Sembazuru/USB-breakout/ClubJameco/Pictures/Image15 - Receptacle-side Test Points placed top.JPG

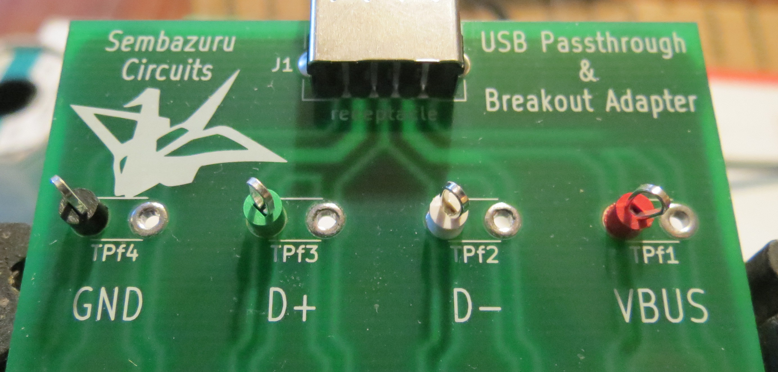
ClubJameco/Pictures/Image15 - Receptacle-side Test Points placed top.JPG
