Sembazuru/USB-breakout/ClubJameco/Pictures/Step8 Collage.jpg

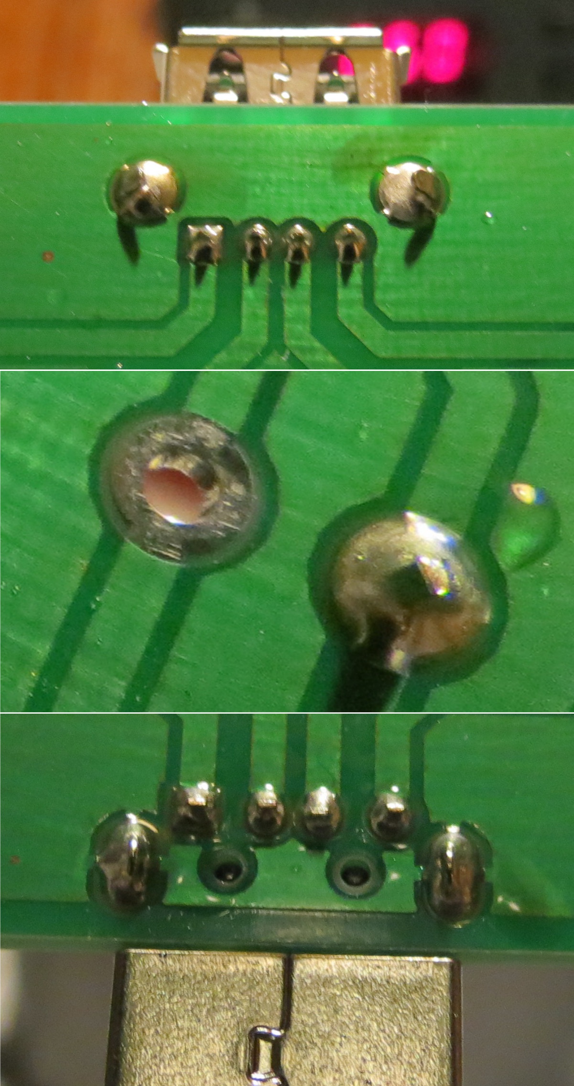
ClubJameco/Pictures/Step8 Collage.jpg
