Sembazuru/USB-breakout/ClubJameco/Pictures/Image02 - Ready to work.JPG

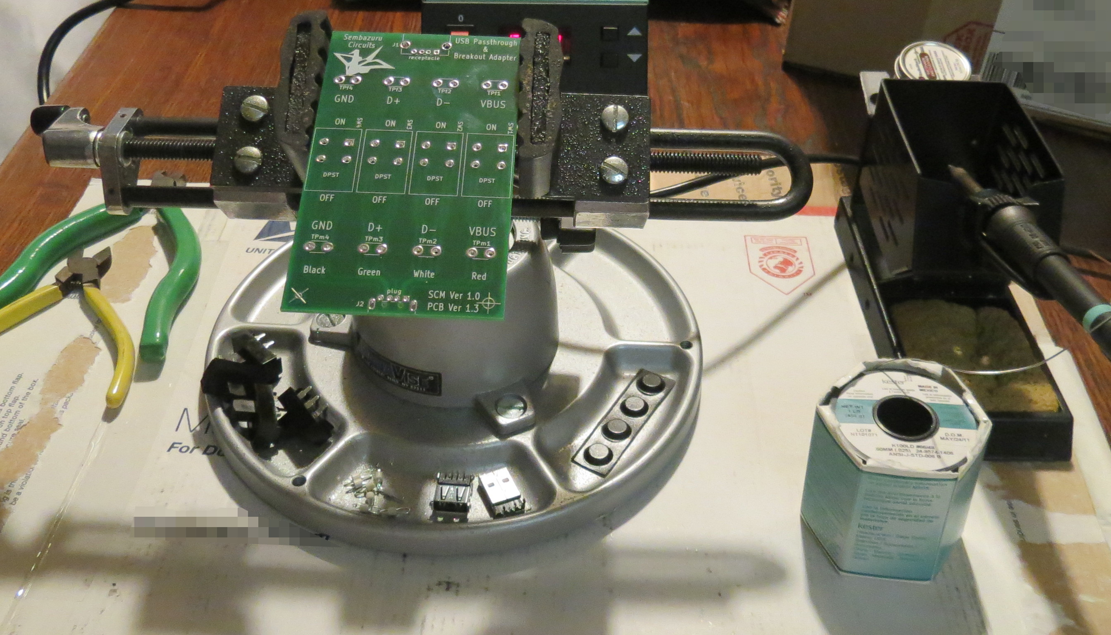
ClubJameco/Pictures/Image02 - Ready to work.JPG
