Sembazuru/USB-breakout/ClubJameco/Pictures/Image03 - Place first switch.JPG

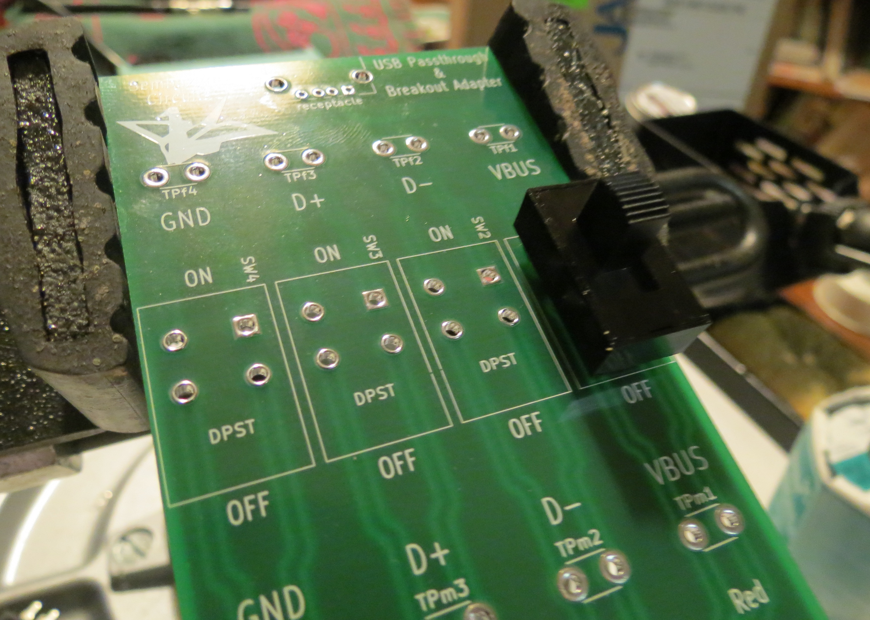
ClubJameco/Pictures/Image03 - Place first switch.JPG
