Sembazuru/USB-breakout/ClubJameco/Pictures/Image04 - Tape first switch.JPG

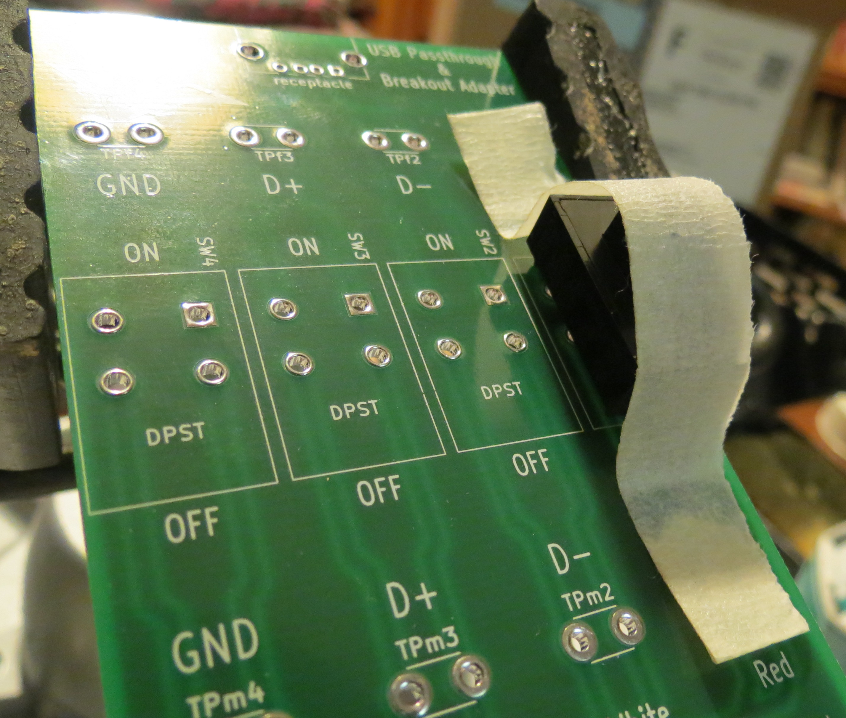
ClubJameco/Pictures/Image04 - Tape first switch.JPG
