Sembazuru/USB-breakout/ClubJameco/Pictures/Image05 - Tape all switches.JPG

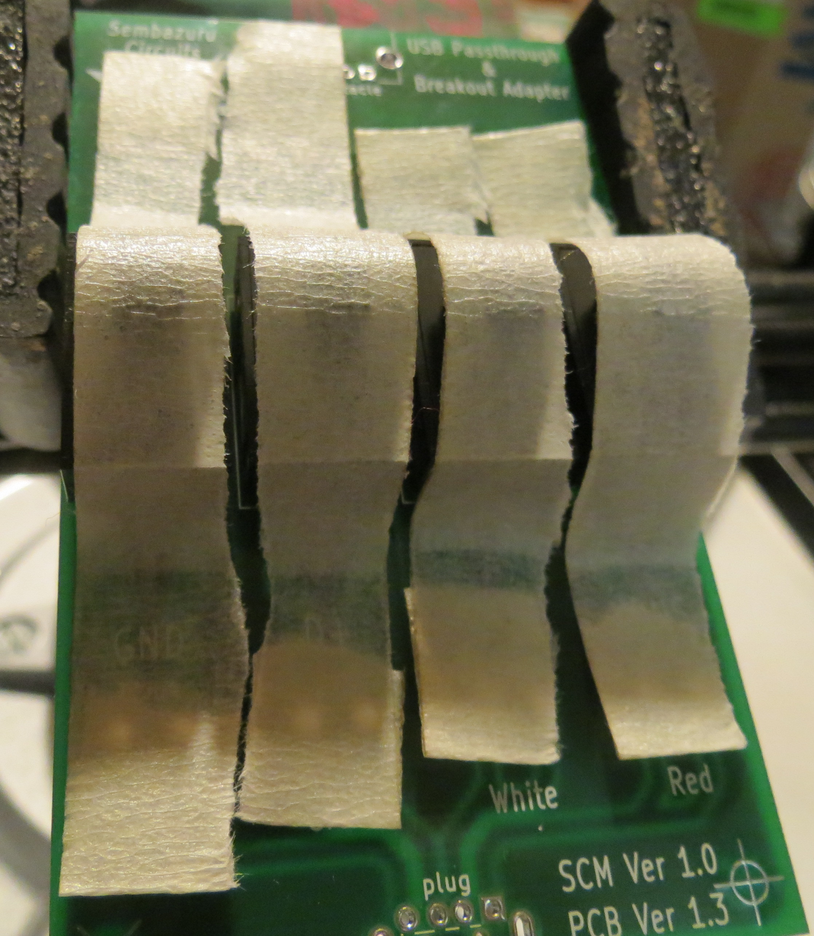
ClubJameco/Pictures/Image05 - Tape all switches.JPG
