Sembazuru/USB-breakout/ClubJameco/Pictures/Image08 - Check switch alignment.JPG

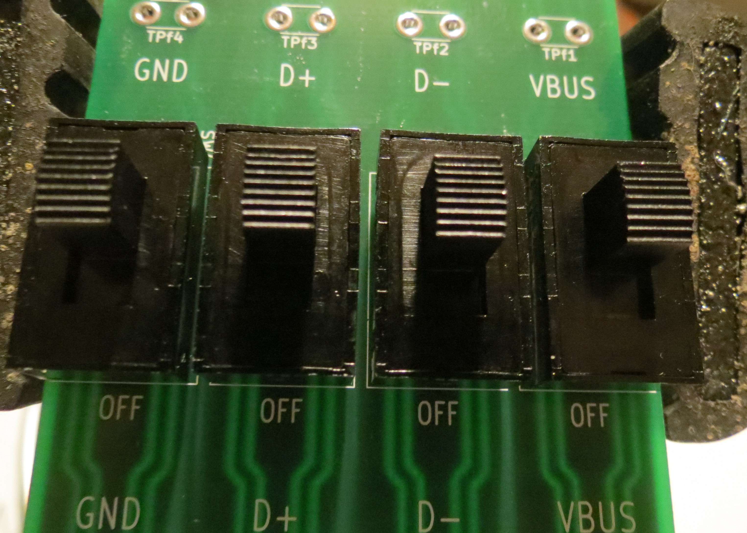
ClubJameco/Pictures/Image08 - Check switch alignment.JPG
