Sembazuru/USB-breakout/ClubJameco/Pictures/Image11 - Receptacle placed top.JPG

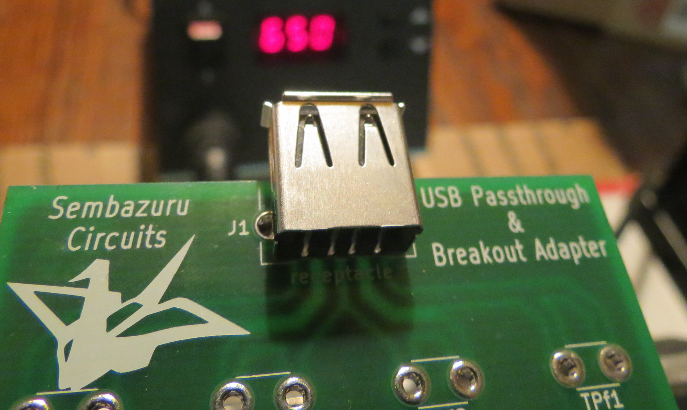
ClubJameco/Pictures/Image11 - Receptacle placed top.JPG
