Sembazuru/USB-breakout/ClubJameco/Pictures/Image12 - Receptacle placed bottom.JPG

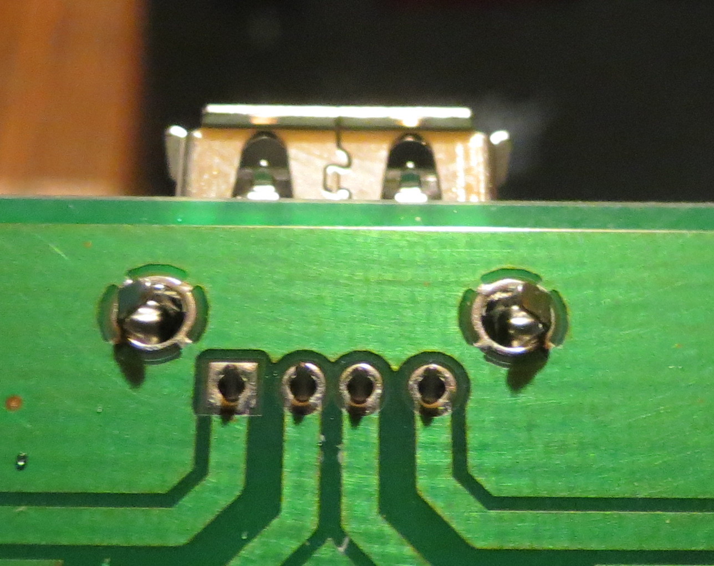
ClubJameco/Pictures/Image12 - Receptacle placed bottom.JPG
