Sembazuru/USB-breakout/ClubJameco/Pictures/Image13 - Plug placed top.JPG

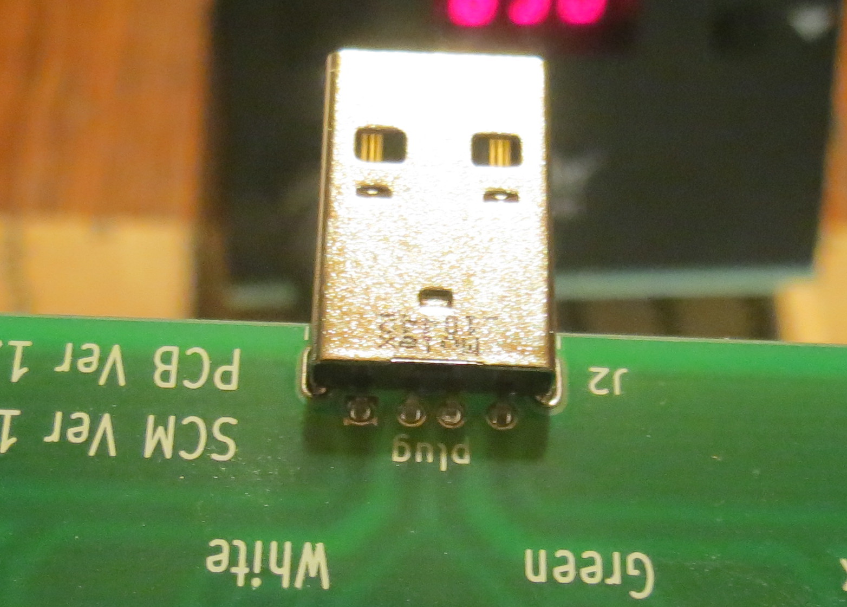
ClubJameco/Pictures/Image13 - Plug placed top.JPG
