Sembazuru/USB-breakout/ClubJameco/Pictures/Image14 - Plug placed bottom.JPG

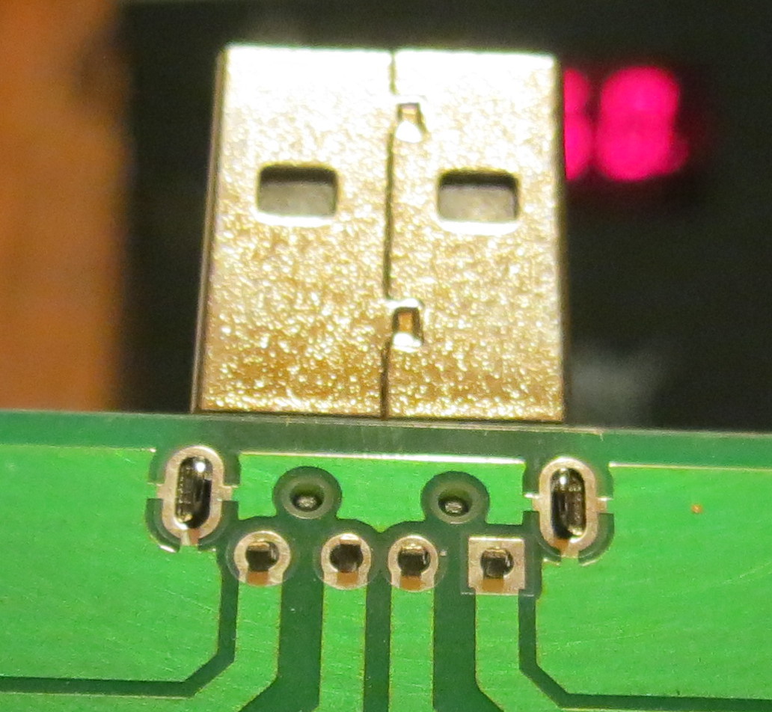
ClubJameco/Pictures/Image14 - Plug placed bottom.JPG
