Sembazuru/USB-breakout/ClubJameco/Pictures/Image24 - Feet added.JPG

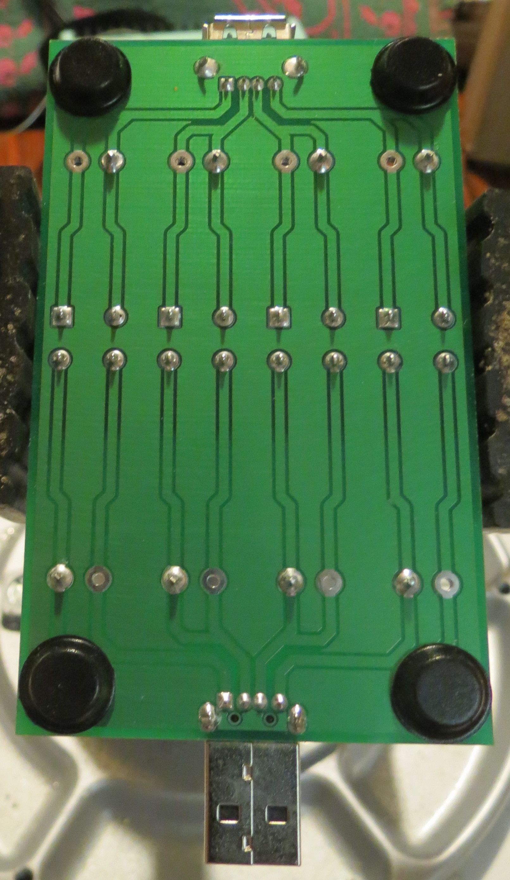
ClubJameco/Pictures/Image24 - Feet added.JPG
