Sembazuru/USB-breakout/ClubJameco/Pictures/IMG_1003.JPG

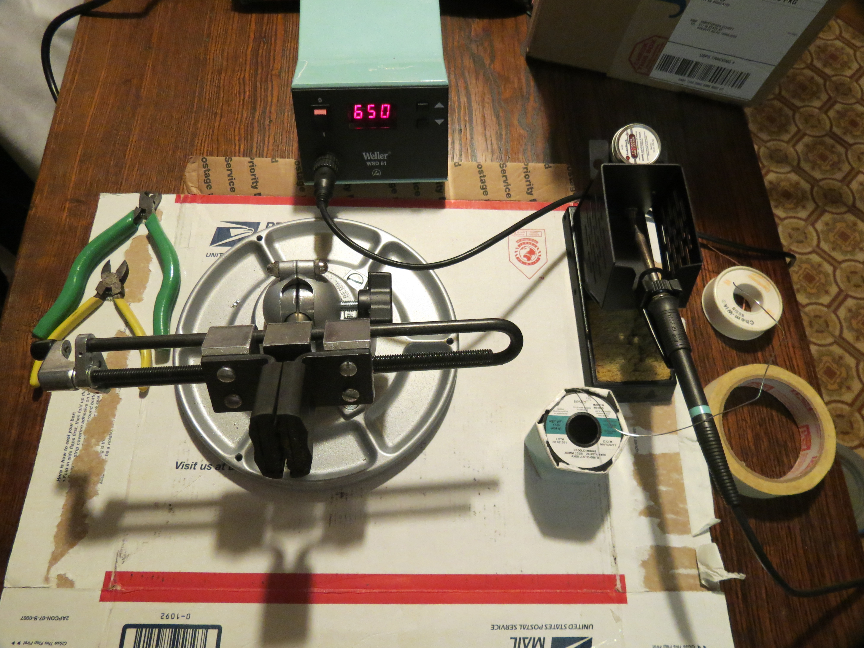
ClubJameco/Pictures/IMG_1003.JPG
