Sembazuru/USB-breakout/ClubJameco/Pictures/IMG_1005.JPG

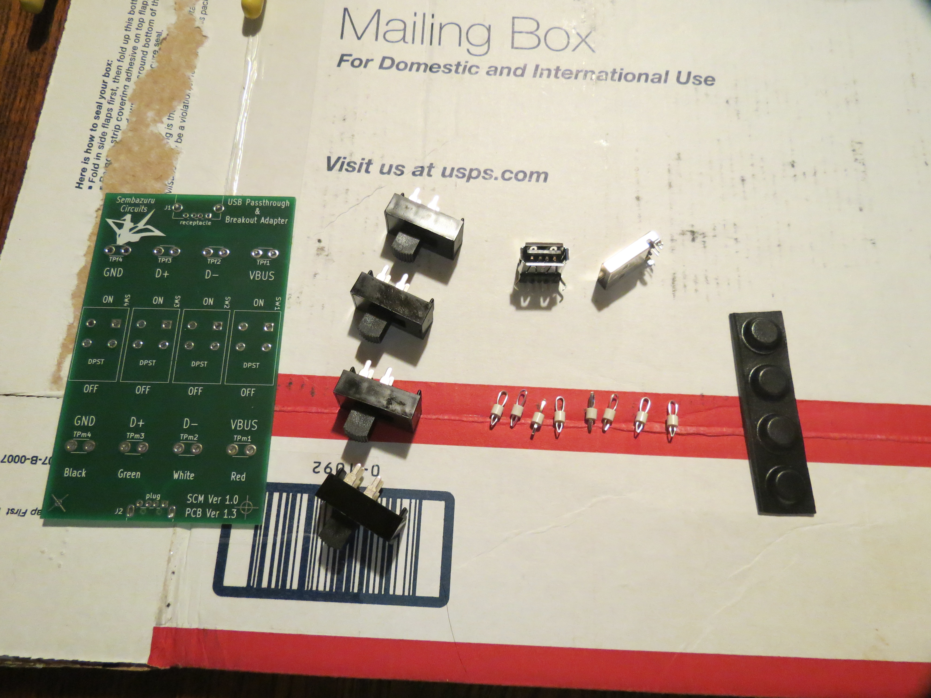
ClubJameco/Pictures/IMG_1005.JPG
