Sembazuru/USB-breakout/ClubJameco/Pictures/IMG_1007.JPG

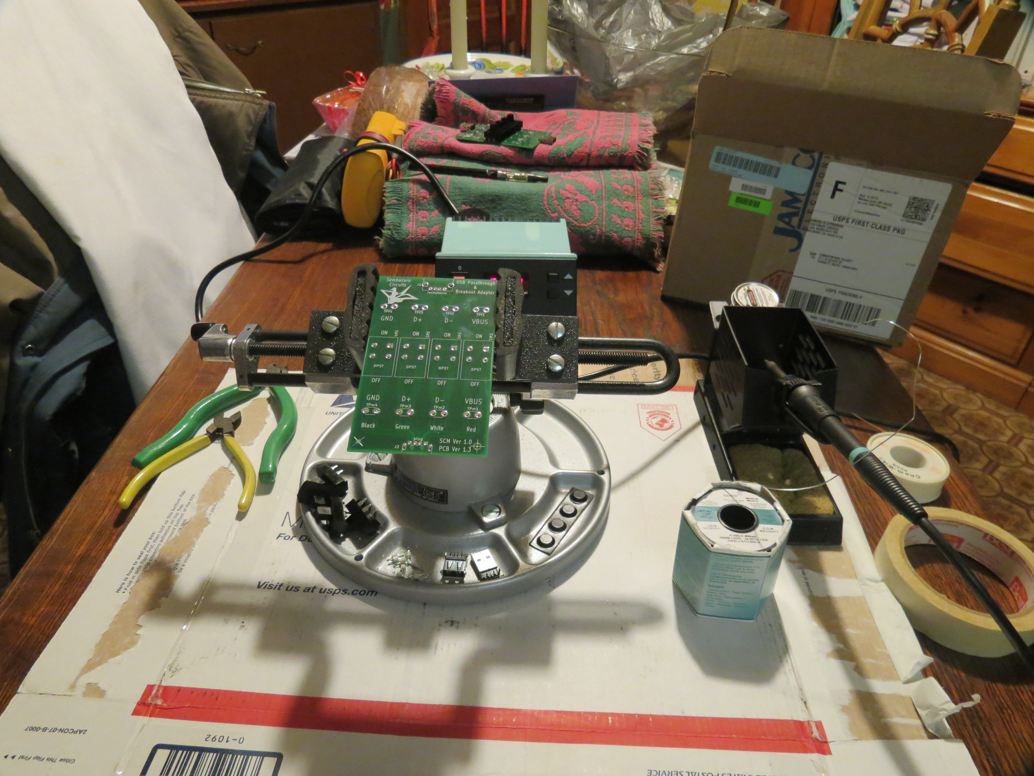
ClubJameco/Pictures/IMG_1007.JPG
