Sembazuru/USB-breakout/ClubJameco/Pictures/IMG_1008.JPG

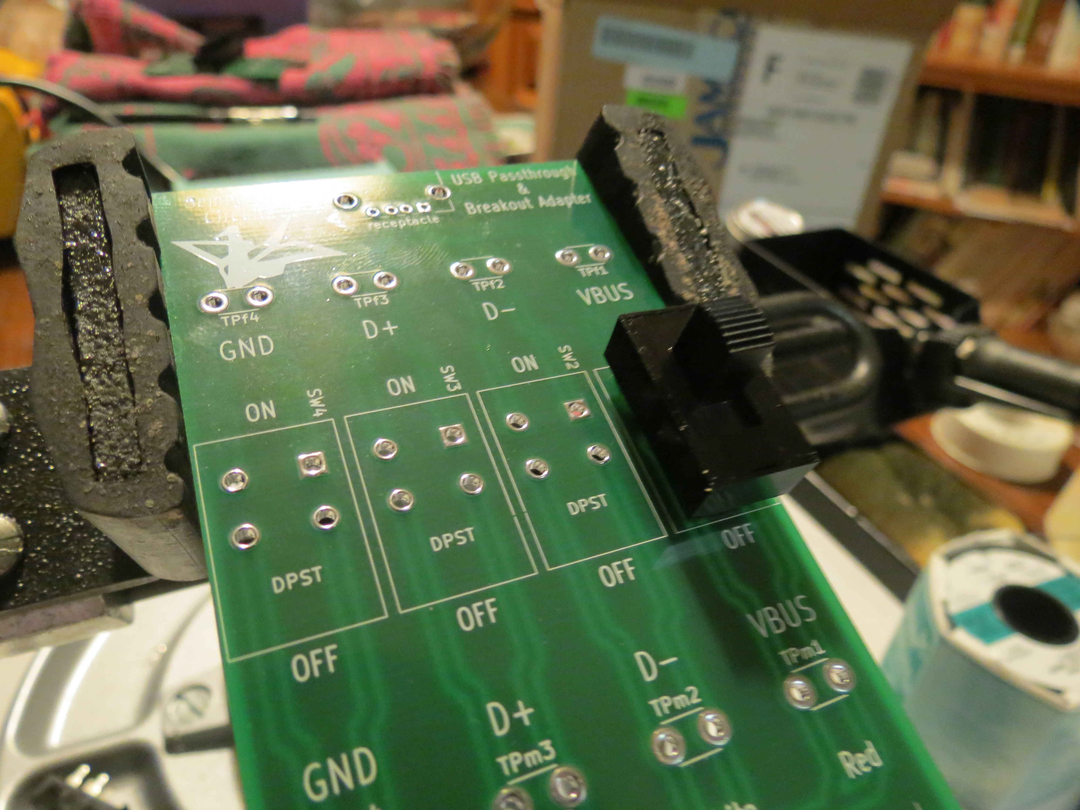
ClubJameco/Pictures/IMG_1008.JPG
