Sembazuru/USB-breakout/ClubJameco/Pictures/IMG_1009.JPG

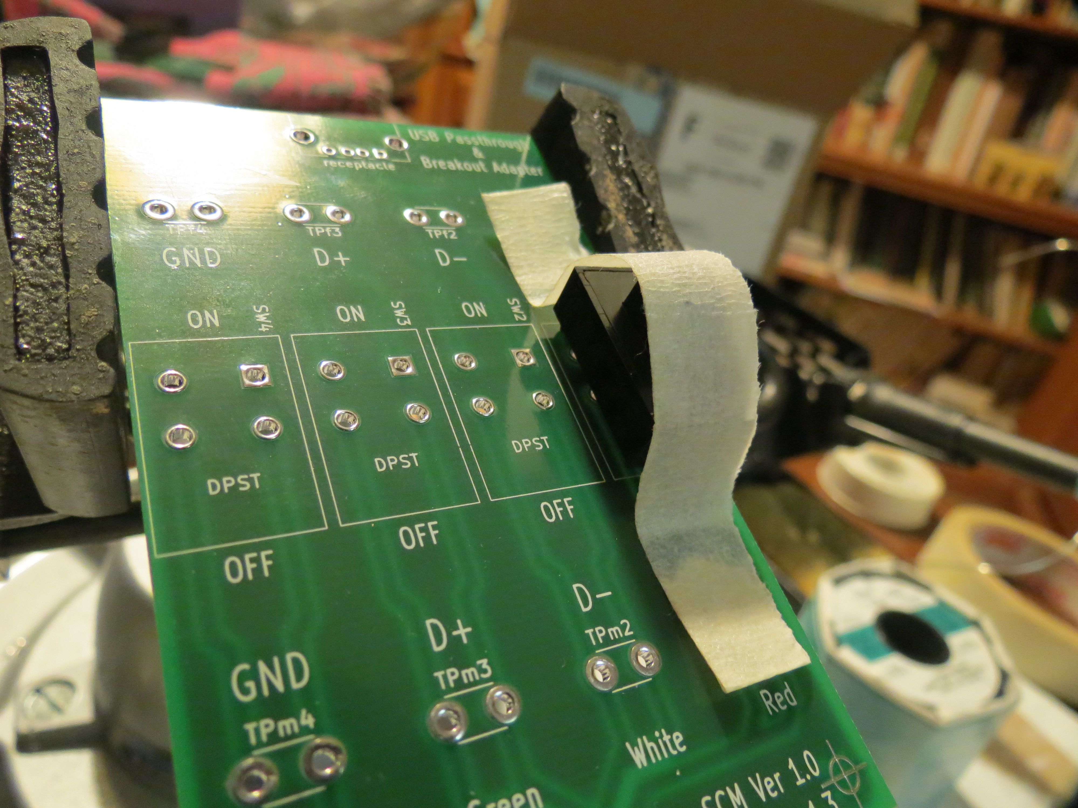
ClubJameco/Pictures/IMG_1009.JPG
