Sembazuru/USB-breakout/ClubJameco/Pictures/IMG_1010.JPG

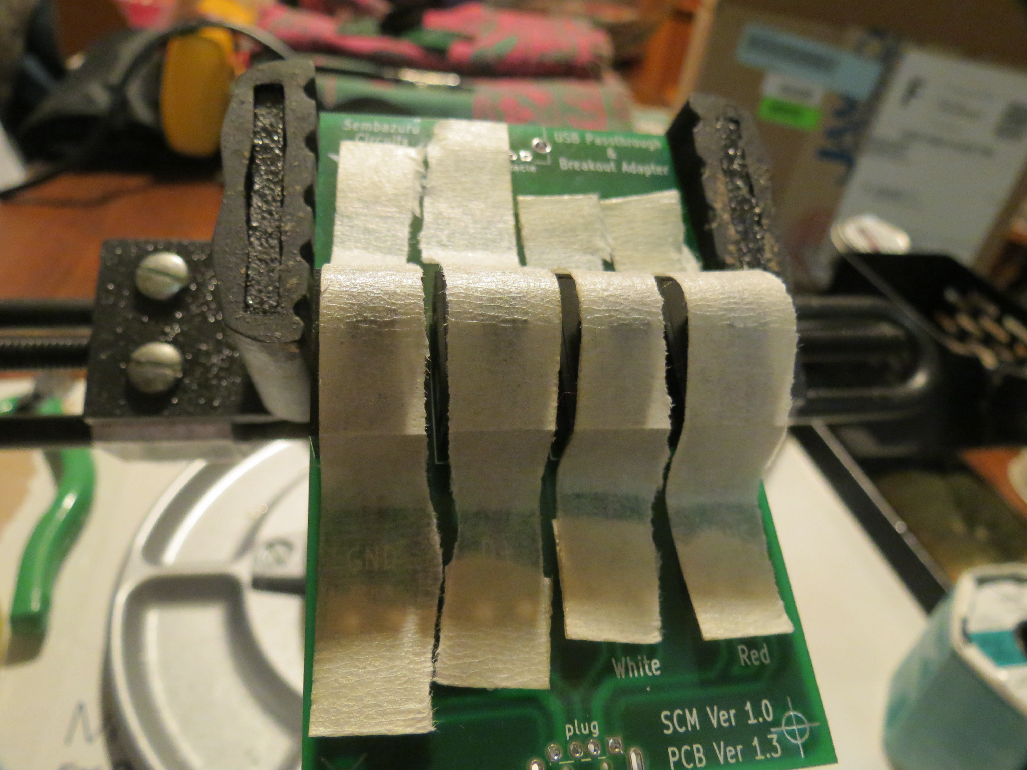
ClubJameco/Pictures/IMG_1010.JPG
