Sembazuru/USB-breakout/ClubJameco/Pictures/IMG_1011.JPG

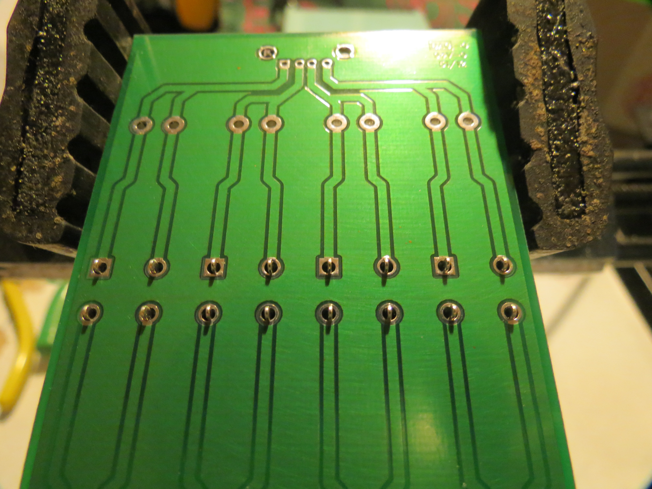
ClubJameco/Pictures/IMG_1011.JPG
