Sembazuru/USB-breakout/ClubJameco/Pictures/IMG_1012.JPG

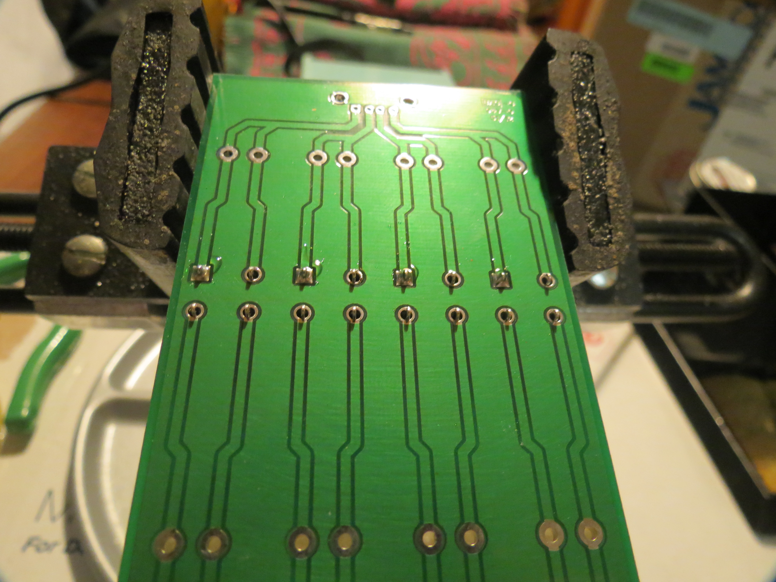
ClubJameco/Pictures/IMG_1012.JPG
