Sembazuru/USB-breakout/ClubJameco/Pictures/IMG_1013.JPG

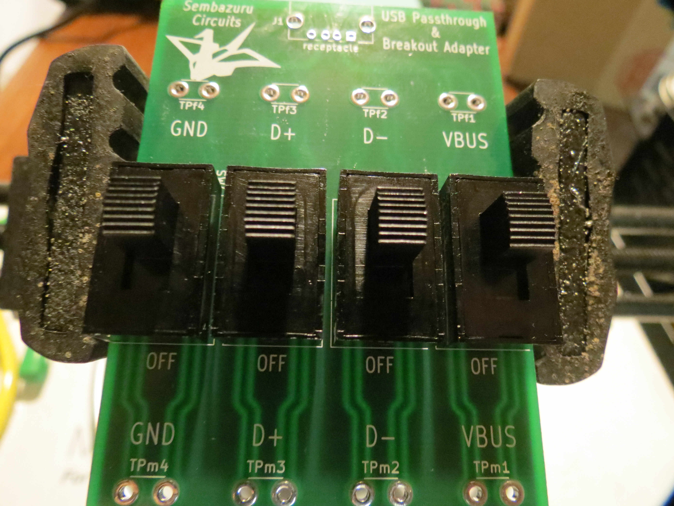
ClubJameco/Pictures/IMG_1013.JPG
