Sembazuru/USB-breakout/ClubJameco/Pictures/IMG_1014.JPG

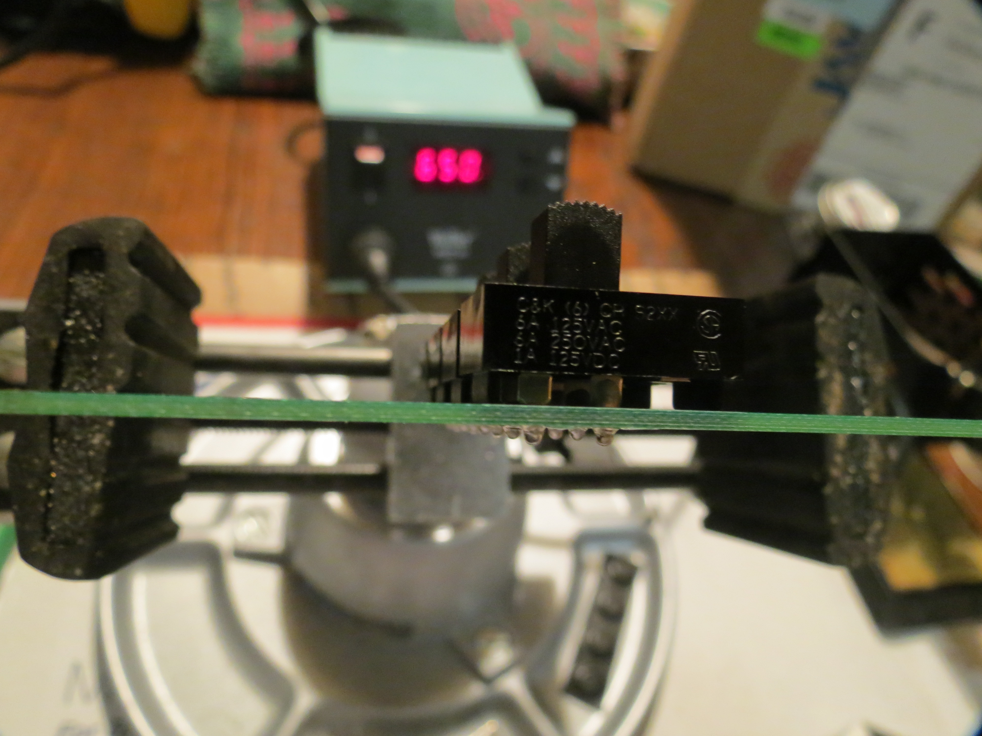
ClubJameco/Pictures/IMG_1014.JPG
