Sembazuru/USB-breakout/ClubJameco/Pictures/IMG_1015.JPG

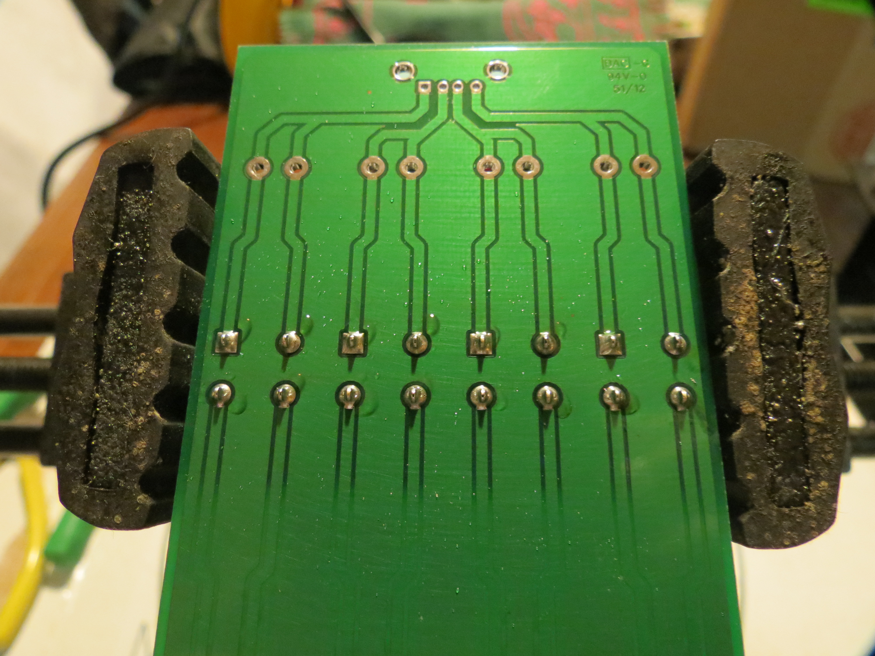
ClubJameco/Pictures/IMG_1015.JPG
