Sembazuru/USB-breakout/ClubJameco/Pictures/IMG_1016.JPG

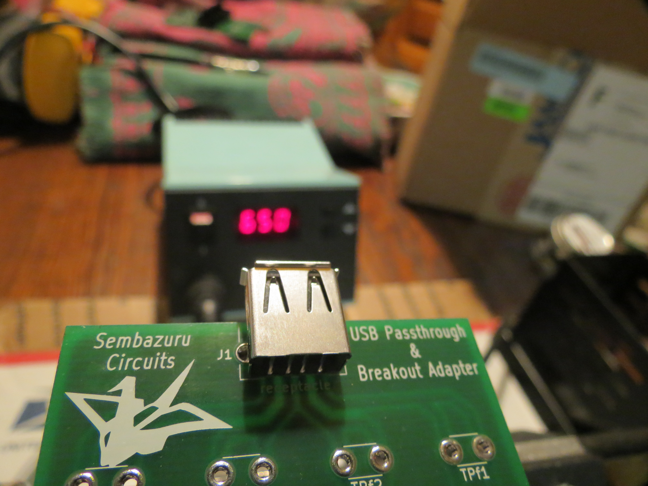
ClubJameco/Pictures/IMG_1016.JPG
