Sembazuru/USB-breakout/ClubJameco/Pictures/IMG_1017.JPG

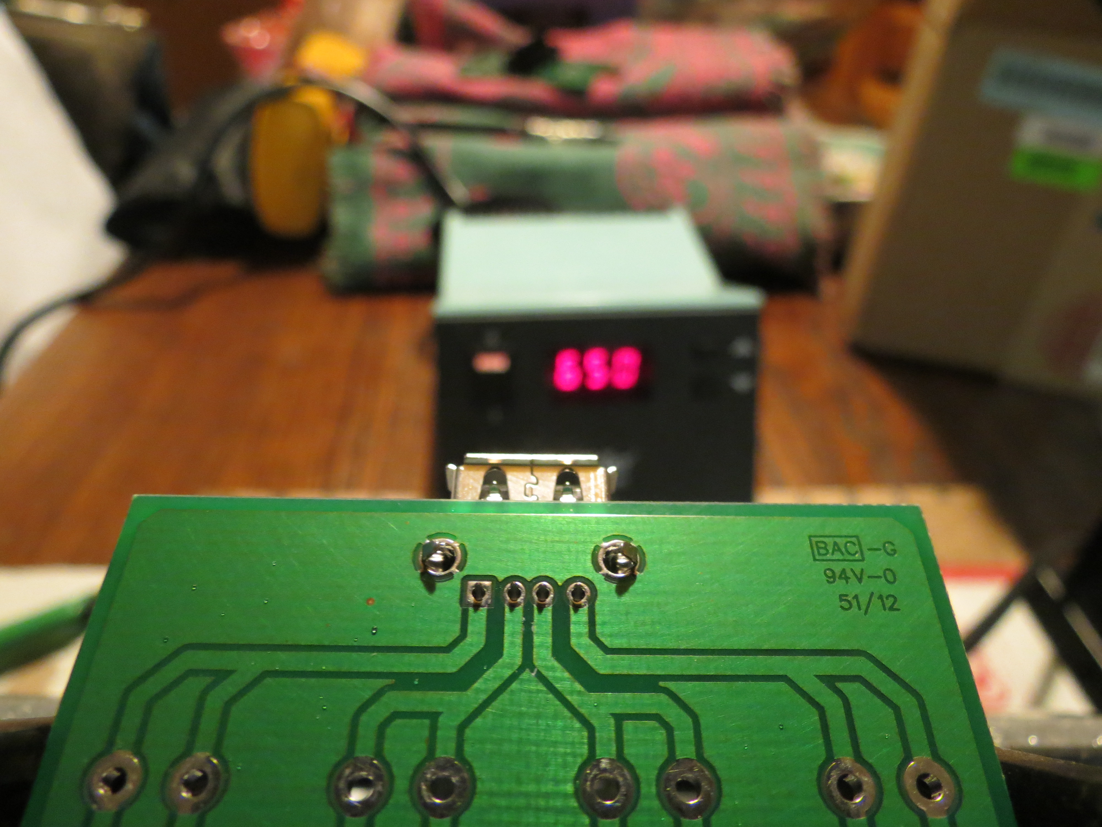
ClubJameco/Pictures/IMG_1017.JPG
