Sembazuru/USB-breakout/ClubJameco/Pictures/IMG_1018.JPG

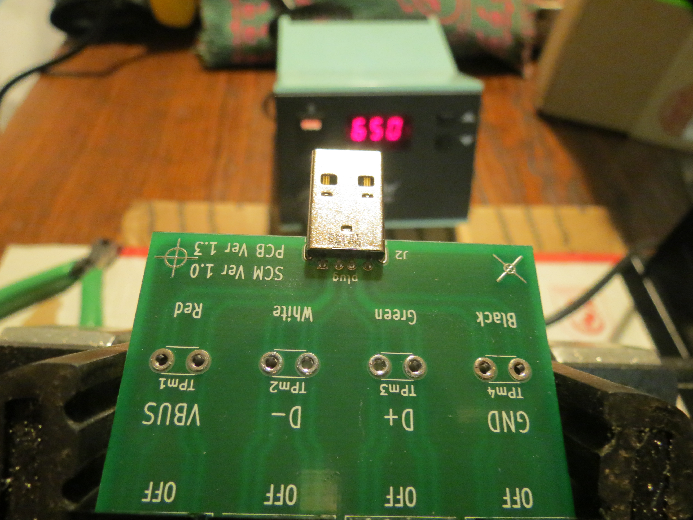
ClubJameco/Pictures/IMG_1018.JPG
