Sembazuru/USB-breakout/ClubJameco/Pictures/IMG_1019.JPG

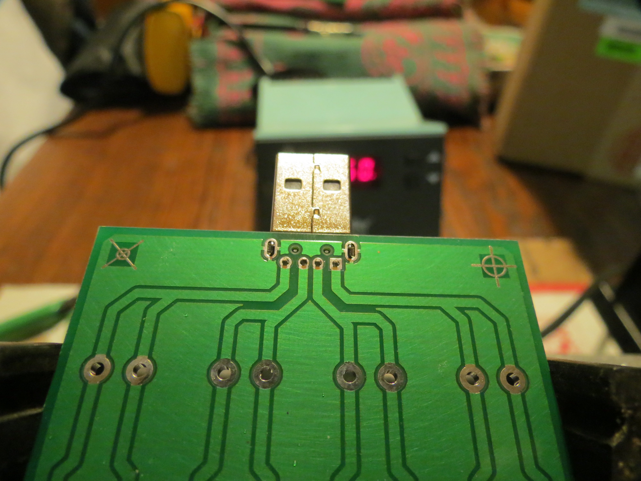
ClubJameco/Pictures/IMG_1019.JPG
