Sembazuru/USB-breakout/ClubJameco/Pictures/IMG_1022.JPG

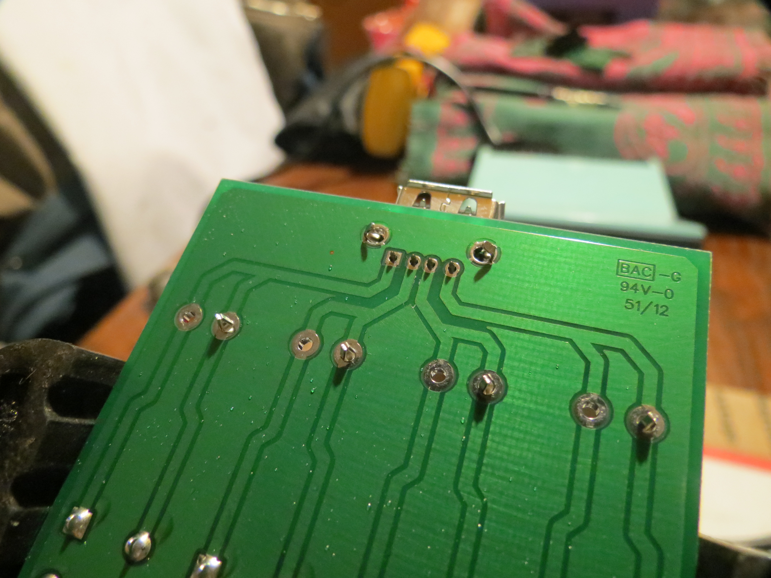
ClubJameco/Pictures/IMG_1022.JPG
