Sembazuru/USB-breakout/ClubJameco/Pictures/IMG_1024.JPG

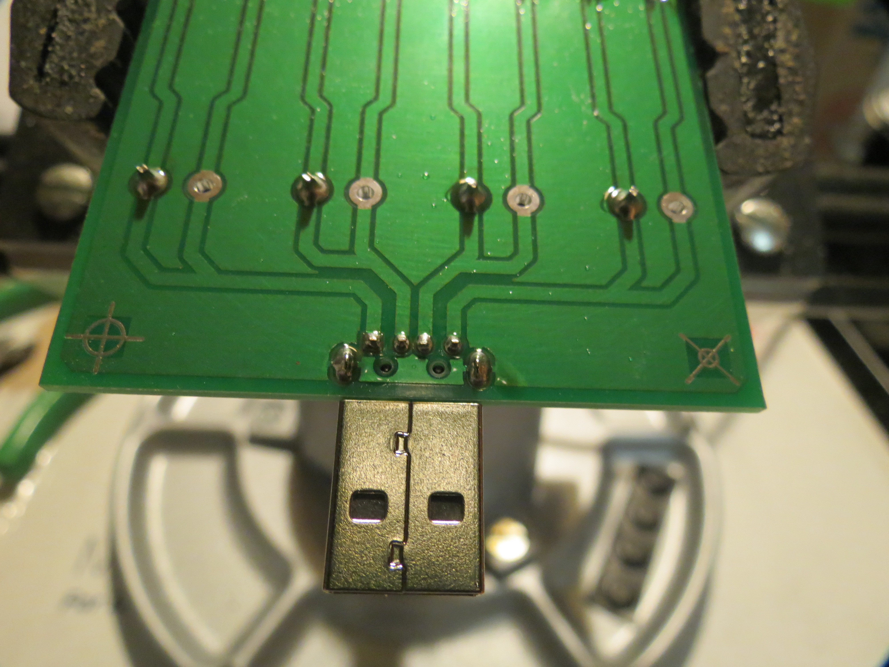
ClubJameco/Pictures/IMG_1024.JPG
