Sembazuru/USB-breakout/ClubJameco/Pictures/IMG_1025.JPG

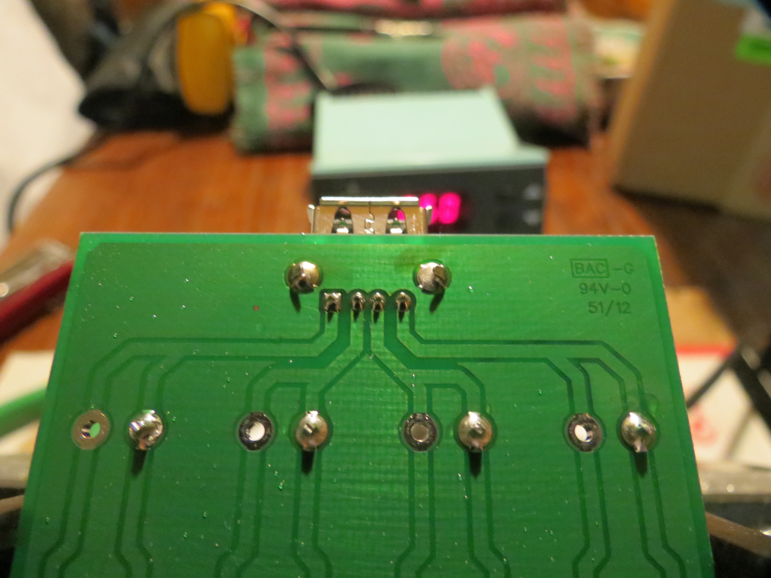
ClubJameco/Pictures/IMG_1025.JPG
