Sembazuru/USB-breakout/ClubJameco/Pictures/IMG_1026.JPG

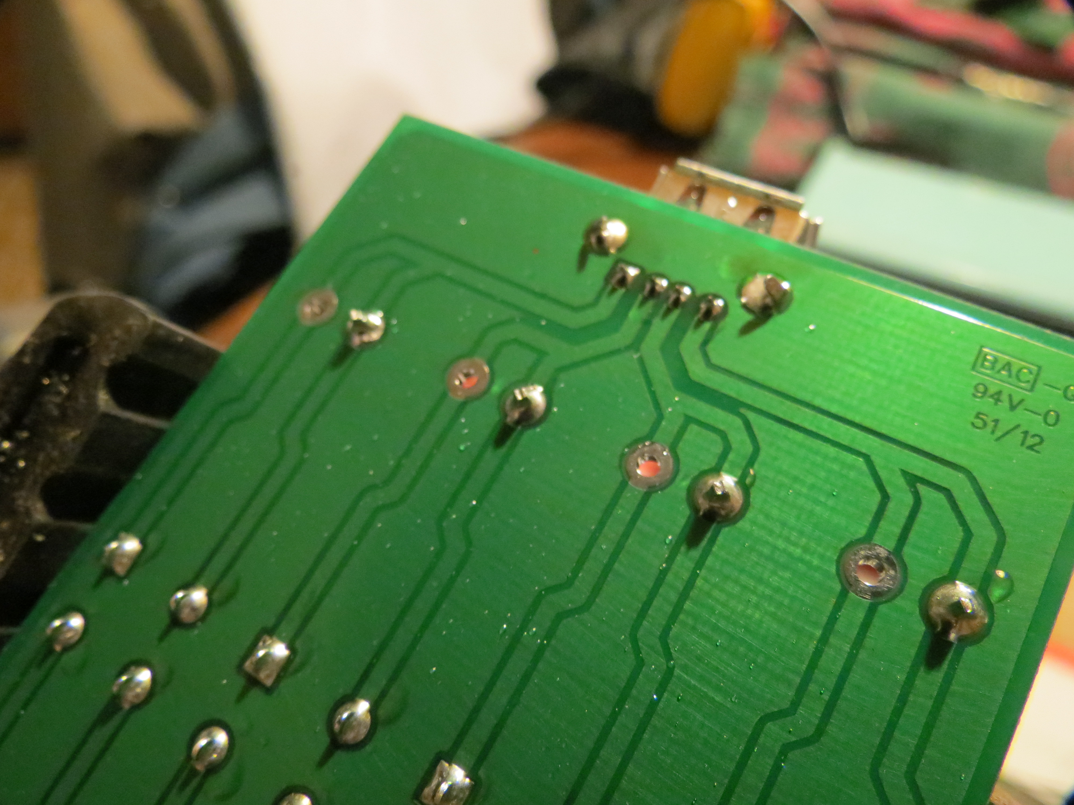
ClubJameco/Pictures/IMG_1026.JPG
