Sembazuru/USB-breakout/ClubJameco/Pictures/IMG_1028.JPG

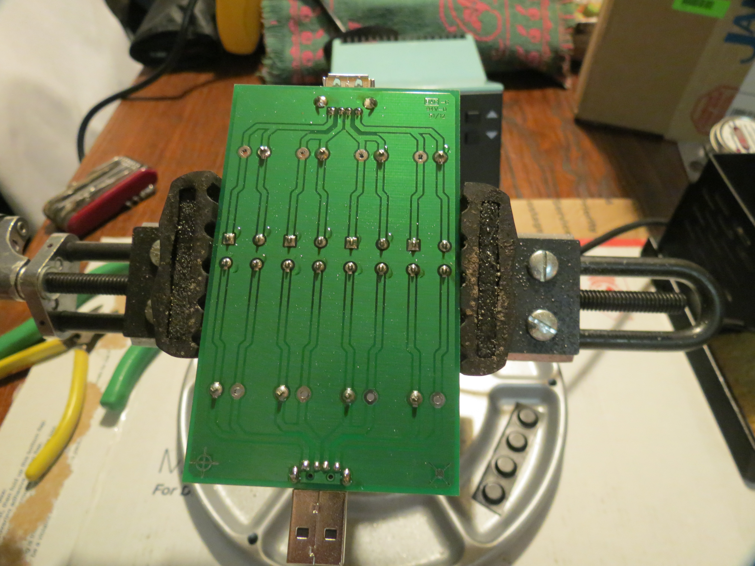
ClubJameco/Pictures/IMG_1028.JPG
