Sembazuru/USB-breakout/ClubJameco/Pictures/IMG_1029.JPG

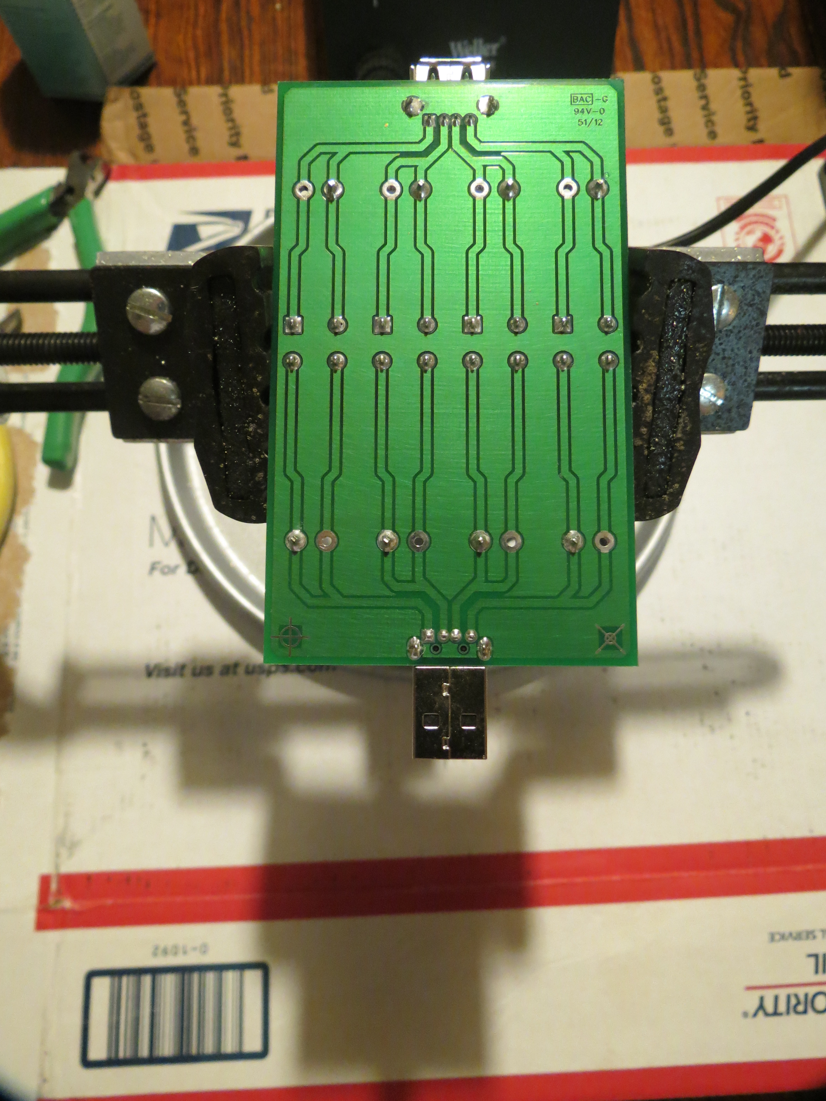
ClubJameco/Pictures/IMG_1029.JPG
