Sembazuru/USB-breakout/ClubJameco/Pictures/IMG_1030.JPG

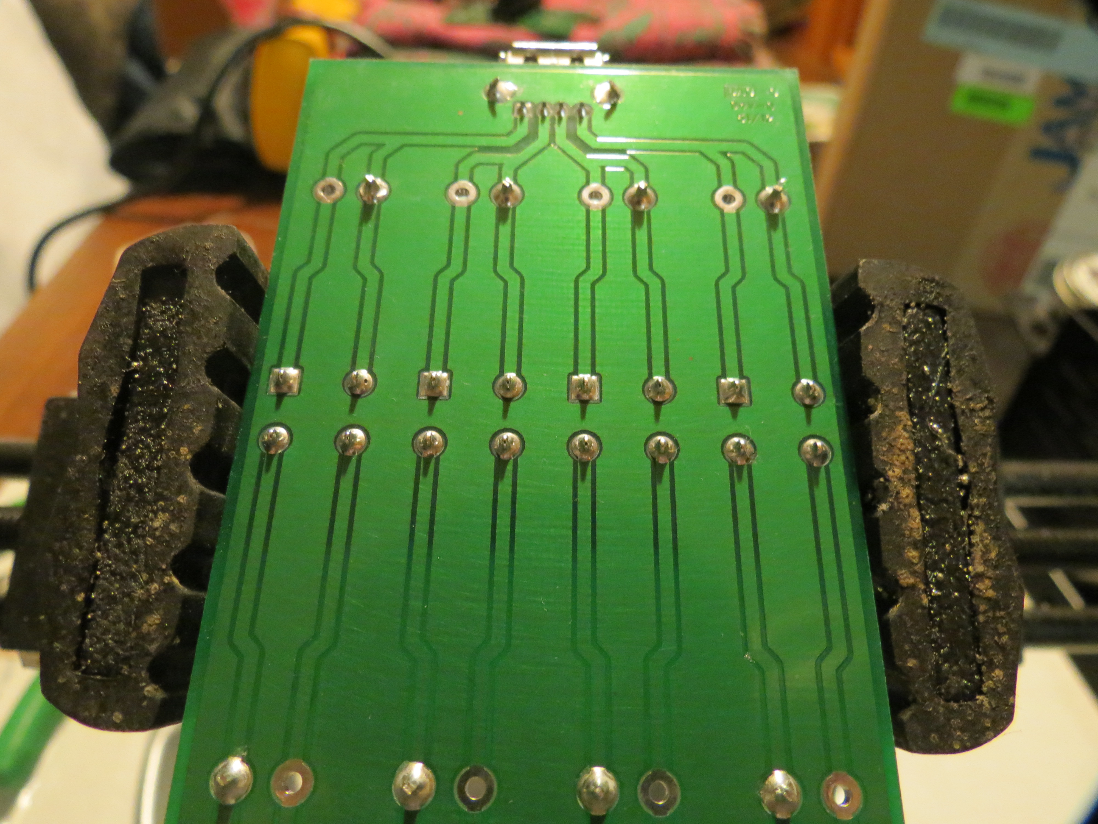
ClubJameco/Pictures/IMG_1030.JPG
