Sembazuru/USB-breakout/ClubJameco/Pictures/IMG_1031.JPG

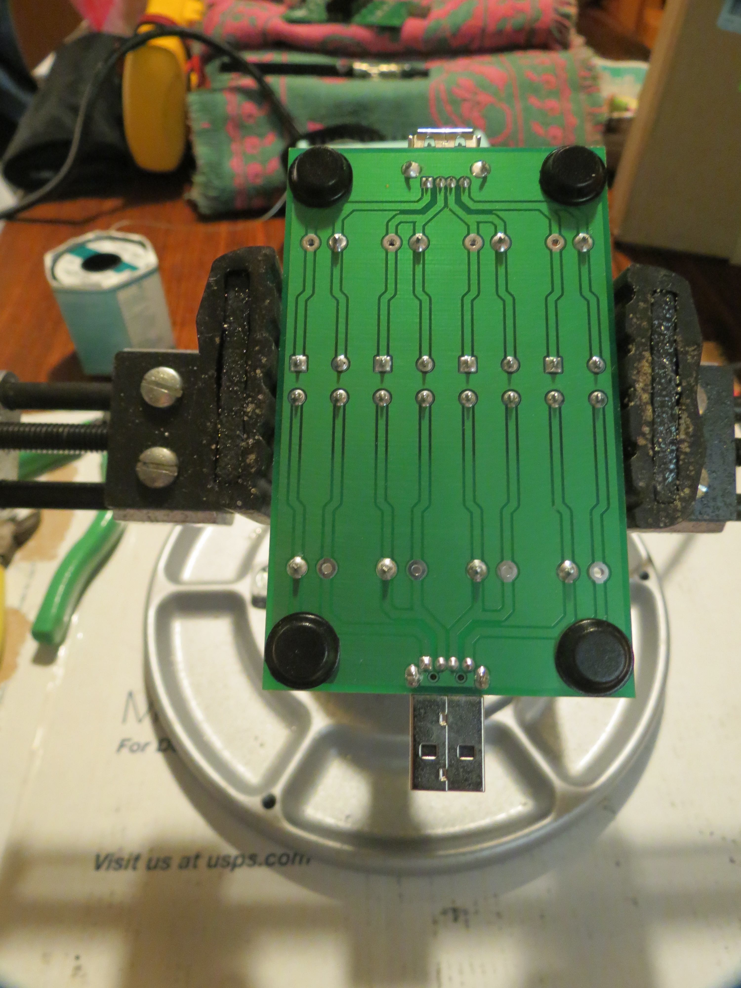
ClubJameco/Pictures/IMG_1031.JPG
