Sembazuru/USB-breakout/ClubJameco/Pictures/IMG_1037.JPG

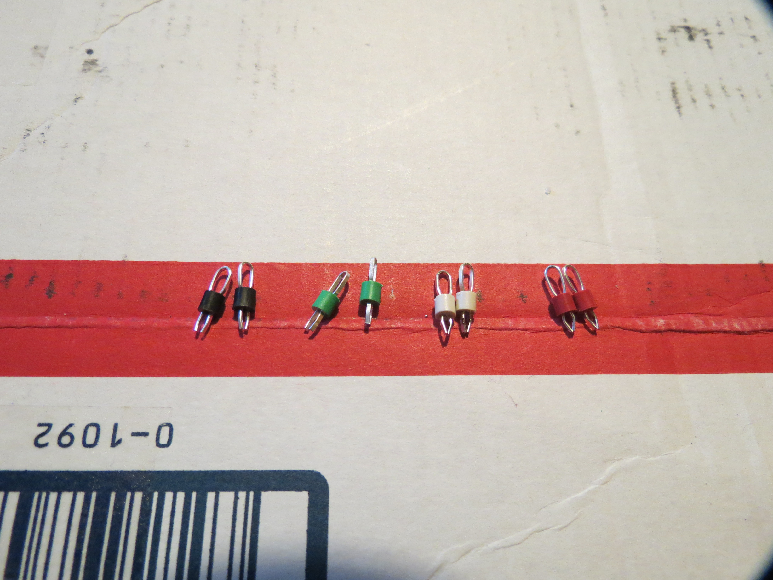
ClubJameco/Pictures/IMG_1037.JPG
