Sembazuru/USB-breakout/ClubJameco/Pictures/IMG_1039.JPG

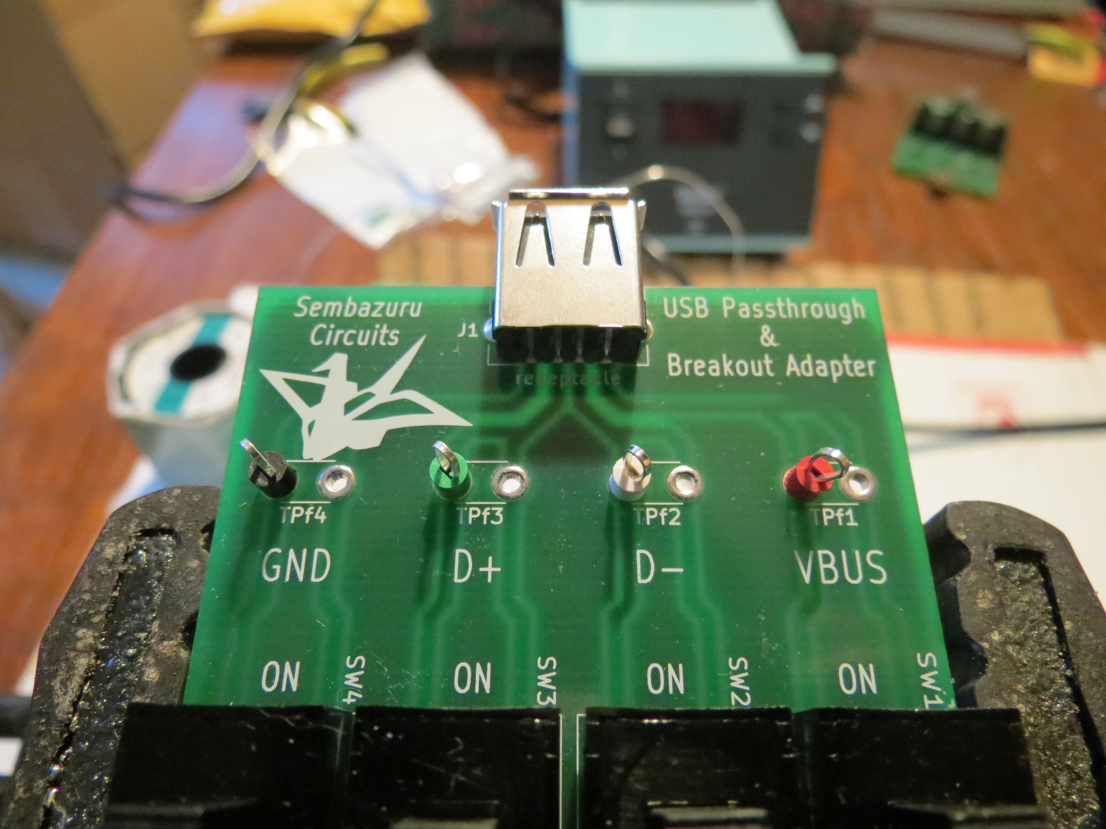
ClubJameco/Pictures/IMG_1039.JPG
