Sembazuru/USB-breakout/ClubJameco/Pictures/IMG_1042.JPG

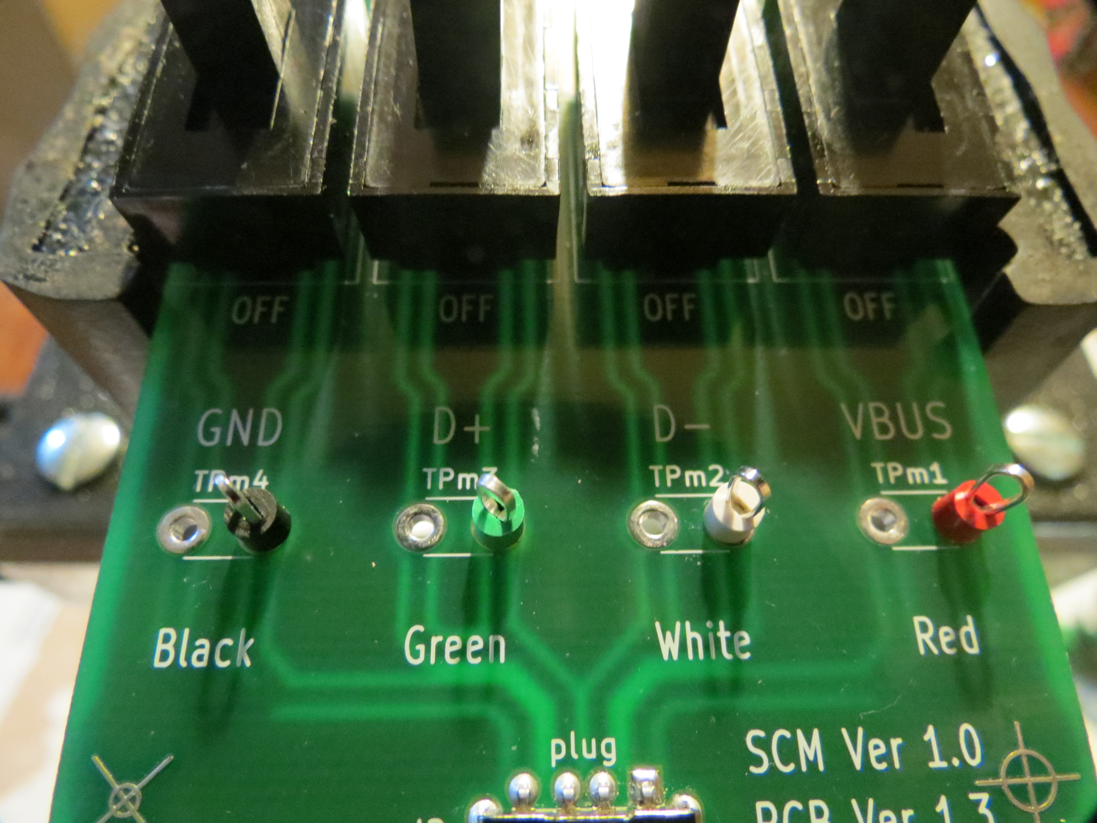
ClubJameco/Pictures/IMG_1042.JPG
