Sembazuru/USB-breakout/ClubJameco/Pictures/IMG_1046.JPG

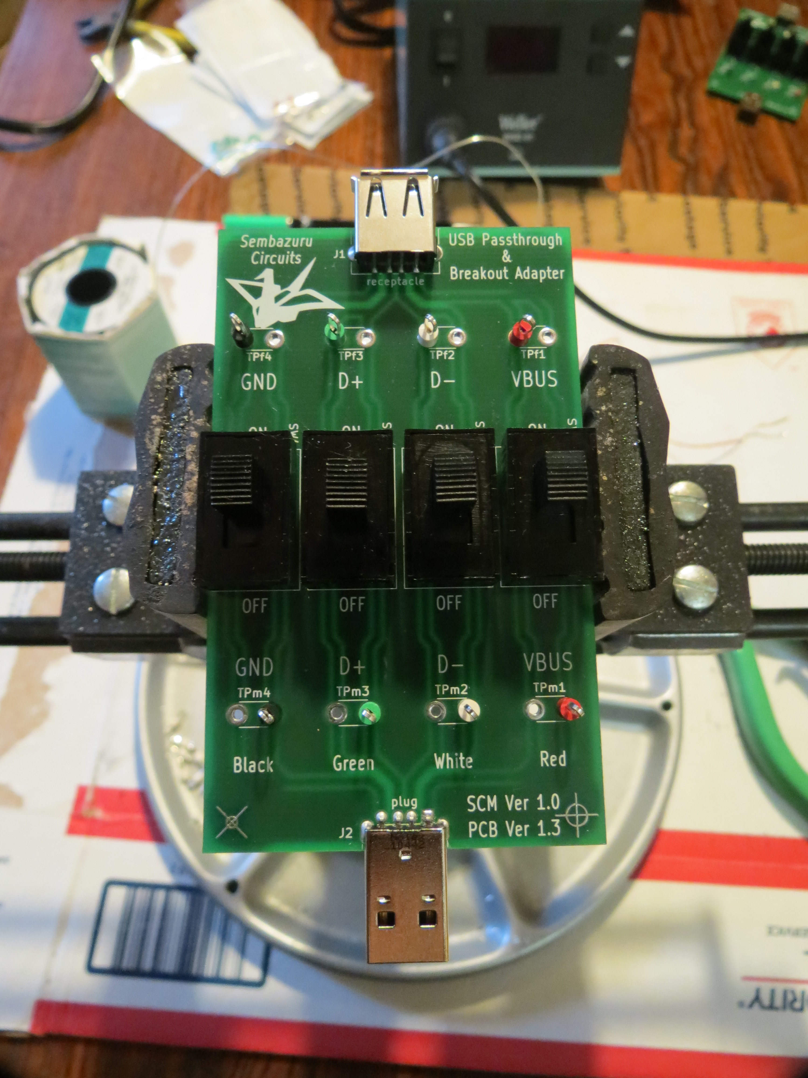
ClubJameco/Pictures/IMG_1046.JPG
