Sembazuru/USB-breakout/ClubJameco/Pictures/IMG_1053.JPG

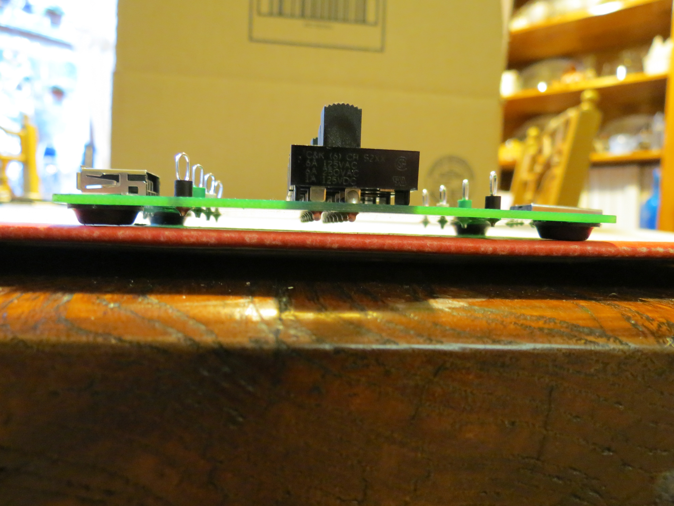
ClubJameco/Pictures/IMG_1053.JPG
