Sembazuru/USB-breakout/ClubJameco/Pictures/IMG_1055.JPG

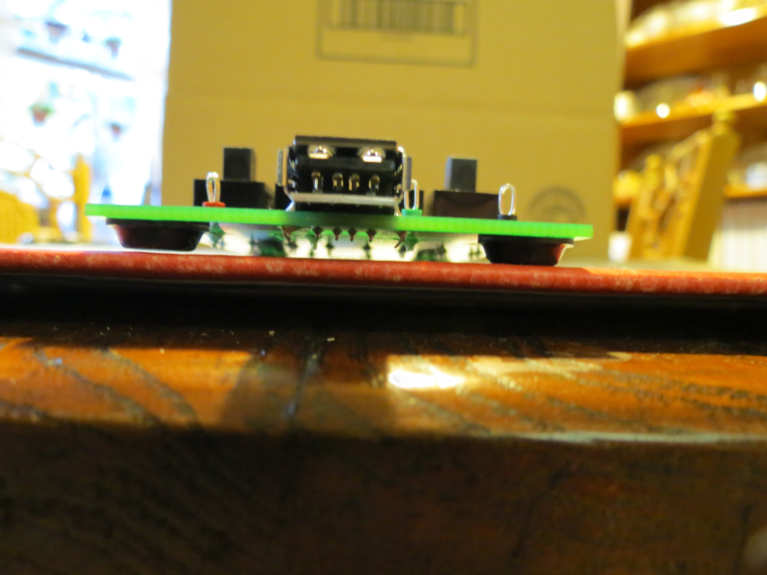
ClubJameco/Pictures/IMG_1055.JPG
