Sembazuru/USB-breakout/ClubJameco/Pictures/IMG_1057.JPG

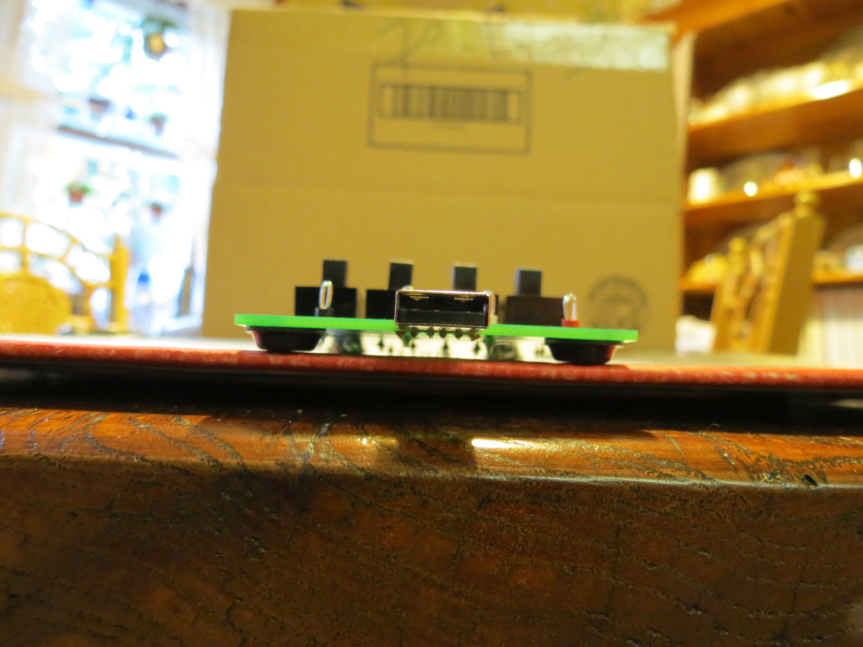
ClubJameco/Pictures/IMG_1057.JPG
