Sembazuru/USB-breakout/ClubJameco/Pictures/IMG_1058.JPG

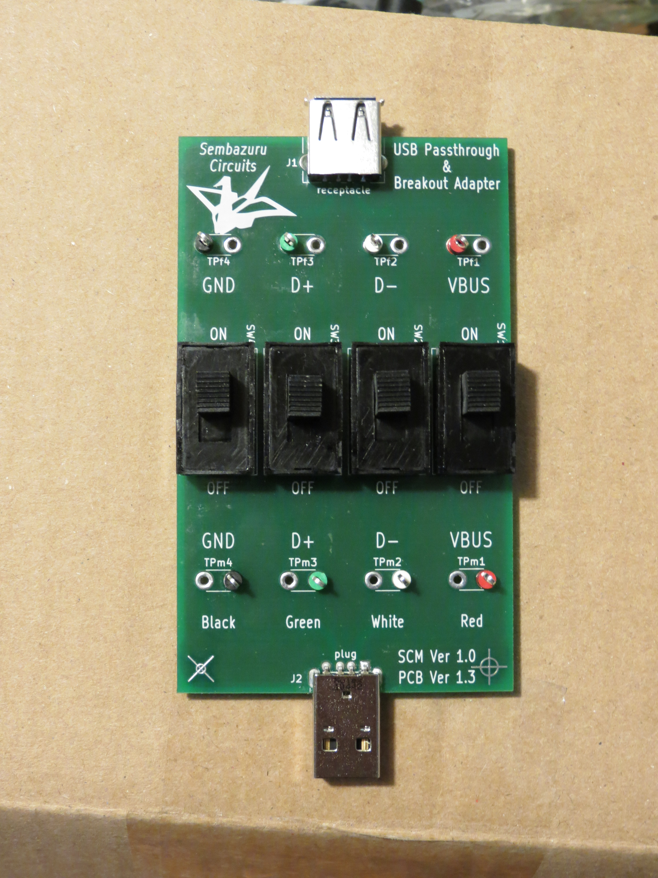
ClubJameco/Pictures/IMG_1058.JPG
