Sembazuru/USB-breakout/ClubJameco/Pictures/IMG_1059.JPG

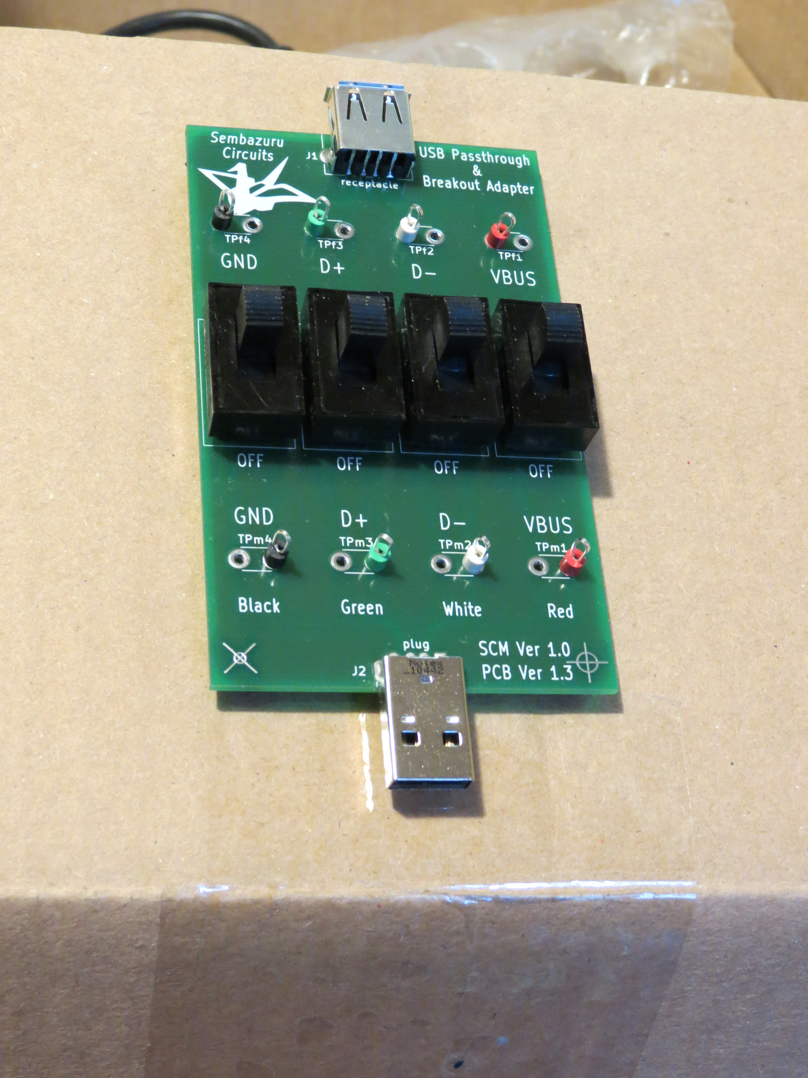
ClubJameco/Pictures/IMG_1059.JPG
