Sembazuru/USB-breakout/ClubJameco/Pictures/Overview1.JPG

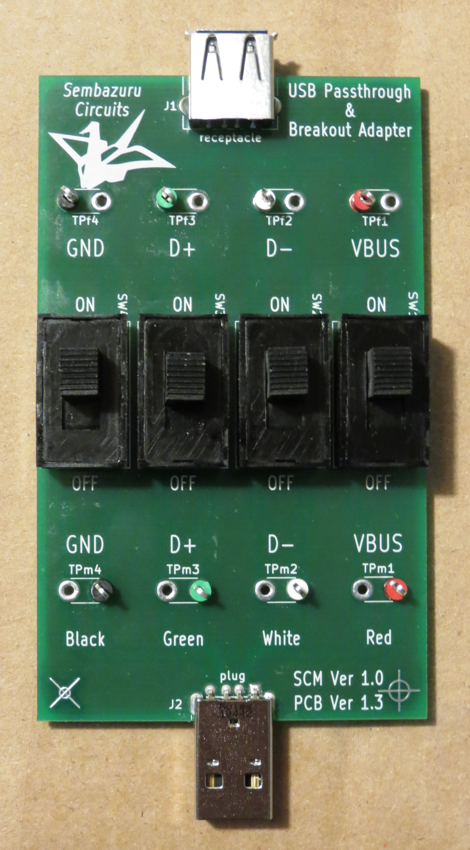
ClubJameco/Pictures/Overview1.JPG
