Sembazuru/USB-breakout/ClubJameco/Pictures/Overview2.JPG

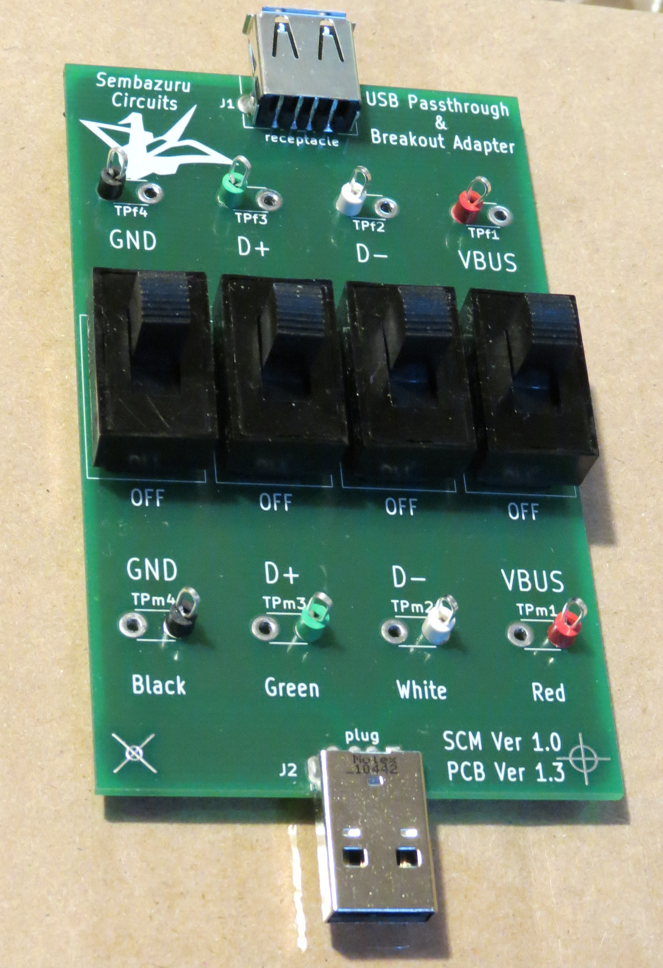
ClubJameco/Pictures/Overview2.JPG
