Sembazuru/USB-breakout/ClubJameco/Pictures/PCBv1.3bottom.JPG

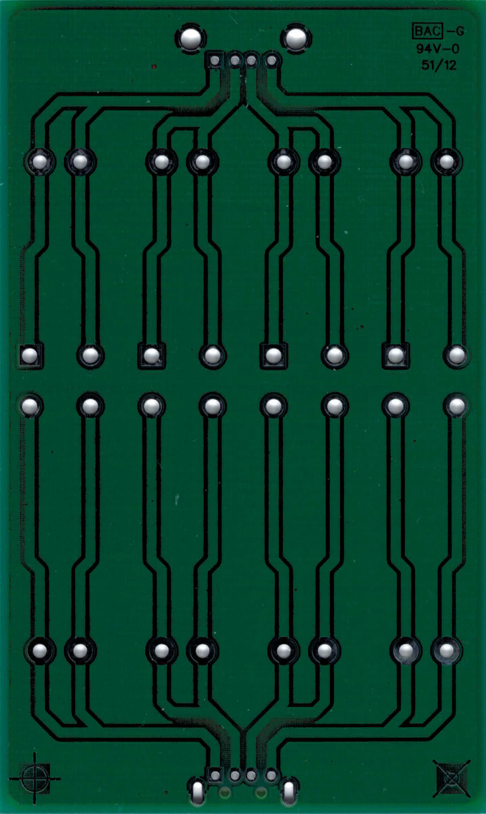
ClubJameco/Pictures/PCBv1.3bottom.JPG
