Sembazuru/USB-breakout/ClubJameco/Pictures/PCBv1.3top.JPG

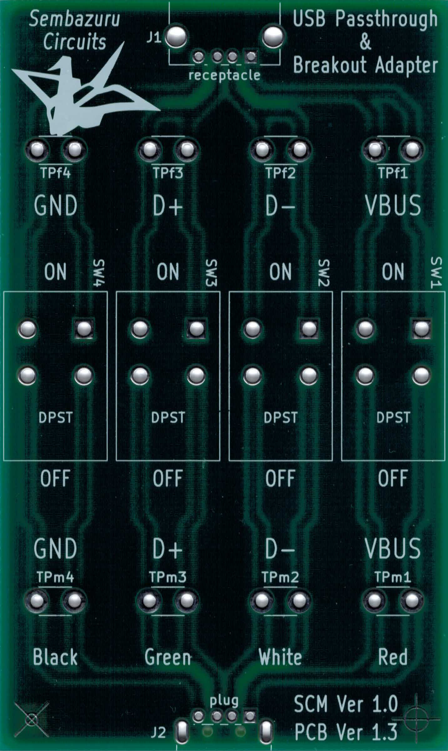
ClubJameco/Pictures/PCBv1.3top.JPG
