Sembazuru/USB-breakout/USB Breakout v1.1 500dpi indexed.png

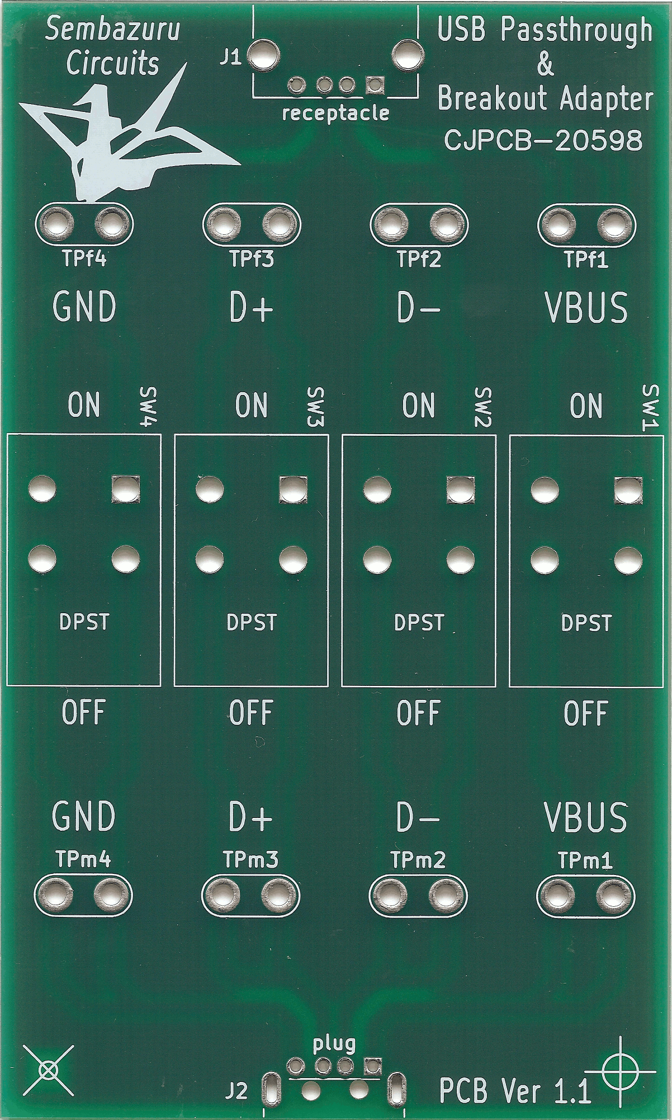
USB Breakout v1.1 500dpi indexed.png
