Sembazuru/USB-breakout/USB Breakout v2.0.png

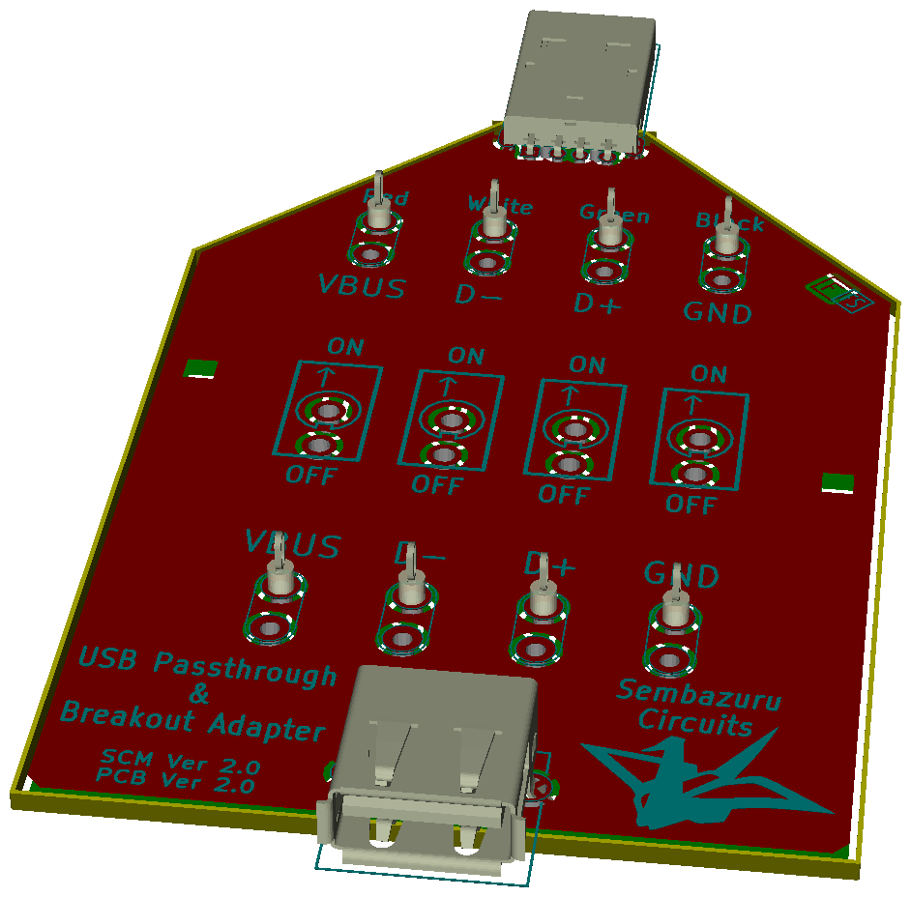
USB Breakout v2.0.png
