Sembazuru/USB-breakout/USB Breakout v3.0.png

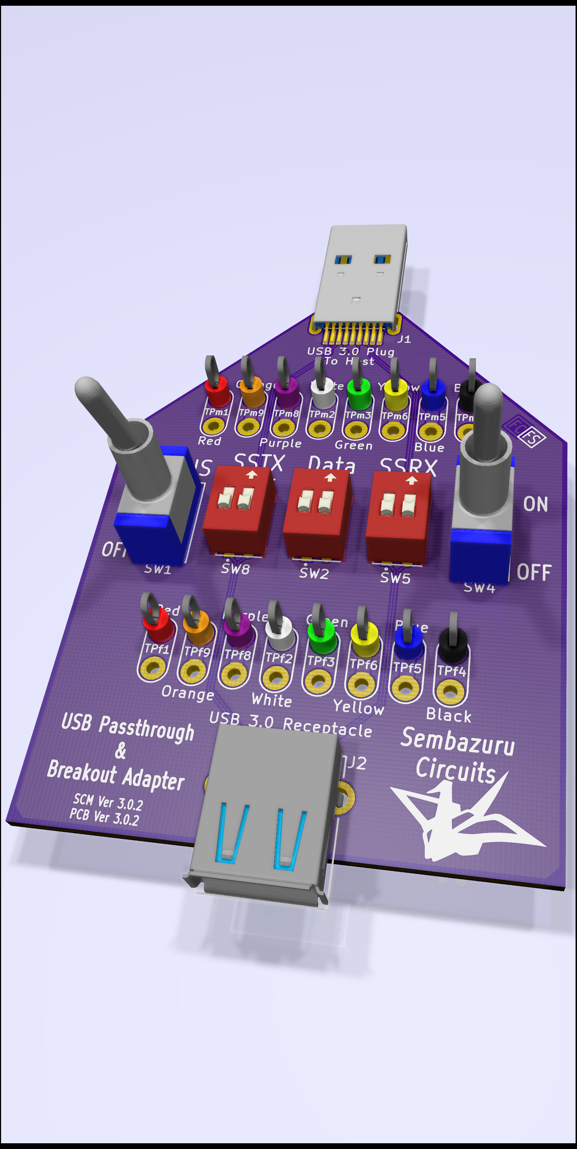
USB Breakout v3.0.png
