Sembazuru/USB-breakout/USB Breakout.png

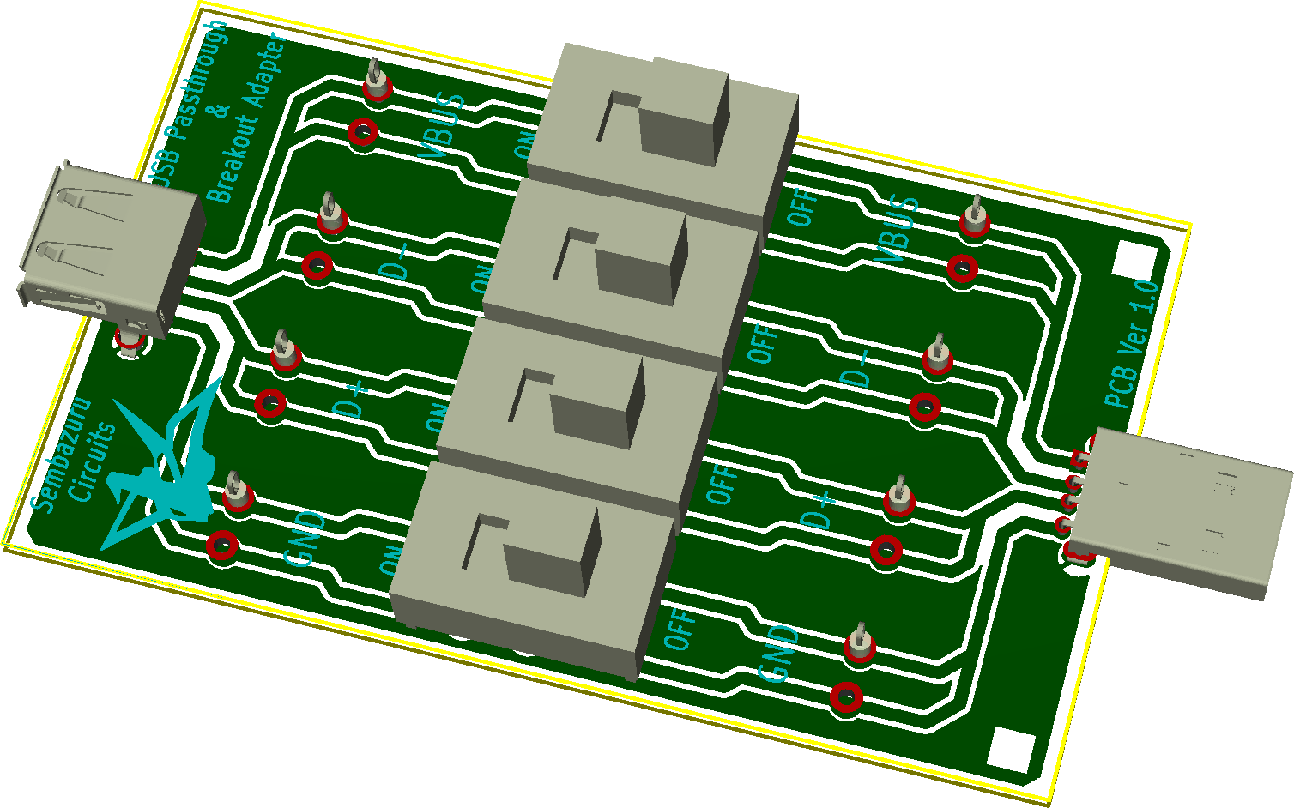
USB Breakout.png
