Sembazuru/USB-breakout/USB Breakout v3.xlsx

Prj: | USB 3.0 Cable Breakout Tester |  |  |  |  |  | Board Qty: | 100
Co.: | Sembazuru Circuits |  |  |  |  |  | Unit Cost: | $0.00
Prj date: | 18/03/2018 01:43:44 |  |  |  |  |  | Total Cost: | $0.00 |  |  |  | $0.00 | 0 |  |  |  | $0.00 | 0 |  |  |  | $0.00 | 0 |  |  |  | $0.00 | 0 |  |  |  | $0.00 | 0 |  |  |  | $0.00 | 0
$ date: | 2018-03-18 22:50:40
Global Part Info |  |  |  |  |  |  |  |  | Digi-Key |  |  |  |  | Farnell |  |  |  |  | Mouser |  |  |  |  | Newark |  |  |  |  | Rs Components |  |  |  |  | Tme
Refs | Value | Desc | Footprint | Manf | Manf# | Qty | Unit$ | Ext$ | Avail | Purch | Unit$ | Ext$ | Cat# | Avail | Purch | Unit$ | Ext$ | Cat# | Avail | Purch | Unit$ | Ext$ | Cat# | Avail | Purch | Unit$ | Ext$ | Cat# | Avail | Purch | Unit$ | Ext$ | Cat# | Avail | Purch | Unit$ | Ext$ | Cat#
J1 | USB 3.0 Plug | Analogous to programming comments. | ipc-7251TH-connectors:Amphenol_GSB316441CEU | Amphenol | GSB316441CEU | 0 | $0.00 | $0.00 | 52373 |  | $0.00 | $0.00 | GSB316441CEUCT-ND (http://www.digikey.com/product-detail/en/amphenol-commercial-products/GSB316441CEU/GSB316441CEUCT-ND/2330643) | NonStk |  | $0.00 | $0.00 | 2708969 (http://it.farnell.com/webapp/wcs/stores/servlet/Search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) | 9274 |  | $0.00 | $0.00 | 523-GSB316441CEU (https://www.mouser.com/Search/Refine.aspx?Keyword=GSB316441CEU+) | 5139 |  | $0.00 | $0.00 | 11AC4533 (http://www.newark.com/webapp/wcs/stores/servlet/Search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) |  |  |  |  |  | 410 |  | $0.00 | $0.00 | GSB316441CEU (https://www.tme.eu/en/details/gsb316441ceu/usb-ieee1394-connectors/amphenol/)
J2 | USB 3.0 Receptacle | Analogous to programming comments. | ipc-7251TH-connectors:Amphenol_GSB311131HR | Amphenol | GSB311131HR | 0 | $0.00 | $0.00 | NonStk |  | $0.00 | $0.00 | GSB311131HR-ND (http://www.digikey.com/scripts/DkSearch/dksus.dll?WT.z_header=search_go&lang=en) | NonStk |  | $0.00 | $0.00 | 2708962 (http://it.farnell.com/amphenol-commercial-products/gsb311131hr/conn-usb-3-0-tipo-a-presa-tht/dp/2708962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) | 6107 |  | $0.00 | $0.00 | 523-GSB311131HR (https://www.mouser.com/Search/Refine.aspx?Keyword=GSB311131HR+) | 1820 |  | $0.00 | $0.00 | 11AC4532 (http://www.newark.com/webapp/wcs/stores/servlet/Search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) |  |  |  |  |  | 73 |  | $0.00 | $0.00 | GSB311131HR (https://www.tme.eu/en/details/gsb311131hr/usb-ieee1394-connectors/amphenol/)
SW1,SW4 | SPST |  | ipc-7251TH-non-standard:SW_Jameco2135478U | GOLDSUN ELECTRONICS | T100T1B4A2 | 0 | $0.00 | $0.00
SW2,SW5,SW8 | 2xSPST |  | ipc-7251TH-standard:DIPSW762W57P254L608H570Q4U | GOLDSUN ELECTRONICS | 206-2-VP-R | 0 | $0.00 | $0.00
TPm1,TPf1 | Red | VBus Test Point | CDE_misc:TESTPOINT | Keystone Electronics | 5010 | 0 | $0.00 | $0.00 | 281000 |  | $0.00 | $0.00 | 36-5010-ND (http://www.digikey.com/scripts/DkSearch/dksus.dll?WT.z_header=search_go&lang=en) |  |  |  |  |  | 43520 |  | $0.00 | $0.00 | 534-5010 (https://www.mouser.com/ProductDetail/Keystone-Electronics/5010?qs=sGAEpiMZZMsQtlBhqKq43axmqSC6FyKq) |  |  |  |  |  | 500 |  | $0.00 | $0.00 | 204-2646 (http://it.rs-online.com/web/c/?searchTerm=5010+Keystone+Electronics)
TPm2,TPf2 | White | D- Test Point | CDE_misc:TESTPOINT | Keystone Electronics | 5012 | 0 | $0.00 | $0.00 |  |  |  |  |  | 34562 |  | $0.00 | $0.00 | 2301414 (http://it.farnell.com/keystone/5012/test-point-pcb-through-hole/dp/2301414?st=5012%20) | 36162 |  | $0.00 | $0.00 | 534-5012 (https://www.mouser.com/ProductDetail/Keystone-Electronics/5012?qs=sGAEpiMZZMsQtlBhqKq43dlYSDt3tx6c) | 34562 |  | $0.00 | $0.00 | 67H8654 (http://www.newark.com/keystone/5012/test-point-pcb-through-hole/dp/67H8654?st=5012%20) | 800 |  | $0.00 | $0.00 | 409-1943 (http://it.rs-online.com/web/c/?searchTerm=5012+Keystone+Electronics)
TPm3,TPf3 | Green | D+ Test Point | CDE_misc:TESTPOINT | Keystone Electronics | 5126 | 0 | $0.00 | $0.00 |  |  |  |  |  |  |  |  |  |  | 3763 |  | $0.00 | $0.00 | 534-5126 (https://www.mouser.com/ProductDetail/Keystone-Electronics/5126?qs=sGAEpiMZZMuHIszJOUpTOguPsxZqART8) | 1055 |  | $0.00 | $0.00 | 95M2498 (http://www.newark.com/keystone/5126/test-point-pcb-green-through-hole/dp/95M2498?st=5126%20) |  |  |  |  |  | 3 |  | $0.00 | $0.00 | SC-CU2X1.50-TR010 (https://www.tme.eu/en/details/sc-cu2x1.50-tr010/speaker-cables/goobay/15126/)
TPm4,TPf4 | Black | GND Test Point | CDE_misc:TESTPOINT | Keystone Electronics | 5011 | 0 | $0.00 | $0.00 | 440967 |  | $0.00 | $0.00 | 36-5011-ND (http://www.digikey.com/product-detail/en/keystone-electronics/5011/36-5011-ND/255333) | 107 |  | $0.00 | $0.00 | 1463078 (http://it.farnell.com/keystone/5011/circuito-di-test-connettore-nero/dp/1463078?st=5011%20) | 73784 |  | $0.00 | $0.00 | 534-5011 (https://www.mouser.com/ProductDetail/Keystone-Electronics/5011?qs=sGAEpiMZZMsQtlBhqKq43UFjjVQHwuQ8) | 33739 |  | $0.00 | $0.00 | 88H2535 (http://www.newark.com/keystone/5011/test-point-pcb-through-hole/dp/88H2535?st=5011%20) | NonStk |  |  |  | 204-2652 (http://it.rs-online.com/web/c/?searchTerm=5011+Keystone+Electronics)
TPm5,TPf5 | Blue | SSRX- Test Point | CDE_misc:TESTPOINT | Keystone Electronics | 5127 | 0 | $0.00 | $0.00 |  |  |  |  |  | 93 |  | $0.00 | $0.00 | 2667588 (http://it.farnell.com/keystone/5127/test-point-pcb-blue-through-hole/dp/2667588?st=5127%20) | 3843 |  | $0.00 | $0.00 | 534-5127 (https://www.mouser.com/ProductDetail/Keystone-Electronics/5127?qs=sGAEpiMZZMuHIszJOUpTOqGIJQFBAjt8) | 93 |  | $0.00 | $0.00 | 95M2499 (http://www.newark.com/keystone/5127/test-point-pcb-blue-through-hole/dp/95M2499?st=5127%20)
TPm6,TPf6 | Yellow | SSRX+ Test Point | CDE_misc:TESTPOINT | Keystone Electronics | 5014 | 0 | $0.00 | $0.00 | 160018 |  | $0.00 | $0.00 | 36-5014-ND (http://www.digikey.com/scripts/DkSearch/dksus.dll?WT.z_header=search_go&lang=en) | 64 |  | $0.00 | $0.00 | 1533393 (http://it.farnell.com/keystone/5014/test-point-pcb-through-hole/dp/1533393?st=5014%20) | 13985 |  | $0.00 | $0.00 | 534-5014 (https://www.mouser.com/ProductDetail/Keystone-Electronics/5014?qs=sGAEpiMZZMsQtlBhqKq43X3oNF5t6CNB)
TPm8,TPf8 | Purple | SSTX- Test Point | CDE_misc:TESTPOINT | Keystone Electronics | 5129 | 0 | $0.00 | $0.00 |  |  |  |  |  | 1244 |  | $0.00 | $0.00 | 2667590 (http://it.farnell.com/keystone/5129/test-point-pcb-purple-through/dp/2667590?st=5129%20) | 1647 |  | $0.00 | $0.00 | 534-5129 (https://www.mouser.com/ProductDetail/Keystone-Electronics/5129?qs=sGAEpiMZZMuHIszJOUpTOkLO79y3hO0w) | 1244 |  | $0.00 | $0.00 | 95M2503 (http://www.newark.com/keystone/5129/test-point-pcb-purple-through/dp/95M2503?st=5129%20)
TPm9,TPf9 | Orange | SSTX+ Test Point | CDE_misc:TESTPOINT | Keystone Electronics | 5013 | 0 | $0.00 | $0.00 |  |  |  |  |  | 1846 |  | $0.00 | $0.00 | 2301289 (http://it.farnell.com/keystone/5013/test-point-pcb-through-hole/dp/2301289?st=5013%20) | 37493 |  | $0.00 | $0.00 | 534-5013 (https://www.mouser.com/ProductDetail/Keystone-Electronics/5013?qs=sGAEpiMZZMsQtlBhqKq43c5QvKE3dNqK) | 1846 |  | $0.00 | $0.00 | 62W5145 (http://www.newark.com/keystone/5013/test-point-pcb-through-hole/dp/62W5145?st=5013%20) | NonStk |  | $0.00 | $0.00 | 2508838550 (http://it.rs-online.com/web/c/?searchTerm=5013+Keystone+Electronics)
Distributors scraped by KiCost® v.0.1.43 |  |  |  |  |  |  |  |  |  | 0 |  |  |  |  | 0 |  |  |  |  | 0 |  |  |  |  | 0 |  |  |  |  | 0 |  |  |  |  | 0
 |  |  |  |  |  |  |  |  |  | 0 | 0 | 0 |  |  | 0 | 0 | 0 |  |  | 0 | 0 | 0 |  |  | 0 | 0 | 0 |  |  | 0 | 0 | 0 |  |  | 0 | 0 | 0
 |  |  |  |  |  |  |  |  |  | 0 | 0 | 0 |  |  | 0 | 0 | 0 |  |  | 0 | 0 | 0 |  |  | 0 | 0 | 0 |  |  | 0 | 0 | 0 |  |  | 0 | 0 | 0
 |  |  |  |  |  |  |  |  |  | 0 | 0 | 0 |  |  | 0 | 0 | 0 |  |  | 0 | 0 | 0 |  |  | 0 | 0 | 0 |  |  | 0 | 0 | 0 |  |  | 0 | 0 | 0
 |  |  |  |  |  |  |  |  |  | 0 | 0 | 0 |  |  | 0 | 0 | 0 |  |  | 0 | 0 | 0 |  |  | 0 | 0 | 0 |  |  | 0 | 0 | 0 |  |  | 0 | 0 | 0
 |  |  |  |  |  |  |  |  |  | 0 | 0 | 0 |  |  | 0 | 0 | 0 |  |  | 0 | 0 | 0 |  |  | 0 | 0 | 0 |  |  | 0 | 0 | 0 |  |  | 0 | 0 | 0
 |  |  |  |  |  |  |  |  |  | 0 | 0 | 0 |  |  | 0 | 0 | 0 |  |  | 0 | 0 | 0 |  |  | 0 | 0 | 0 |  |  | 0 | 0 | 0 |  |  | 0 | 0 | 0
 |  |  |  |  |  |  |  |  |  | 0 | 0 | 0 |  |  | 0 | 0 | 0 |  |  | 0 | 0 | 0 |  |  | 0 | 0 | 0 |  |  | 0 | 0 | 0 |  |  | 0 | 0 | 0
 |  |  |  |  |  |  |  |  |  | 0 | 0 | 0 |  |  | 0 | 0 | 0 |  |  | 0 | 0 | 0 |  |  | 0 | 0 | 0 |  |  | 0 | 0 | 0 |  |  | 0 | 0 | 0
 |  |  |  |  |  |  |  |  |  | 0 | 0 | 0 |  |  | 0 | 0 | 0 |  |  | 0 | 0 | 0 |  |  | 0 | 0 | 0 |  |  | 0 | 0 | 0 |  |  | 0 | 0 | 0
 |  |  |  |  |  |  |  |  |  | 0 | 0 | 0 |  |  | 0 | 0 | 0 |  |  | 0 | 0 | 0 |  |  | 0 | 0 | 0 |  |  | 0 | 0 | 0 |  |  | 0 | 0 | 0
 |  |  |  |  |  |  |  |  |  | 0 | 0 | 0 |  |  | 0 | 0 | 0 |  |  | 0 | 0 | 0 |  |  | 0 | 0 | 0 |  |  | 0 | 0 | 0 |  |  | 0 | 0 | 0
 |  |  |  |  |  |  |  |  |  | 0 | 0 | 0 |  |  | 0 | 0 | 0 |  |  | 0 | 0 | 0 |  |  | 0 | 0 | 0 |  |  | 0 | 0 | 0 |  |  | 0 | 0 | 0
