Sembazuru/USB-breakout/ClubJameco/Project.ods

Sheet: BOM
Line# | Component Name | Jameco Part Number | Manufacturer Number | Quantity | Web page | Note
1 | USB Type A Receptacle (female) | 921651 | 292303-1 | 1 | http://www.jameco.com/webapp/wcs/stores/servlet/Product_10001_10001_921651_-1 | J1
2 | USB Type A Plug (male) |  | 48037-0001 | 1 | http://octopart.com/48037-0001-molex-314308 | J2
3 | DPST Slide Switch | 777733 | S201031MS02Q | 4 | http://www.jameco.com/webapp/wcs/stores/servlet/Product_10001_10001_777733_-1 | SW1, SW2, SW3, SW4
4 | Test Point, white | 1582065 | 5012 | 2 | http://www.jameco.com/webapp/wcs/stores/servlet/Product_10001_10001_1582065_-1 | TPf2, TPm2
5 | Test Point, red |  | 5010 | 2 | http://octopart.com/5010-keystone-11743 | TPf1, TPm1
6 | Test Point, black |  | 5011 | 2 | http://octopart.com/5011-keystone-8542 | TPf4, TPm4
7 | Test Point, green |  | 5126 | 2 | http://octopart.com/5126-keystone-10591134 | TPf3, TPm3
8 | Rubber Bumper | 1579288 | SJ-5012-BLACK | 4 | https://www.jameco.com/webapp/wcs/stores/servlet/Product_10001_10001_1579288_-1 | Feet

Sheet: Steps
Step# | Step Name | Image Name | Step Summary | Step Instructions
1 | Work area setup | Step1 | Set up a safe work area. | Clear a heat-resistant work area and get your tools laid out for easy access. If you don't have a dedicated workbench, covering the table with cardboard is sufficient to protect the table top from scorch marks.
2 | Parts organization | Step2 | Take stock of what you have. | Lay out all the parts that came with your kit. Verify that they match the BOM.
3 | Ready to work | Step3 | Bring the parts together with the work area. | Using shallow containers for the parts helps keeps them organized and harder to loose. A rubber-jawed vice (like the PanaVice in the picture) allows holding the board still and at a comfortable height/angle for soldering. If you need a primer on soldering, check out this excellent video that I found on the web recently: http://store.curiousinventor.com/guides/How_to_Solder
4 | Solder the switches. | Step4 Collage | When soldering components to any bare board, it's usually best to start with the shortest components. This way the taller ones don't get in the way. This board is different. The only components that don't clip into the board are the biggest components: the switches. | Solder the switches. If you are really anal like I am, you will want to make sure they are all aligned with the silkscreen outline. The order doesn't really matter. See the image for one suggestion out of many for soldering the switches.
5 | Insert J1 | Step5 Collage | Insert the USB receptacle. | Carefully insert the receptacle to J1. One technique to help avoid bending the pins is to first insert the tips of the thin pins into the four holes while holding the receptacle at a slight angle to the board. Then press it down so the shield pins clip into the board and lock the receptacle down.
6 | Insert J2 | Step6 Collage | Insert the USB plug. | Carefully insert the plug to J2, taking the same care not to bend the thin pins.
7 | (Optional) Insert test points | Step7 Collage | Optionally insert the test points. | Test points make it easy to connect alligator or other test clips. Align the test points with the colors indidcated on the PCB. These colors match the standard wire colors of USB cables. For each test-point location there are two holes. Choose either hole for the test point leaving the other hole for any future use you may have.
8 | Solder everything else | Step8 Collage | All the other parts will clip into the board. The test-points are optional. | Flip the board over and fasten in your vise if you have one. Solder all 6 pins of the connectors and all 8 test-points.
9 | Inspection and clean-up | Step9 | This is a very basic circuit, without much that can go wrong. But mistakes can happen. | Check to make sure all solder points look good and there aren't any solder bridges. Check continuity with switches closed. Clean flux residue.
10 | Finishing touches. | Step10 Collage | To protect your work surface from scratches, and reduce the chance of shorts, we use rubber feet to hold the board up. | Attach feet and enjoy! Note how the feed provide clearance so the solder joints don't touch the table top.
