Sembazuru/USB-breakout/ClubJameco/Pictures/Image01 - Parts.JPG

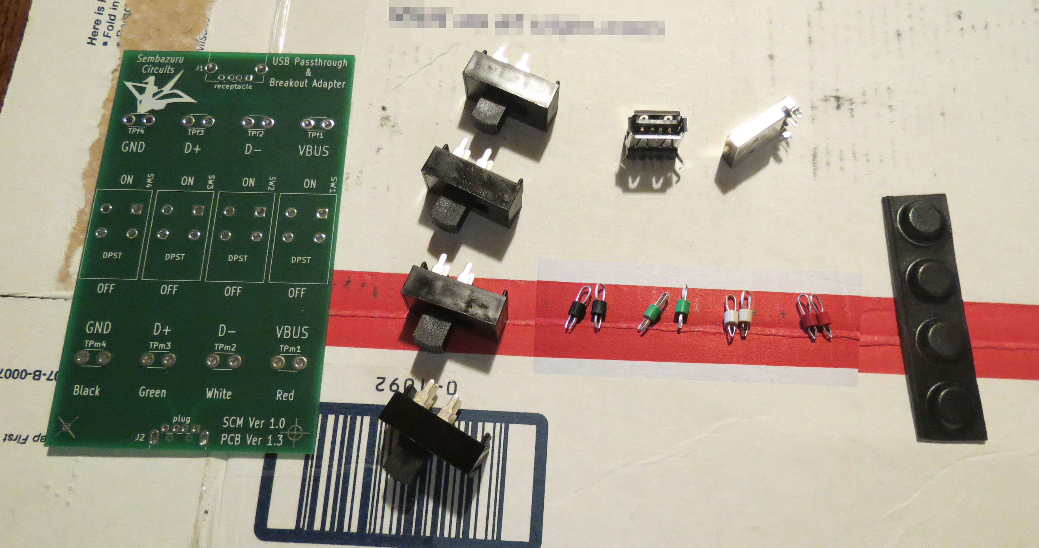
ClubJameco/Pictures/Image01 - Parts.JPG
