Sembazuru/USB-breakout/ClubJameco/Pictures/Image00 - Work Area setup.JPG

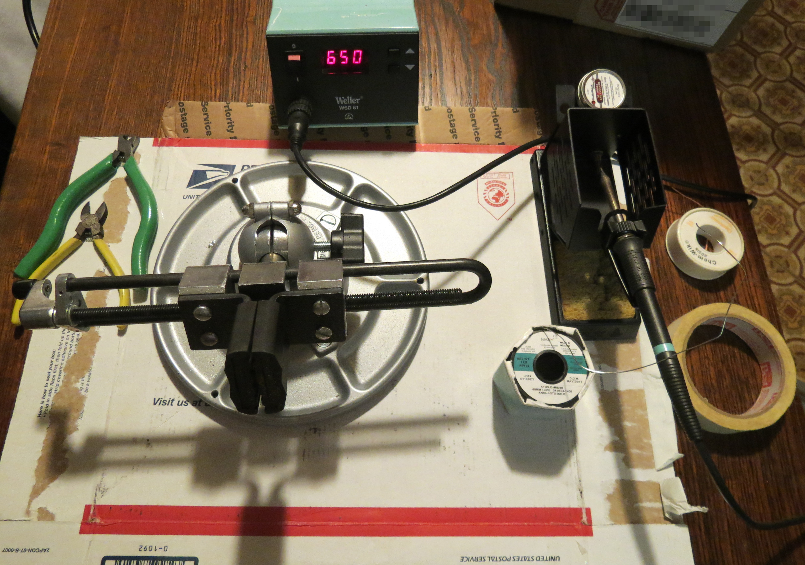
ClubJameco/Pictures/Image00 - Work Area setup.JPG
