Sembazuru/USB-breakout/ClubJameco/Pictures/Image06 - Switches ready for solder.JPG

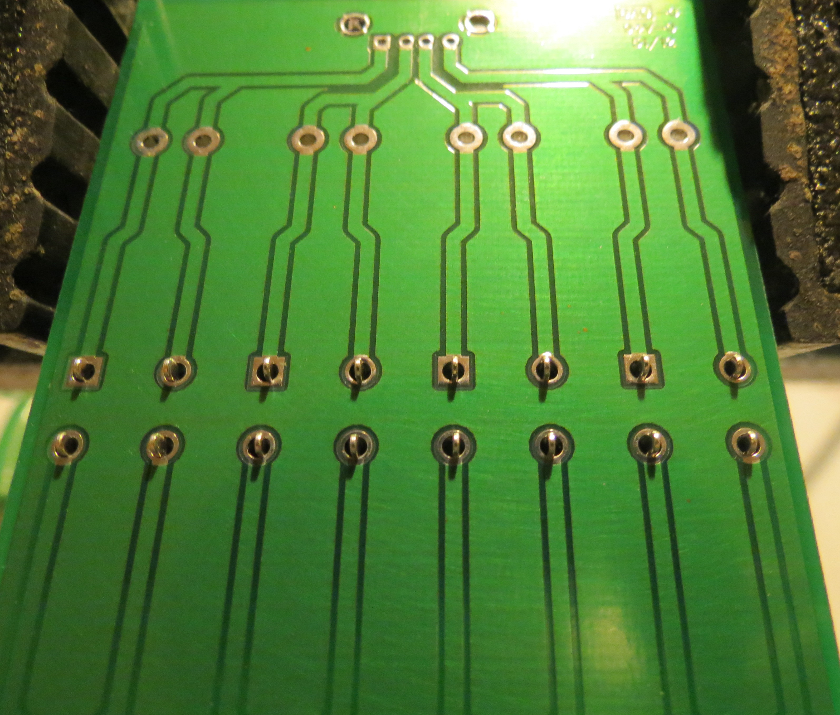
ClubJameco/Pictures/Image06 - Switches ready for solder.JPG
