Sembazuru/USB-breakout/ClubJameco/Pictures/Image07 - Switches first pin soldered.JPG

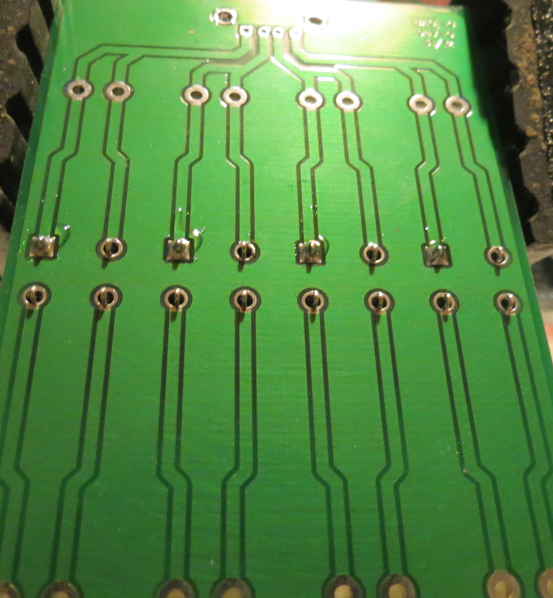
ClubJameco/Pictures/Image07 - Switches first pin soldered.JPG
