Sembazuru/USB-breakout/ClubJameco/Pictures/Image09 - Switches all pins soldered.JPG

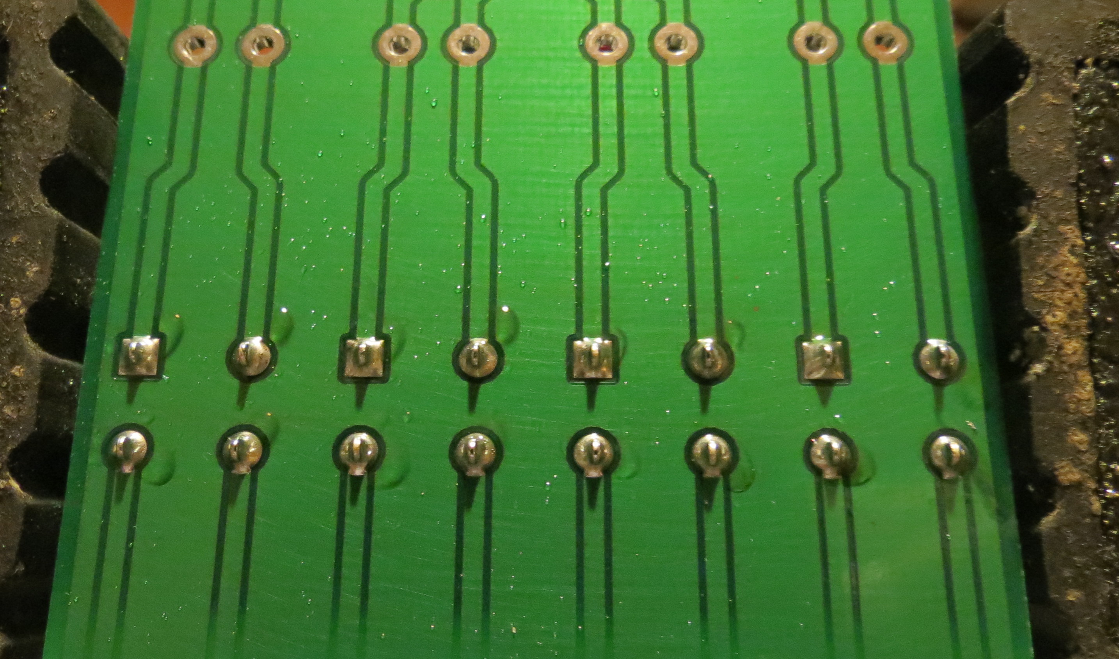
ClubJameco/Pictures/Image09 - Switches all pins soldered.JPG
