Sembazuru/USB-breakout/ClubJameco/Pictures/Image10 - Switches all pins soldered side view.JPG

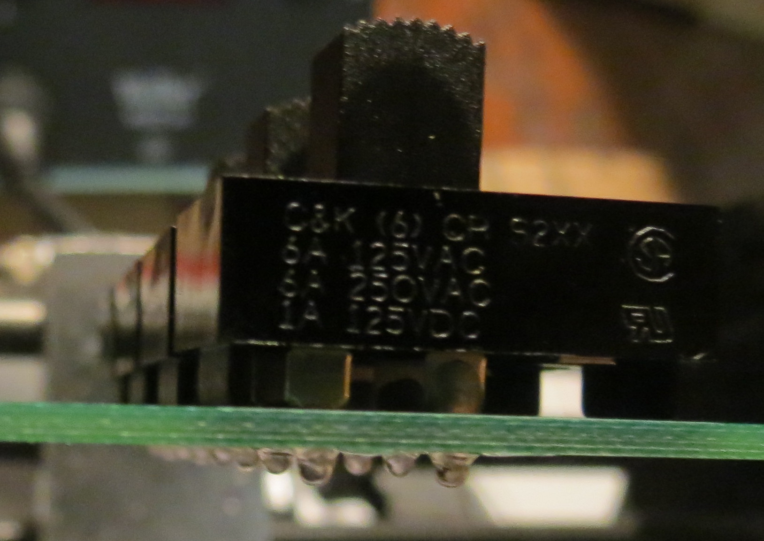
ClubJameco/Pictures/Image10 - Switches all pins soldered side view.JPG
