Sembazuru/USB-breakout/ClubJameco/Pictures/Image18 - Receptacle soldered.JPG

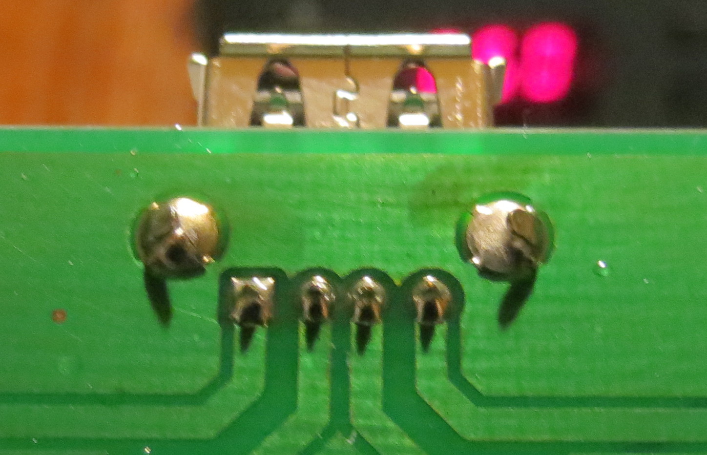
ClubJameco/Pictures/Image18 - Receptacle soldered.JPG
