Sembazuru/USB-breakout/ClubJameco/Pictures/Image19 - Plug soldered.JPG

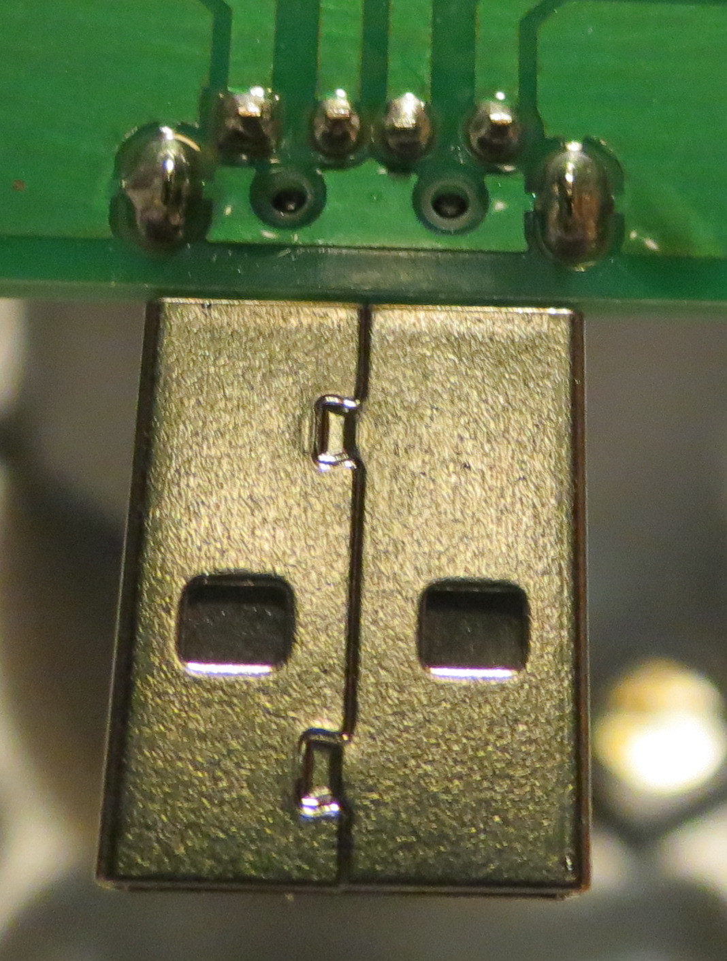
ClubJameco/Pictures/Image19 - Plug soldered.JPG
