Sembazuru/USB-breakout/ClubJameco/Pictures/Image20 - Test Points soldered.JPG

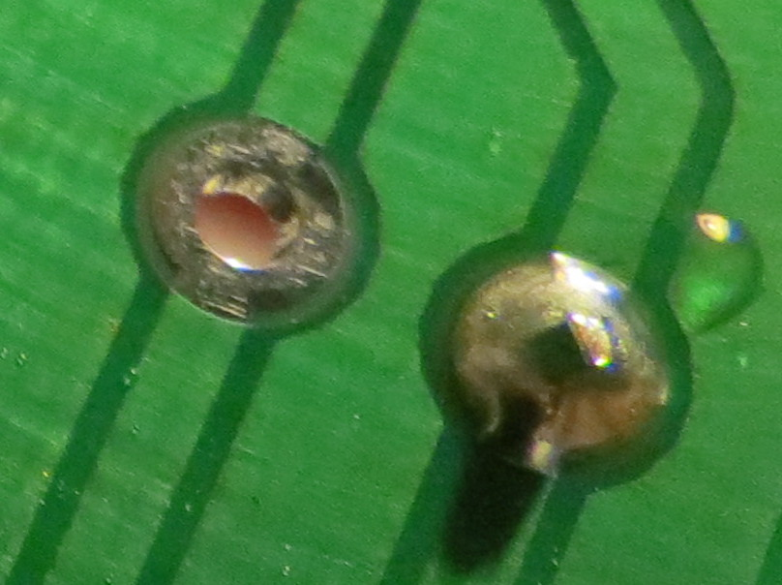
ClubJameco/Pictures/Image20 - Test Points soldered.JPG
