Sembazuru/USB-breakout/ClubJameco/Pictures/Image21 - Assembled pre-clean top.JPG

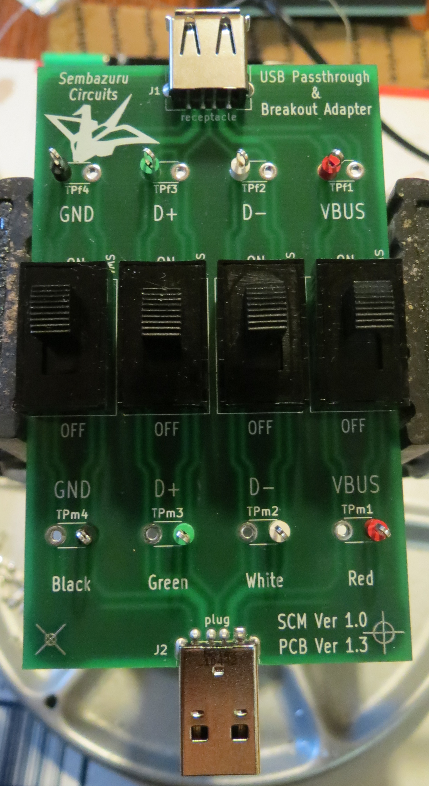
ClubJameco/Pictures/Image21 - Assembled pre-clean top.JPG
