Sembazuru/USB-breakout/ClubJameco/Pictures/Image22 - Assembled pre-clean bottom.JPG

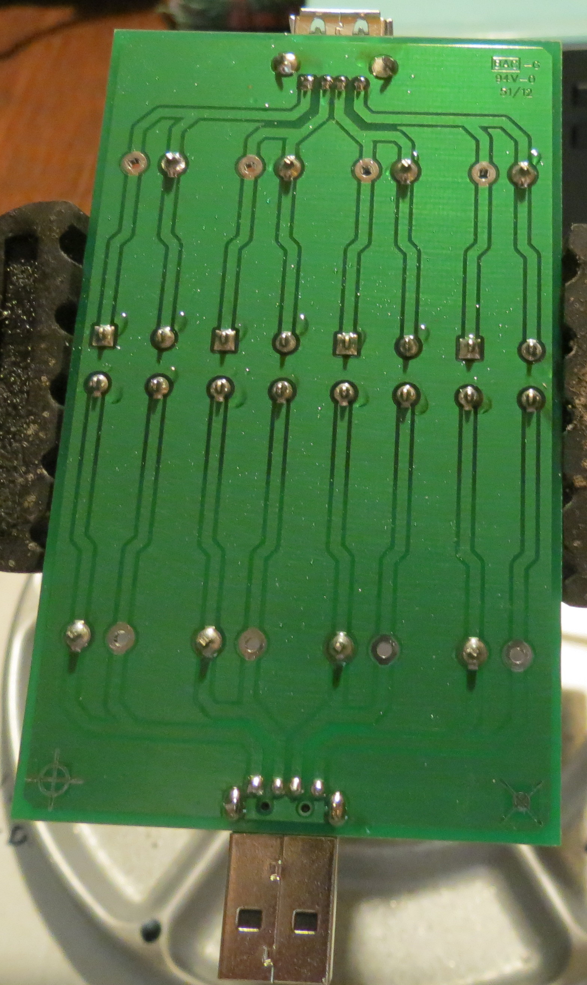
ClubJameco/Pictures/Image22 - Assembled pre-clean bottom.JPG
