Sembazuru/USB-breakout/ClubJameco/Pictures/Image23 - Assembled cleaned bottom.JPG

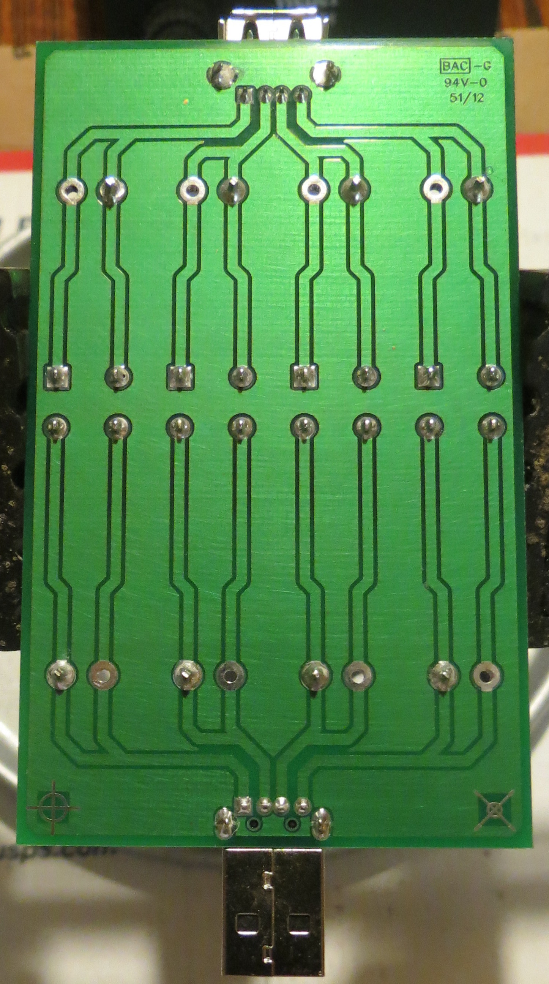
ClubJameco/Pictures/Image23 - Assembled cleaned bottom.JPG
