Sembazuru/USB-breakout/ClubJameco/Pictures/Image25 - Solder joint clearance side.JPG

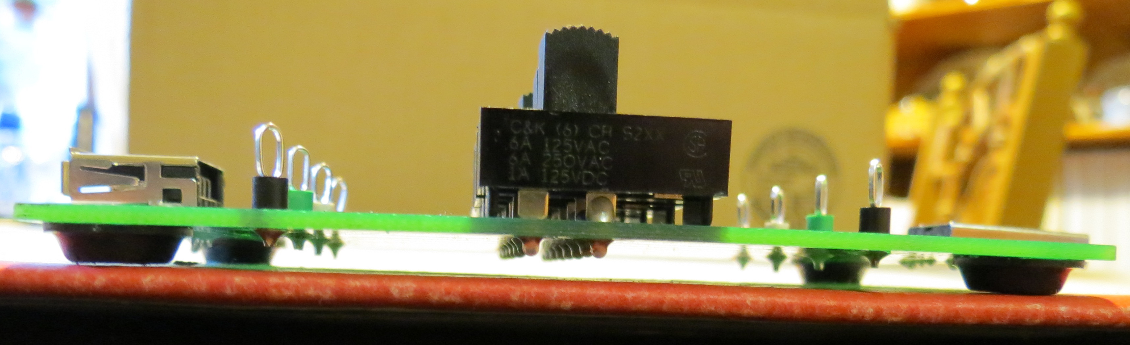
ClubJameco/Pictures/Image25 - Solder joint clearance side.JPG
