Sembazuru/USB-breakout/ClubJameco/Pictures/Image26 - Solder joint clearance receptacle end.JPG

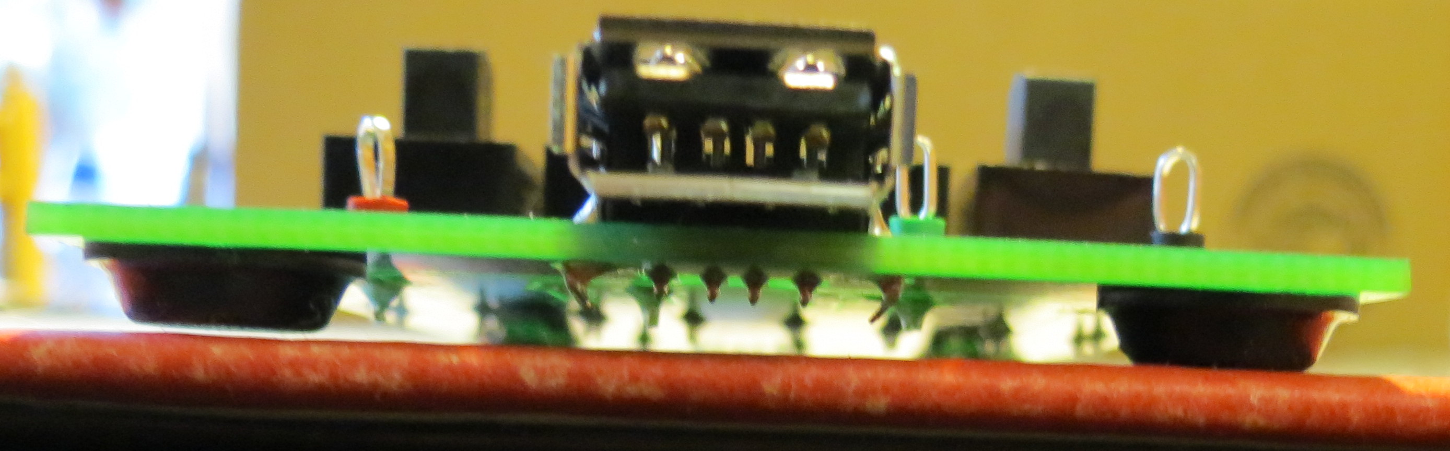
ClubJameco/Pictures/Image26 - Solder joint clearance receptacle end.JPG
