Sembazuru/USB-breakout/ClubJameco/Pictures/Image27 - Solder joint clearance plug end.JPG

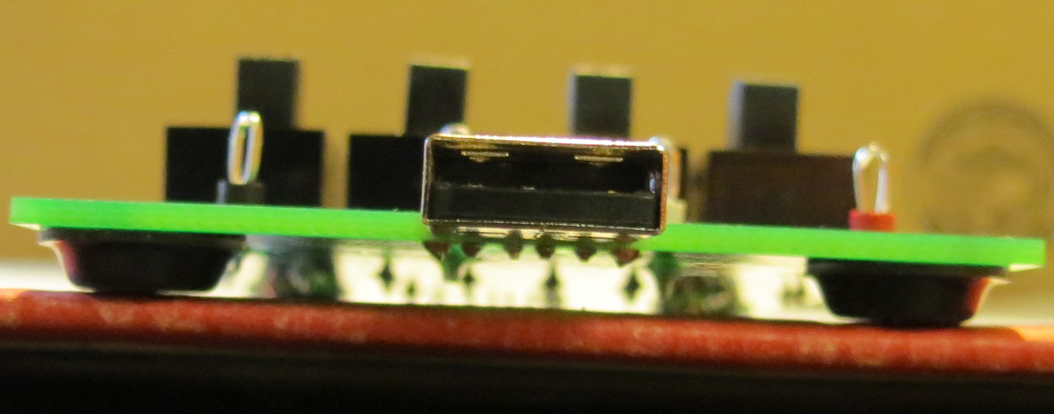
ClubJameco/Pictures/Image27 - Solder joint clearance plug end.JPG
