Sembazuru/USB-breakout/ClubJameco/Pictures/Step3.jpg

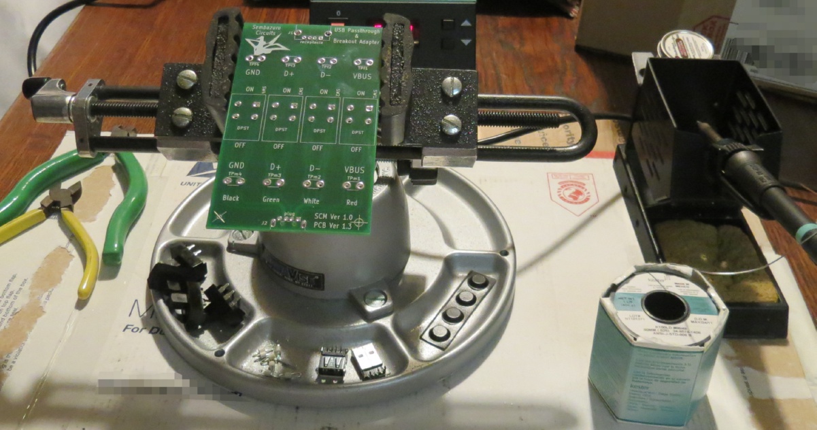
ClubJameco/Pictures/Step3.jpg
