Sembazuru/USB-breakout/ClubJameco/Pictures/Step4 Collage.jpg

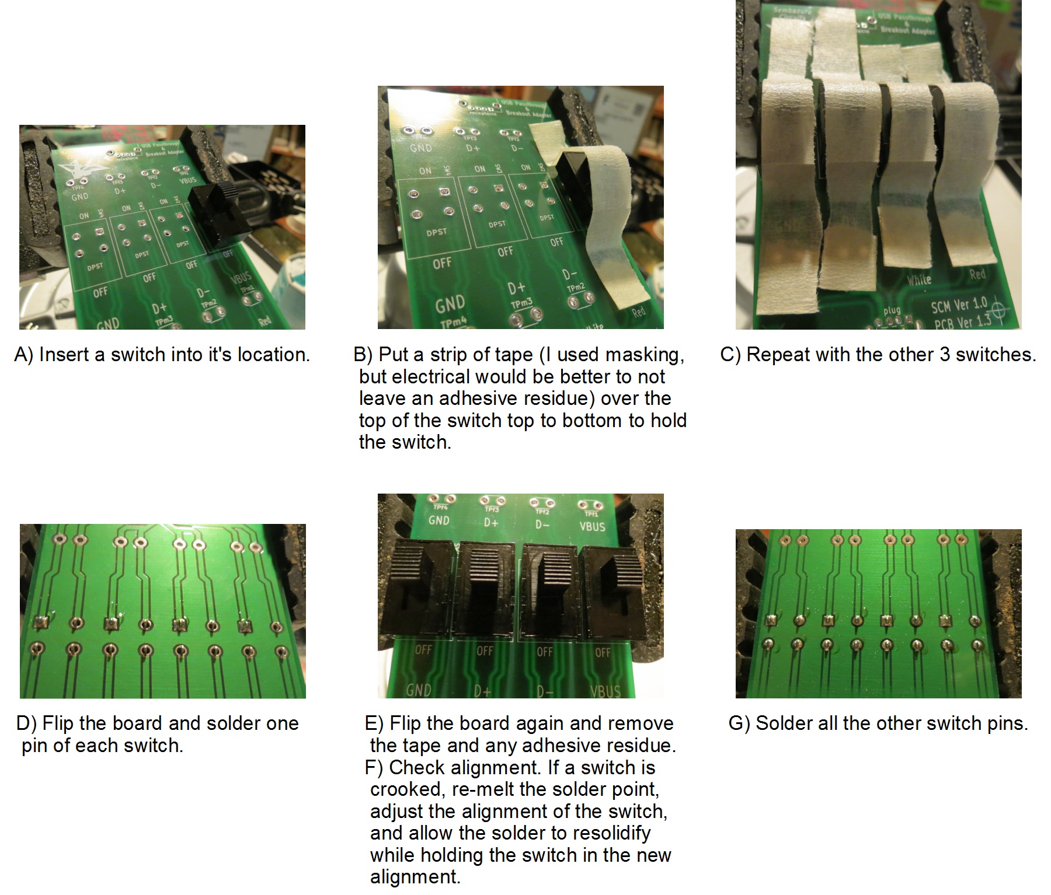
ClubJameco/Pictures/Step4 Collage.jpg
