Sembazuru/USB-breakout/ClubJameco/Pictures/Step5 Collage.jpg

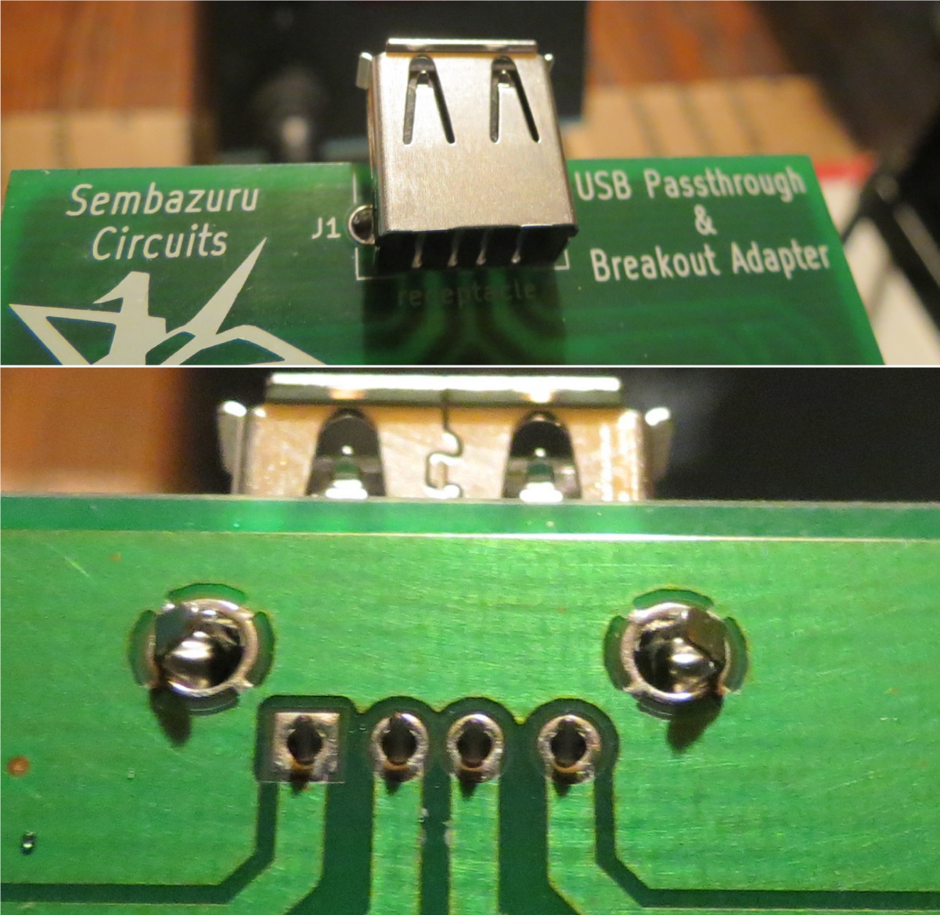
ClubJameco/Pictures/Step5 Collage.jpg
