Sembazuru/USB-breakout/ClubJameco/Pictures/Step6 Collage.jpg

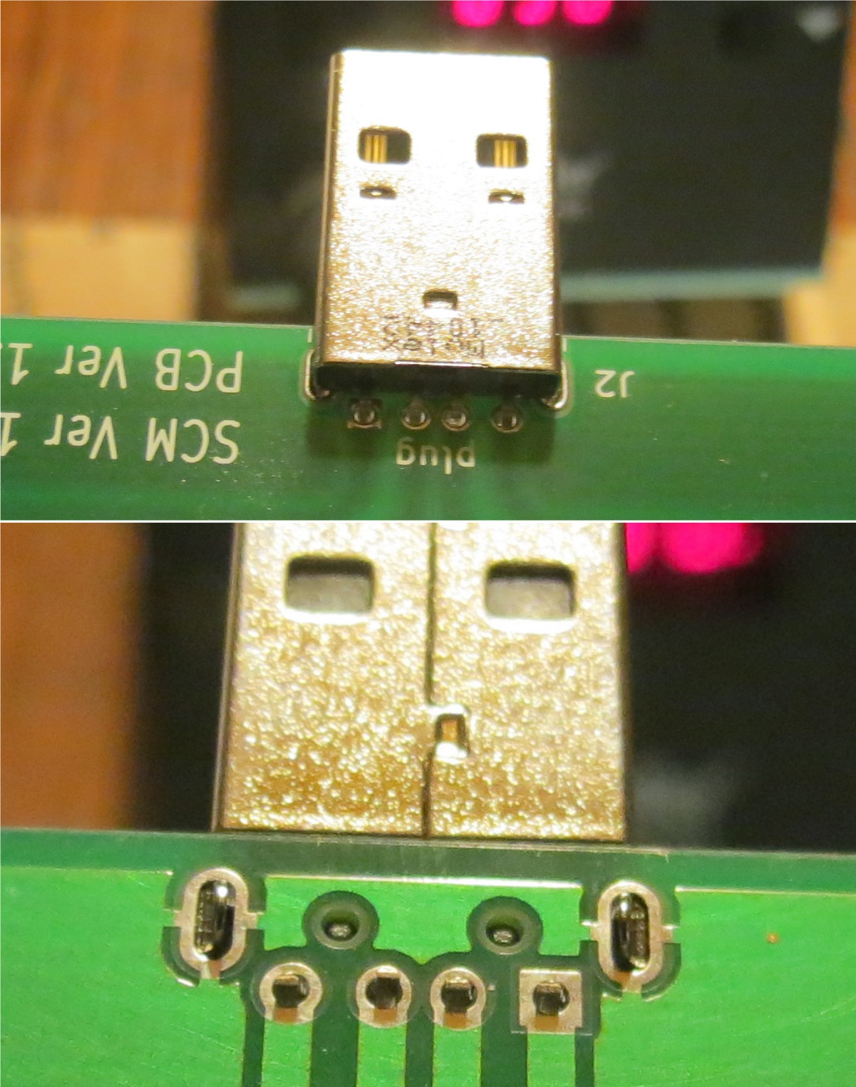
ClubJameco/Pictures/Step6 Collage.jpg
