Sembazuru/USB-breakout/ClubJameco/Pictures/Step7 Collage.jpg

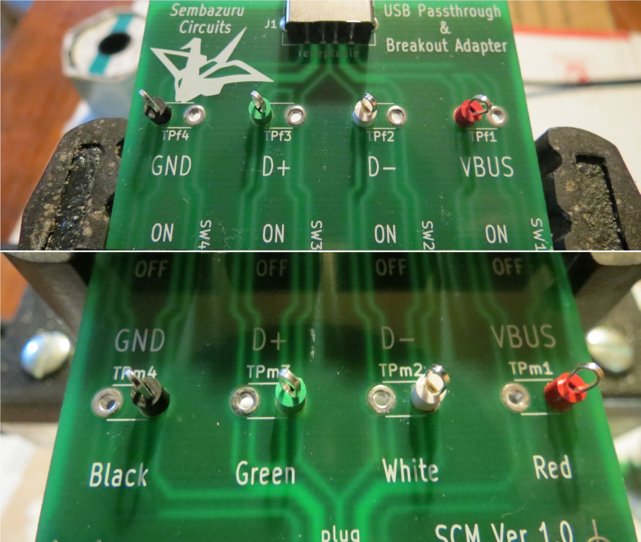
ClubJameco/Pictures/Step7 Collage.jpg
