Sembazuru/USB-breakout/ClubJameco/Pictures/Step10 Collage.jpg

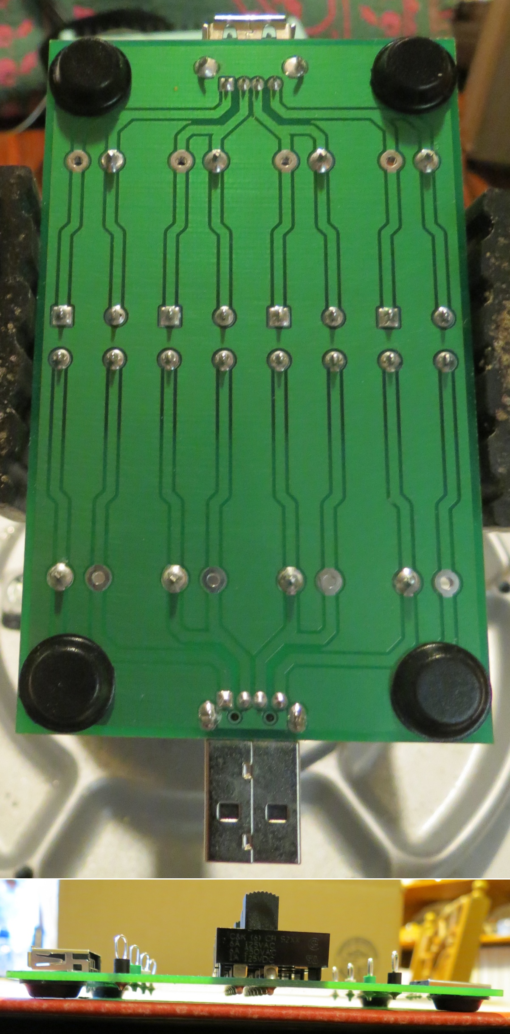
ClubJameco/Pictures/Step10 Collage.jpg
