Sembazuru/USB-breakout/ClubJameco/Pictures/Image16 - Plug-side Test Points placed top.JPG

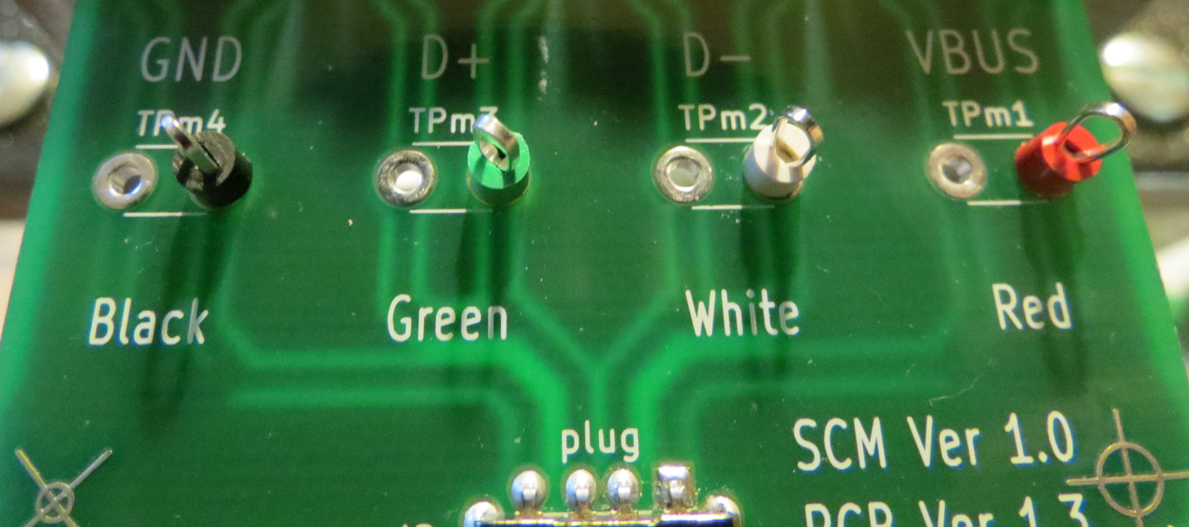
ClubJameco/Pictures/Image16 - Plug-side Test Points placed top.JPG
