Sembazuru/USB-breakout/ClubJameco/Pictures/Image17 - Test Points placed bottom.JPG

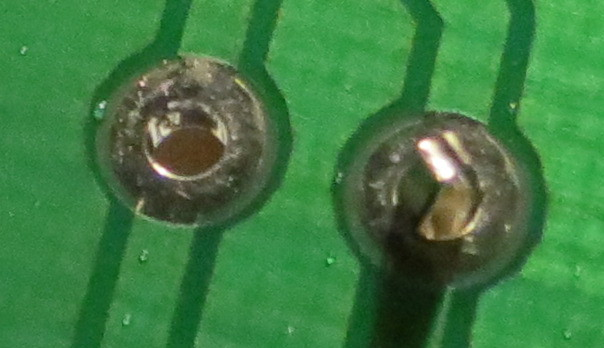
ClubJameco/Pictures/Image17 - Test Points placed bottom.JPG
