Sembazuru/USB-breakout/Printing Print Schematic.pdf

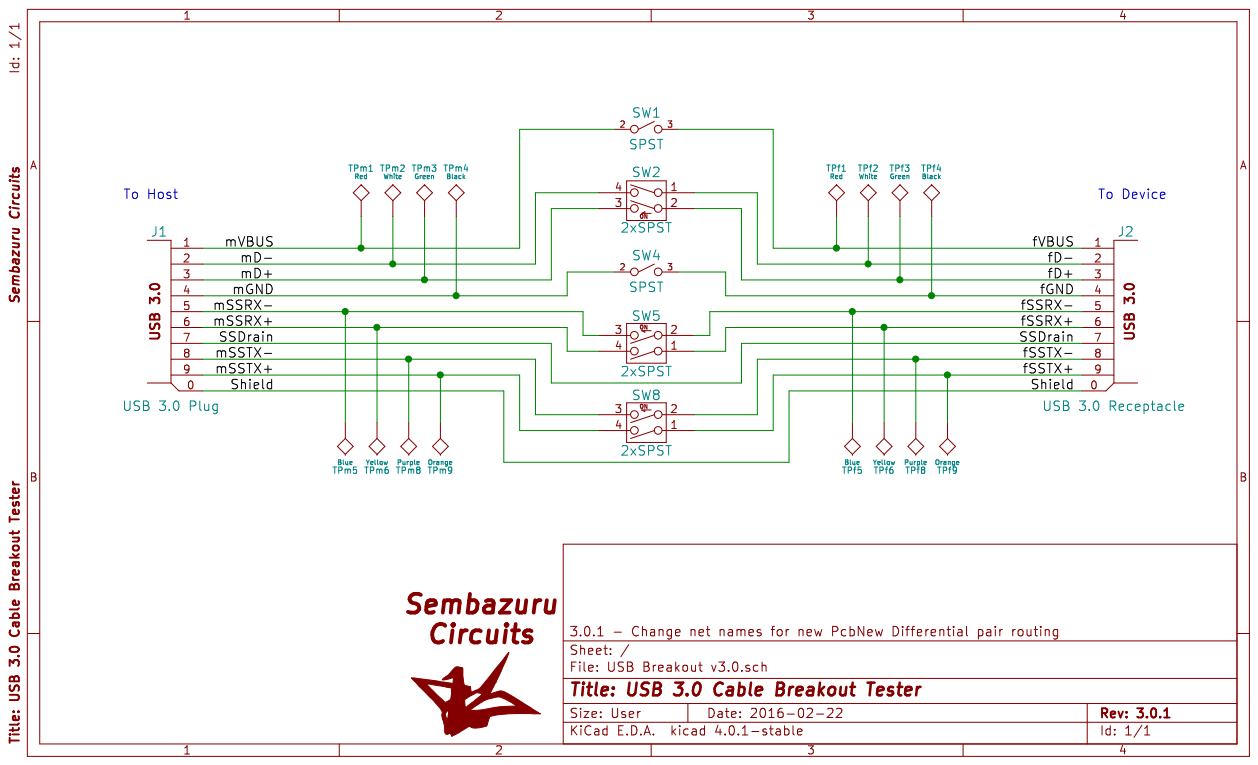
[picture p76: page 1]
