Sembazuru/USB-breakout/Printing Print.pdf

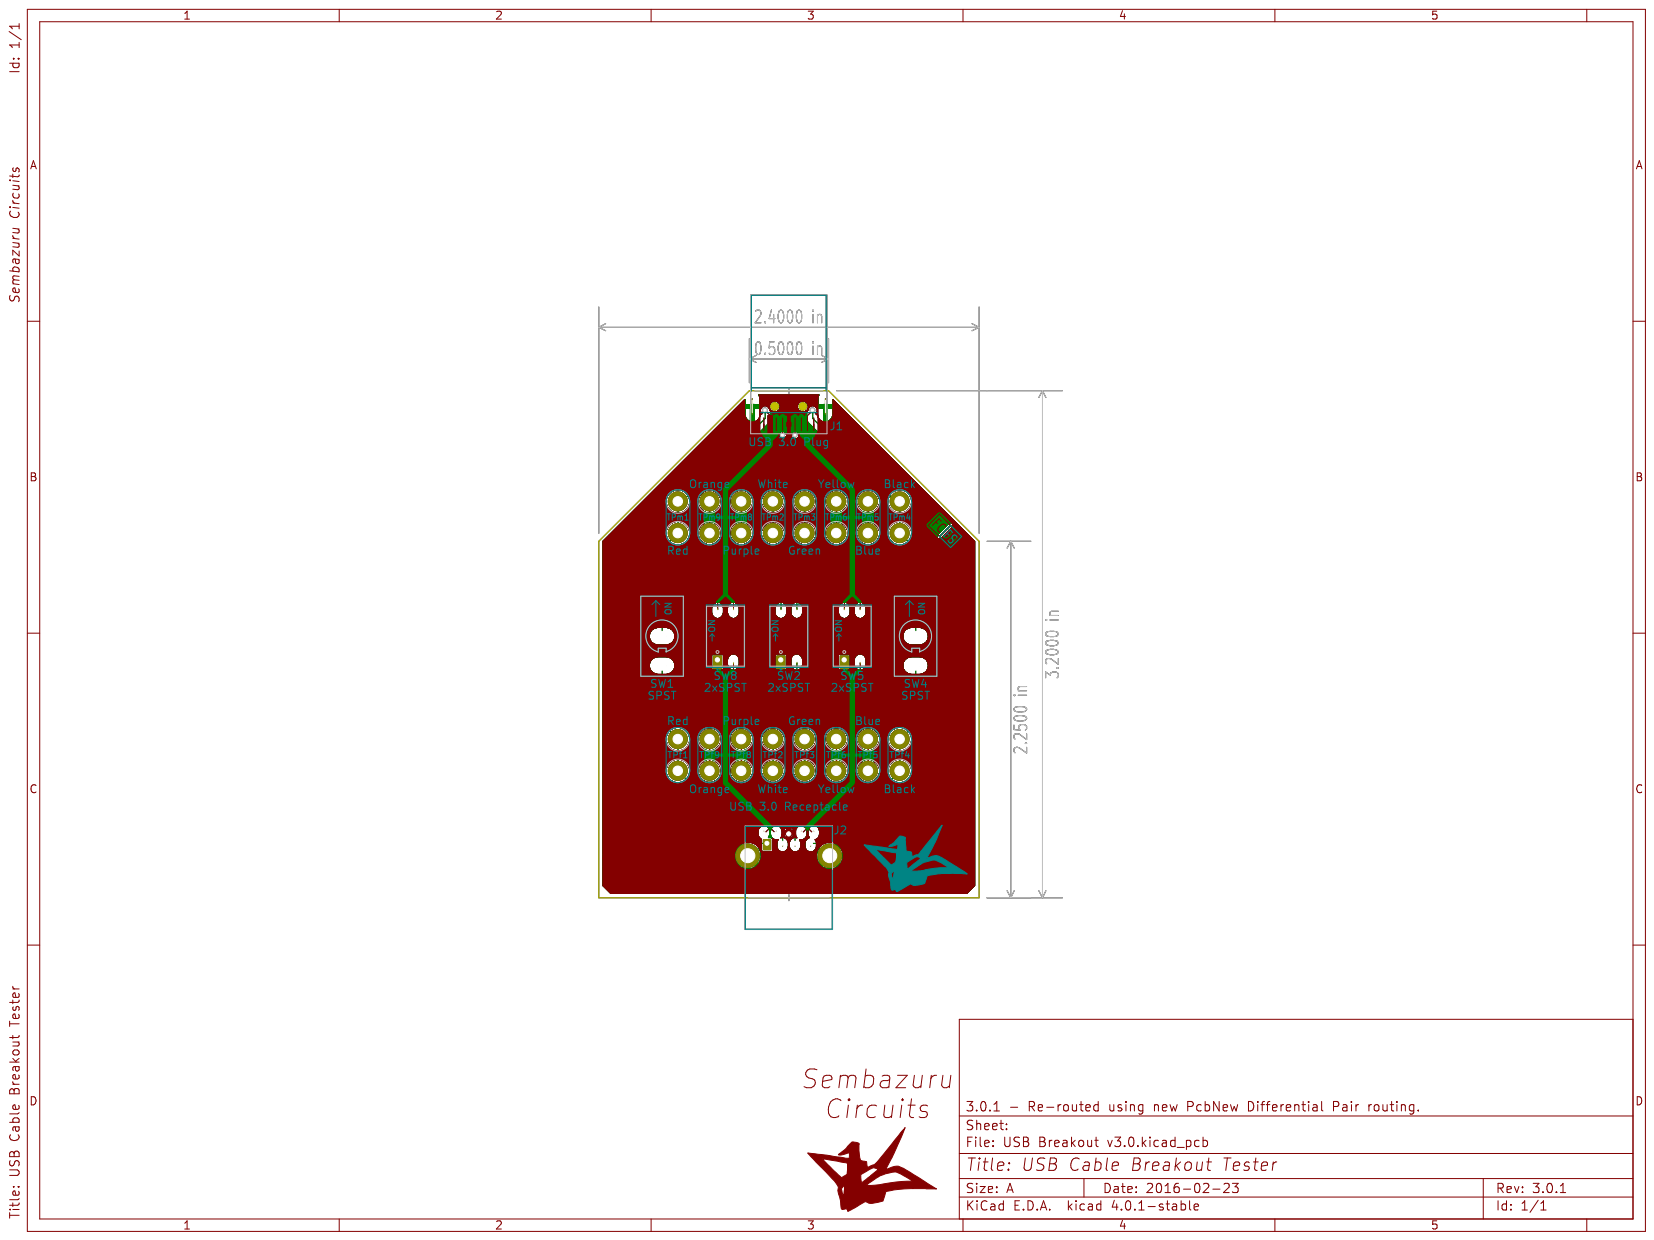
[picture p77: page 1]
