Sembazuru/USB-breakout/USB  breakout schematic v1.0.pdf

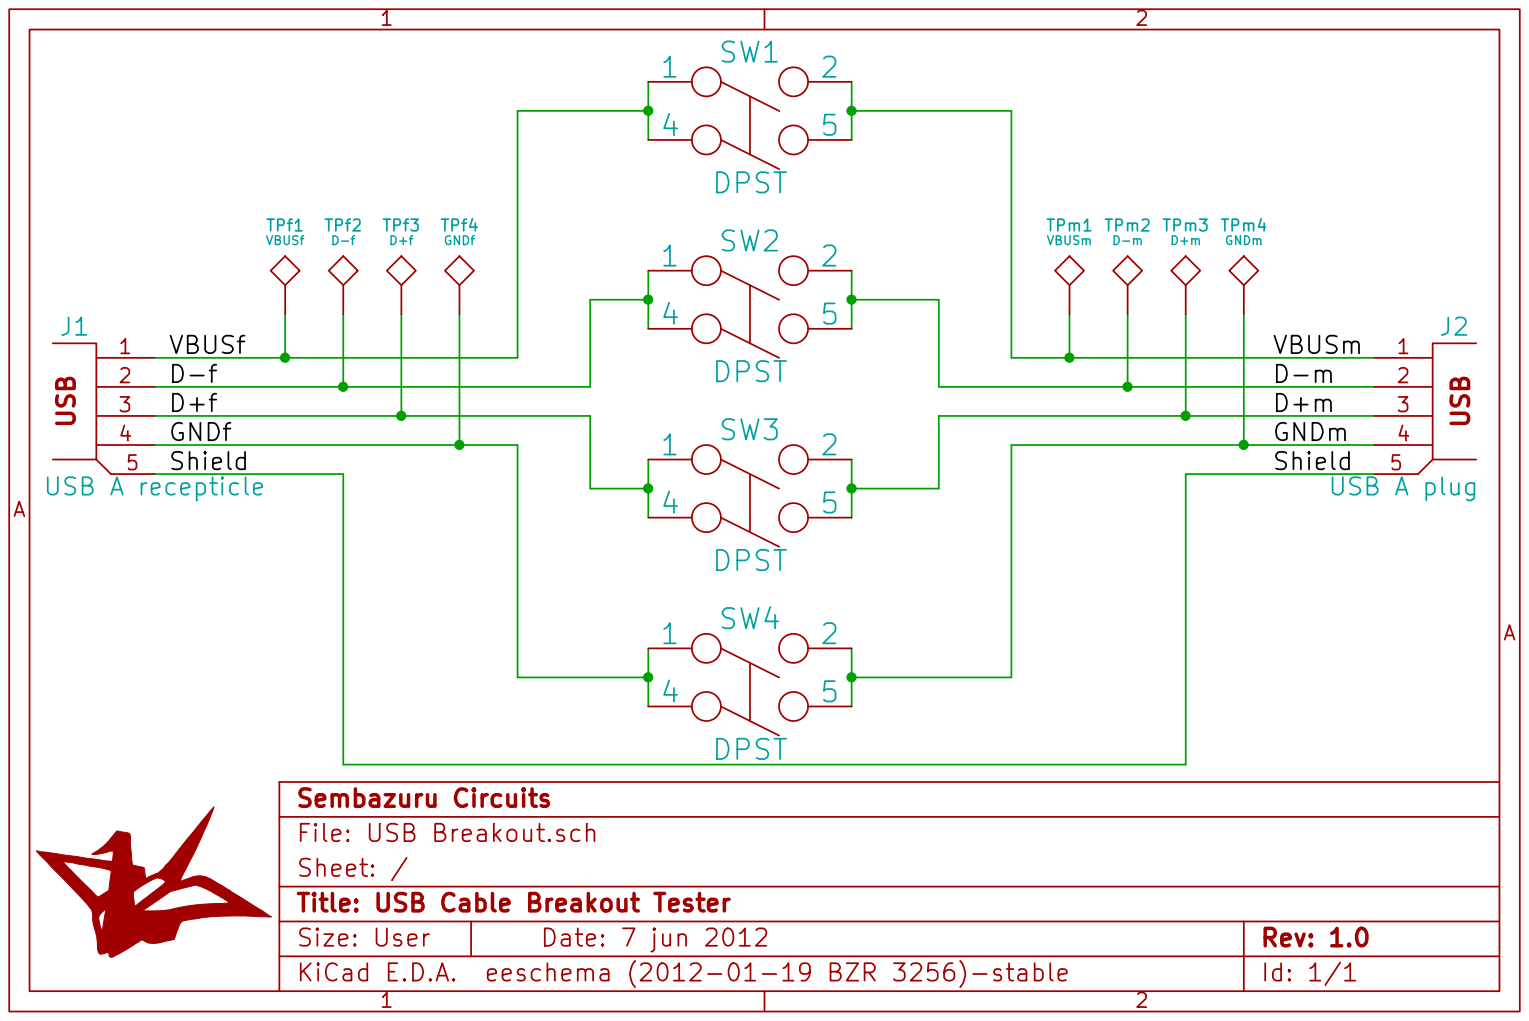
[picture p78: page 1]
