Sembazuru/USB-breakout/USB  breakout board v2.0.pdf

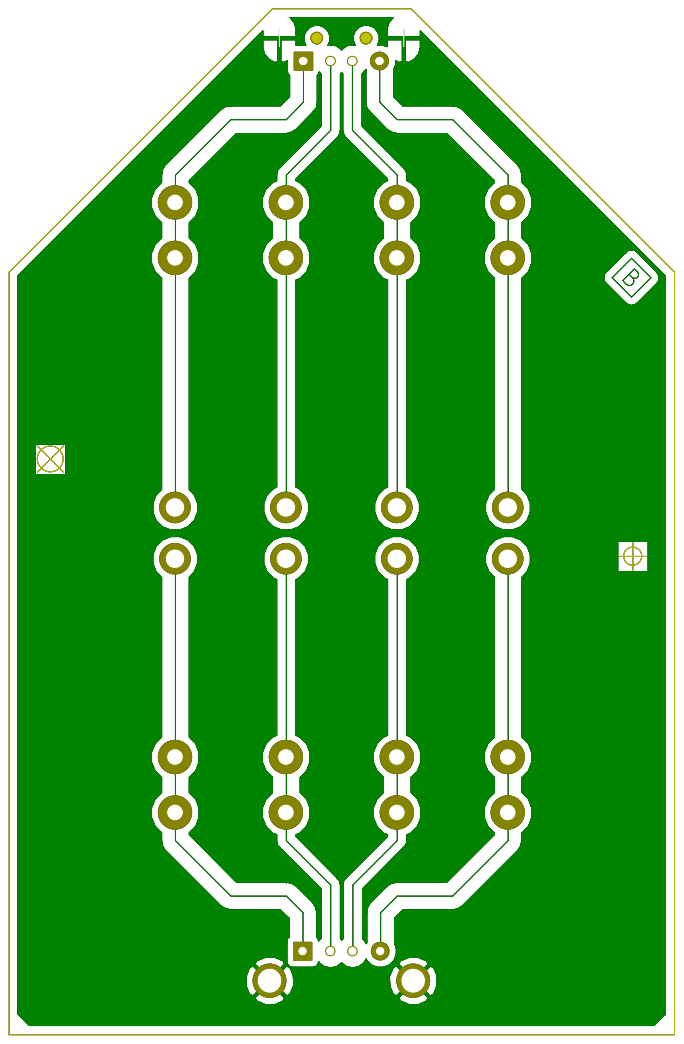
[picture p79: page 1]

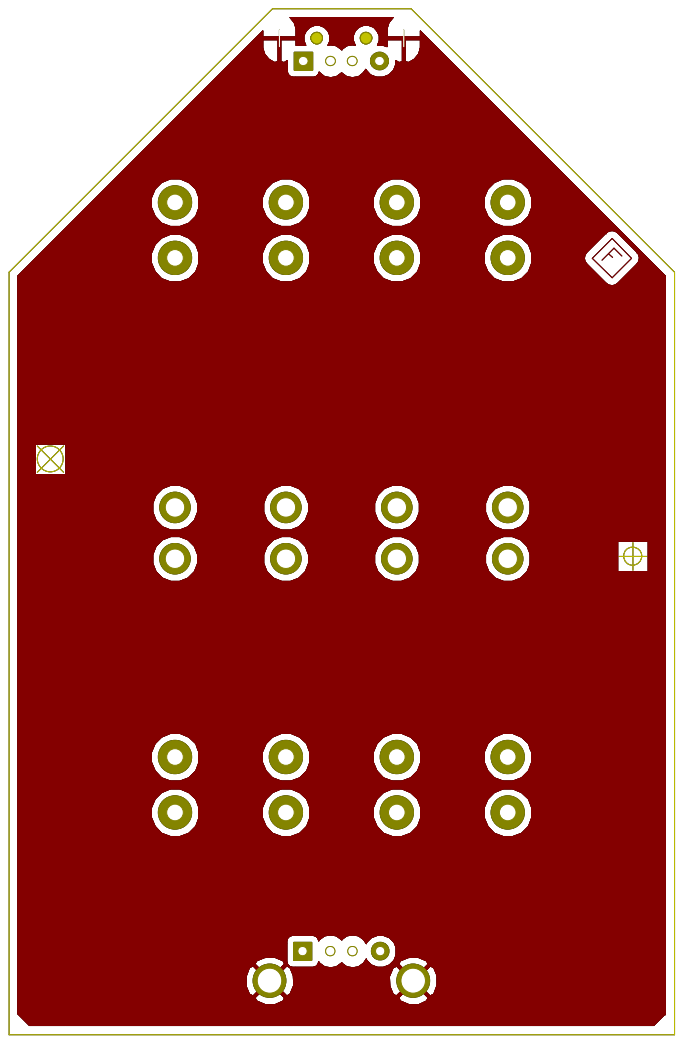
[picture p80: page 2]

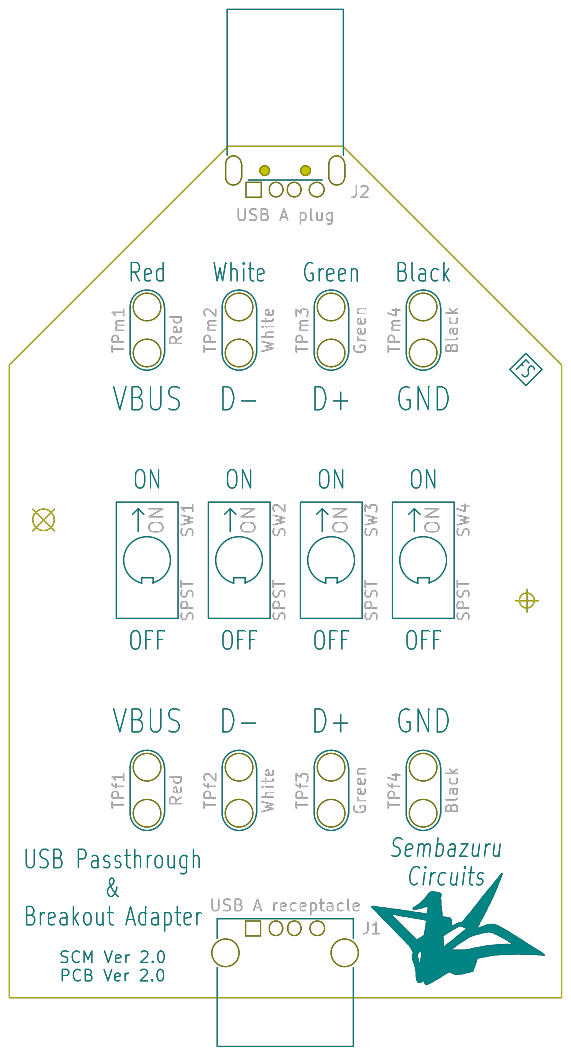
[picture p81: page 3]

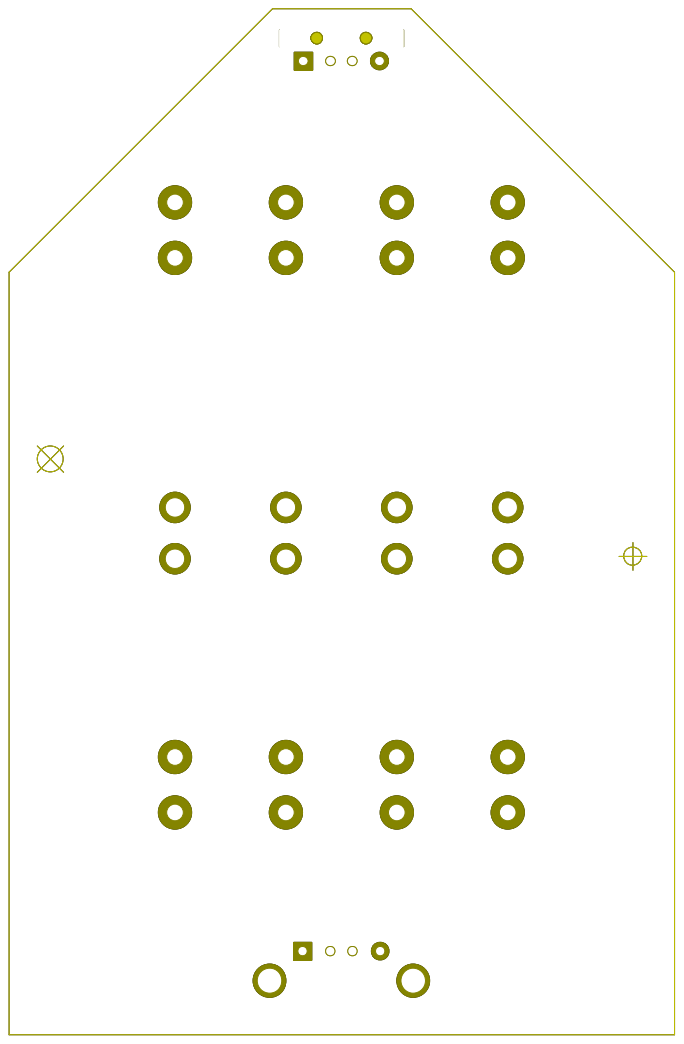
[picture p82: page 4]

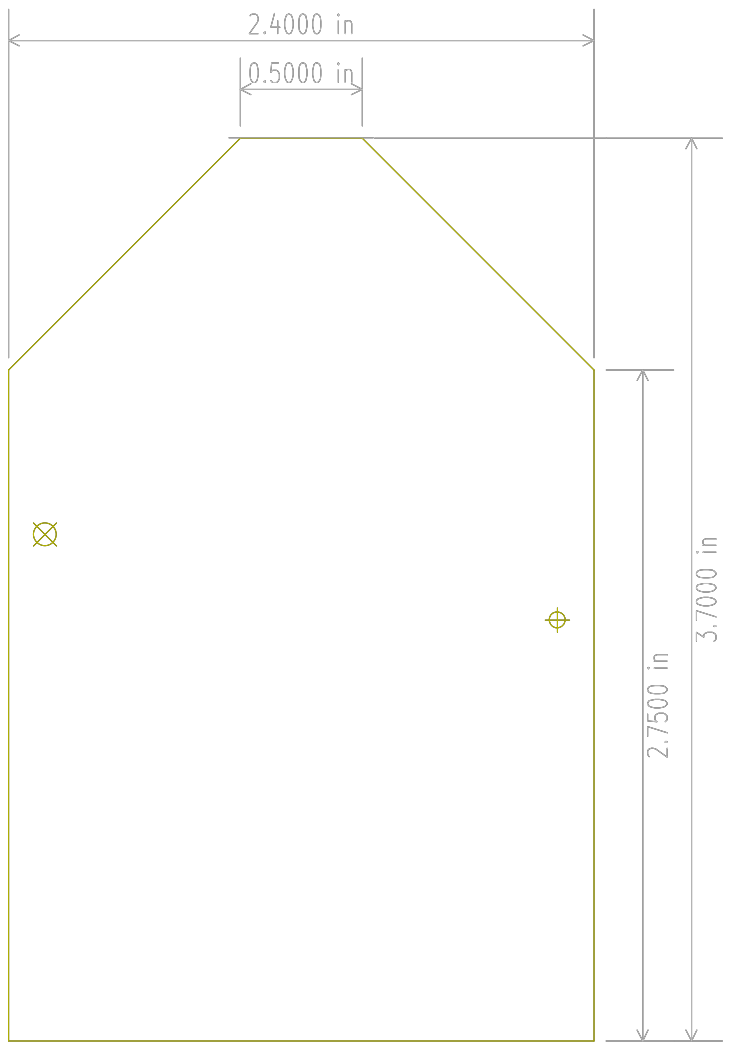
[picture p83: page 6]

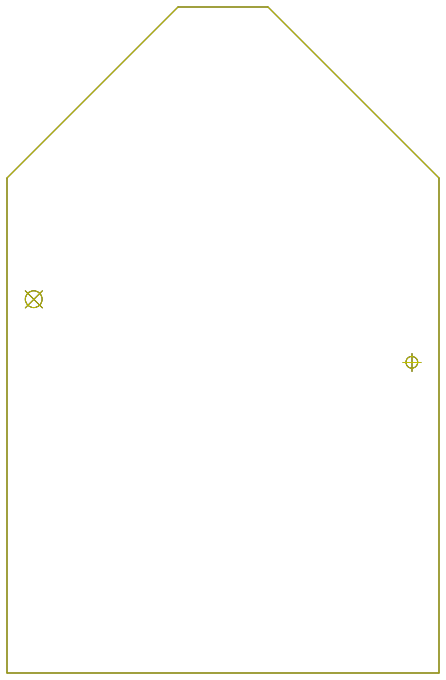
[picture p84: figure]
