Sembazuru/USB-breakout/USB Breakout v3.0.sch.pdf

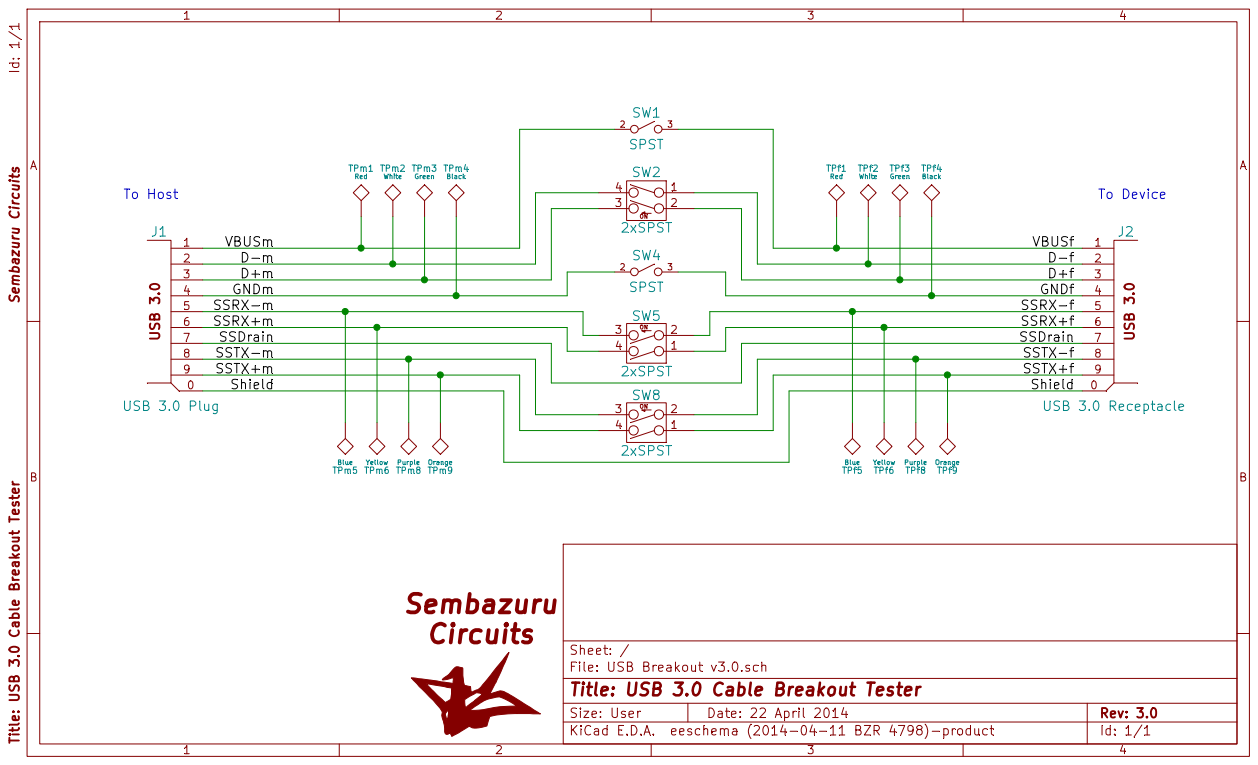
[picture p93: page 1]
