Sembazuru/USB-breakout/USB  breakout board v1.1.pdf

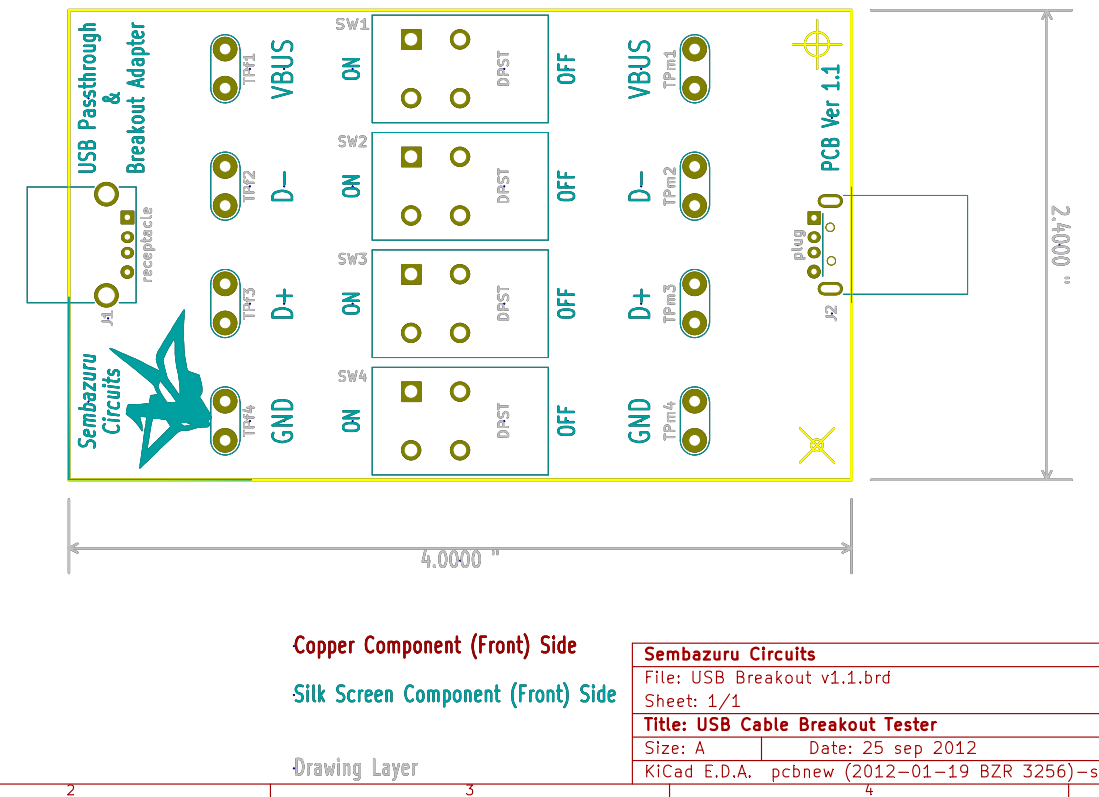
[picture p94: page 1]

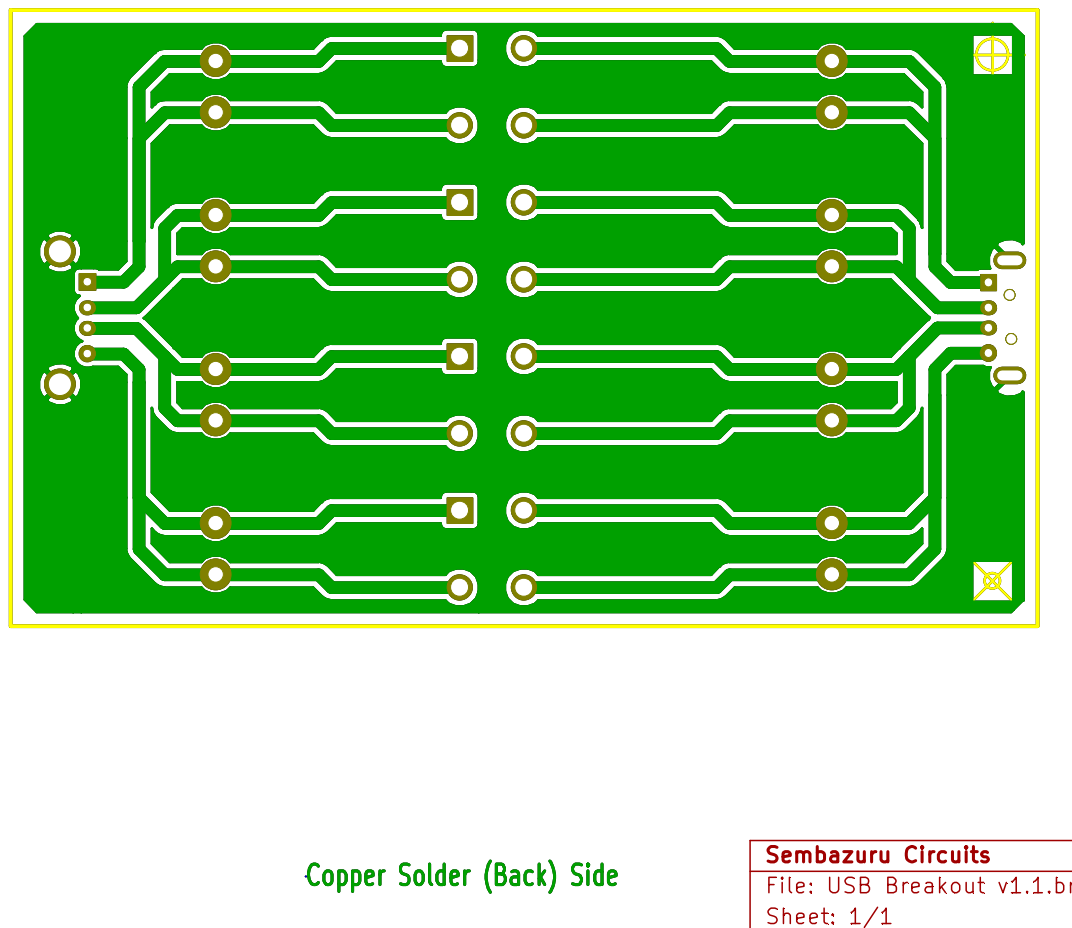
[picture p95: page 2]

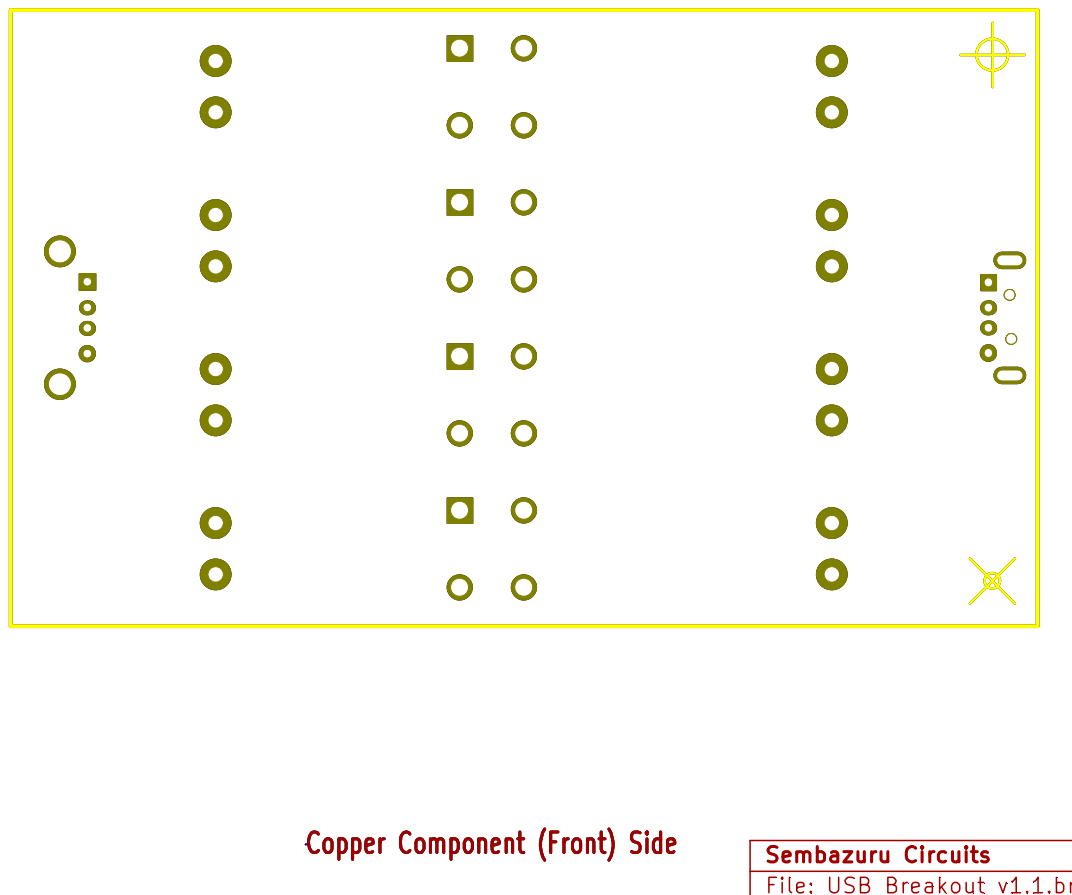
[picture p96: page 3]

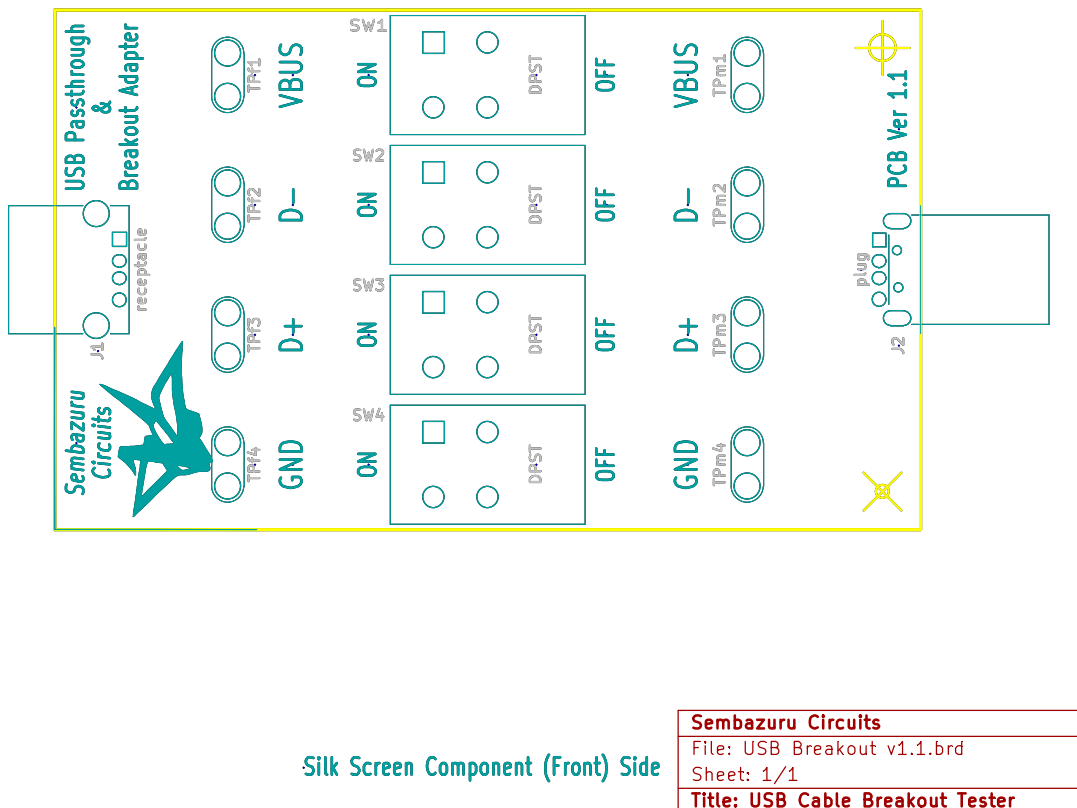
[picture p97: page 4]

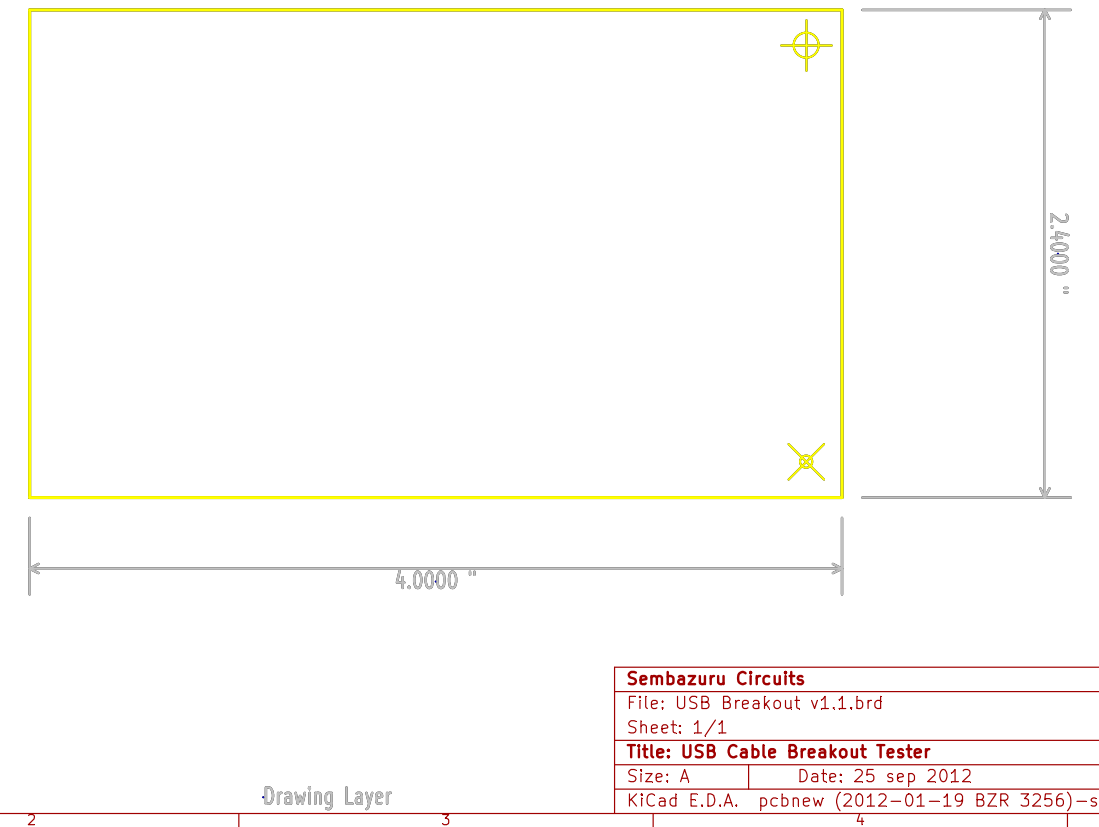
[picture p98: page 5]
