Sembazuru/USB-breakout/USB  breakout board v1.2.pdf

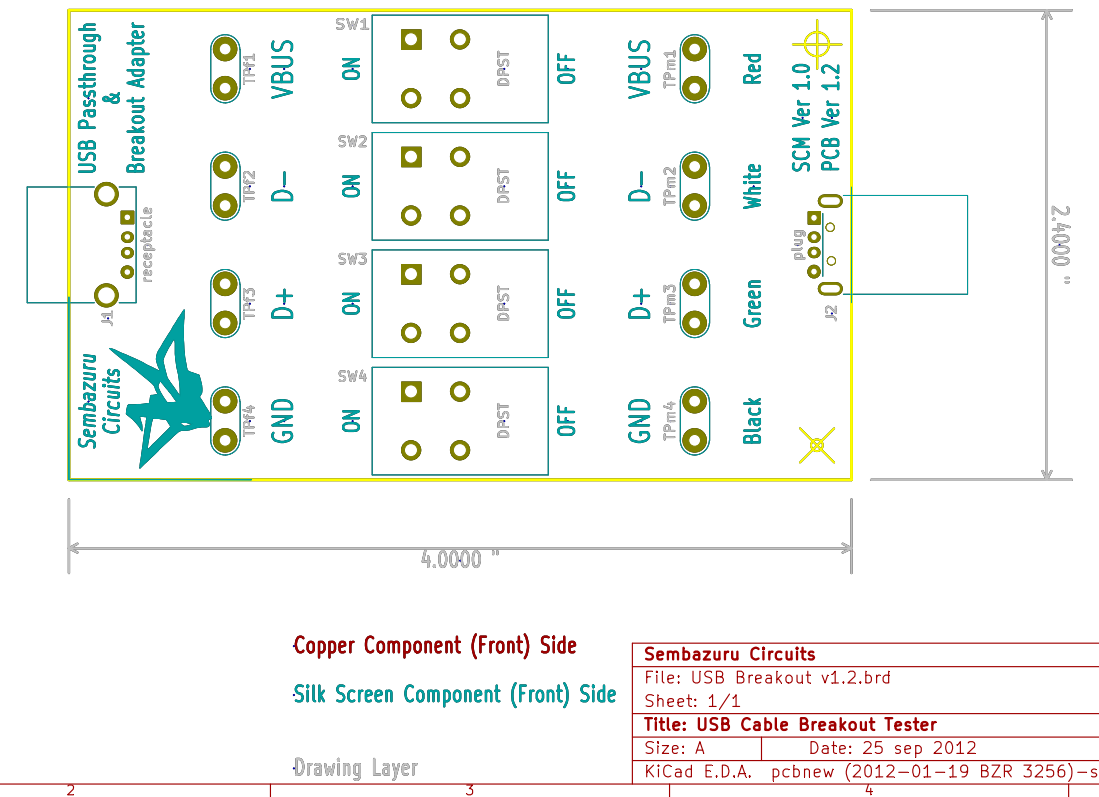
[picture p99: page 1]

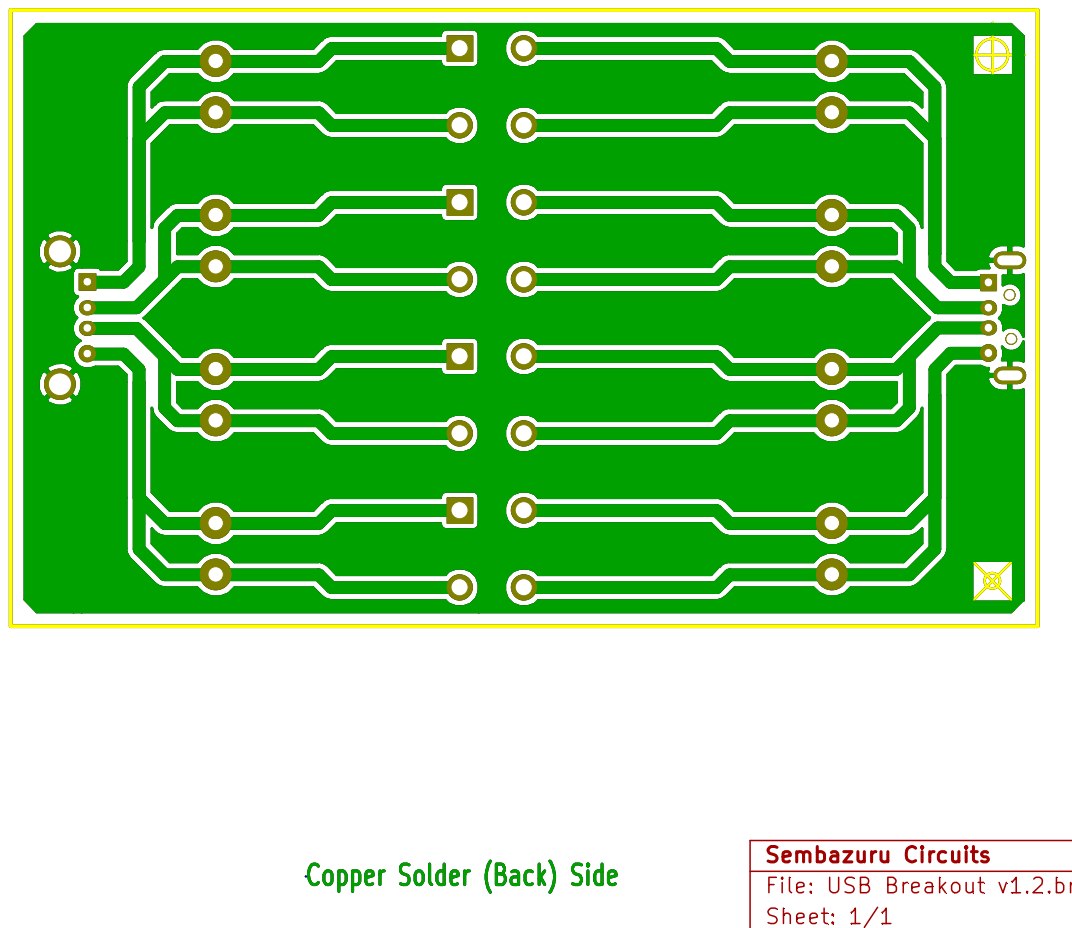
[picture p100: page 2]

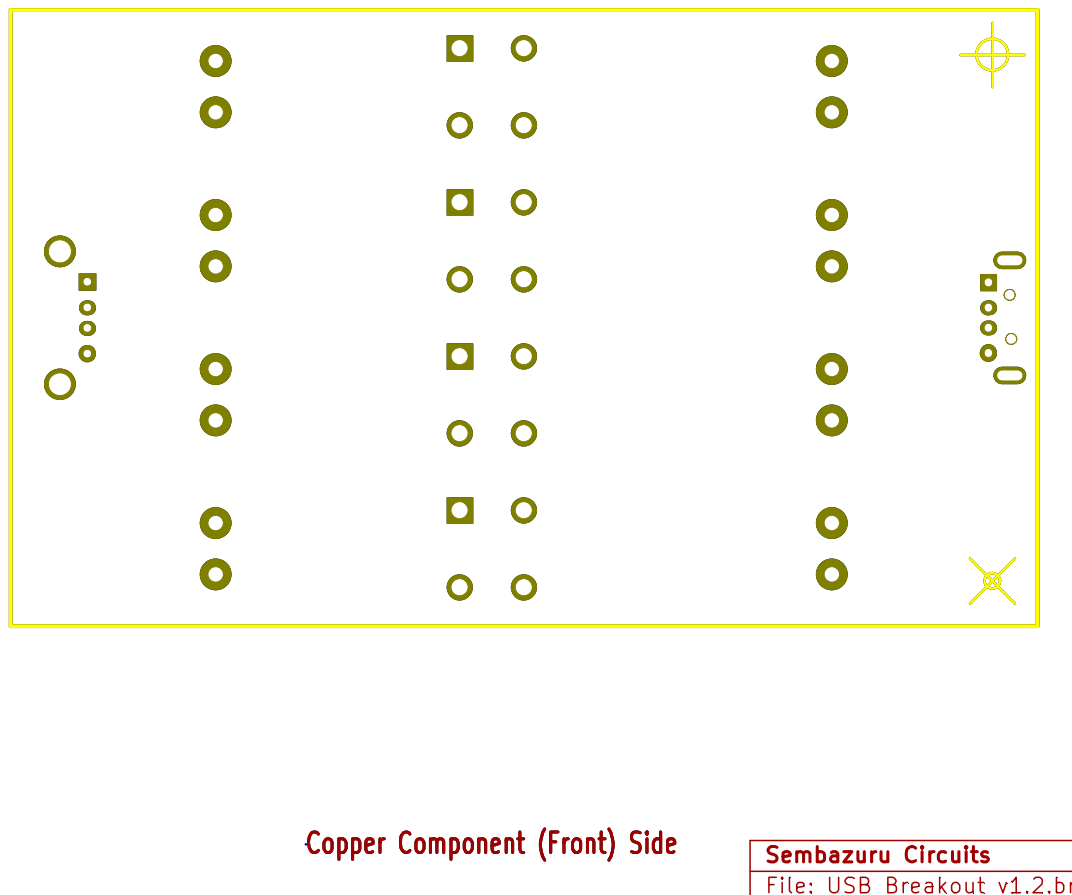
[picture p101: page 3]

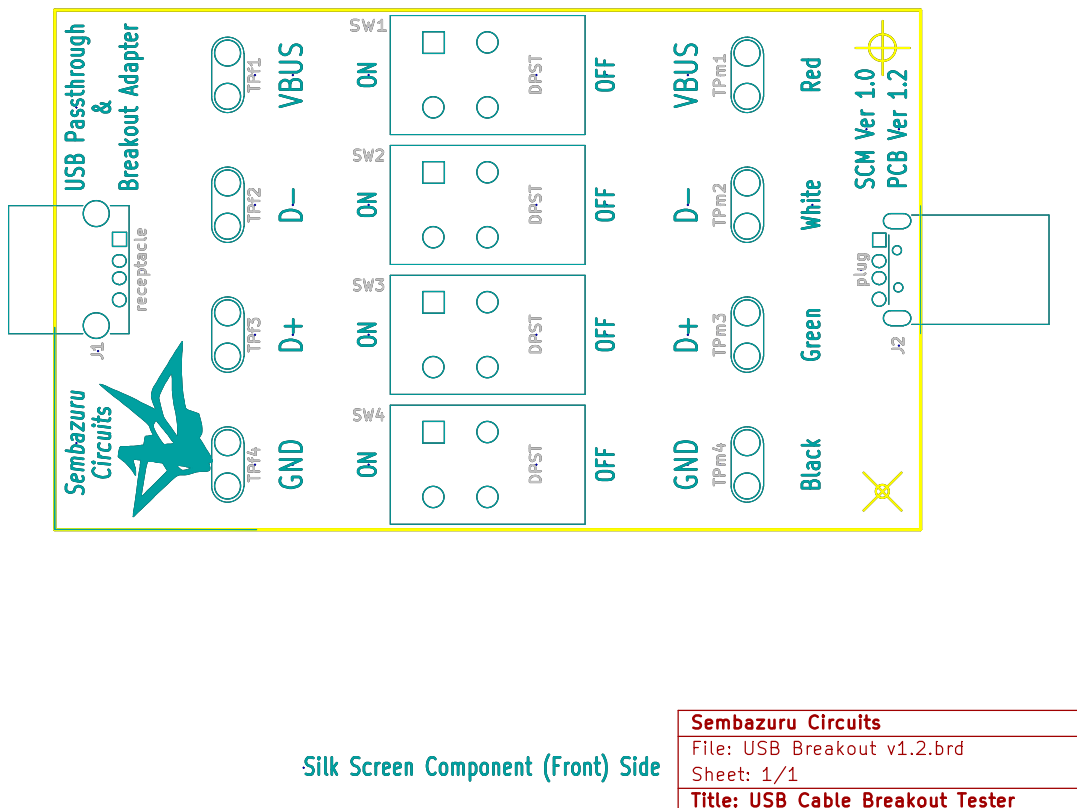
[picture p102: page 4]

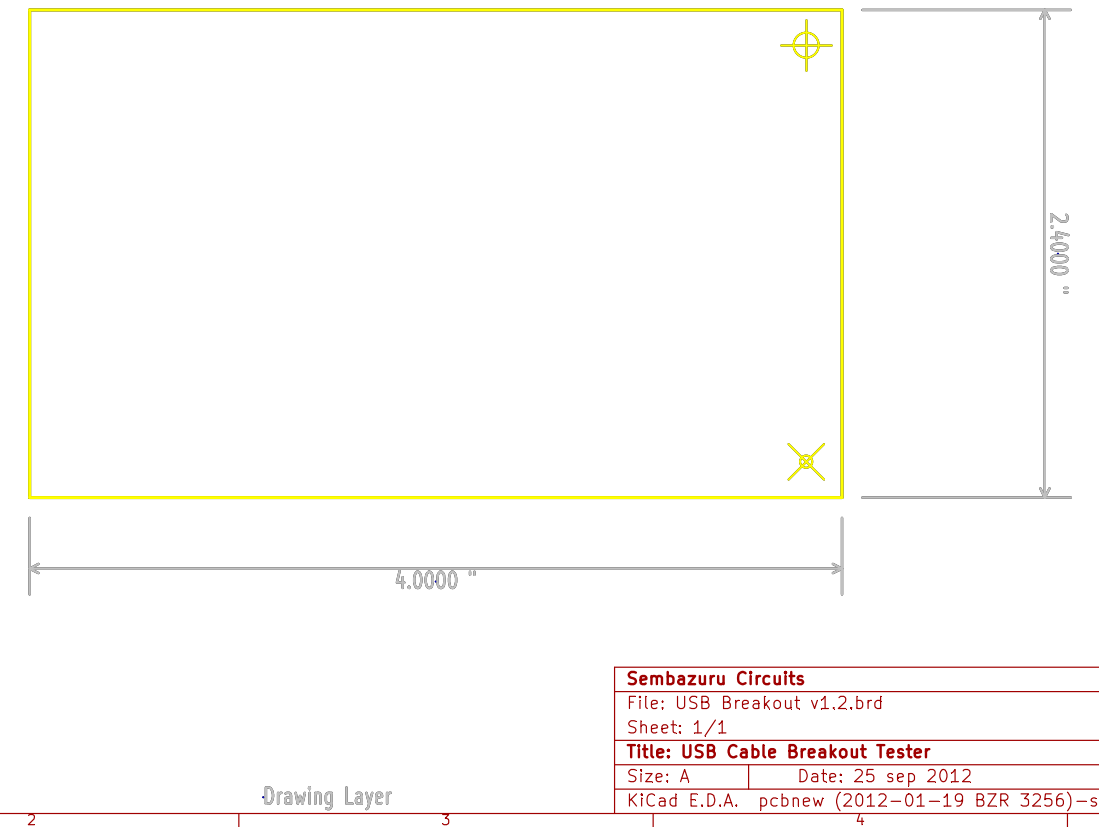
[picture p103: page 5]
