Sembazuru/USB-breakout/USB  breakout board v1.3.pdf

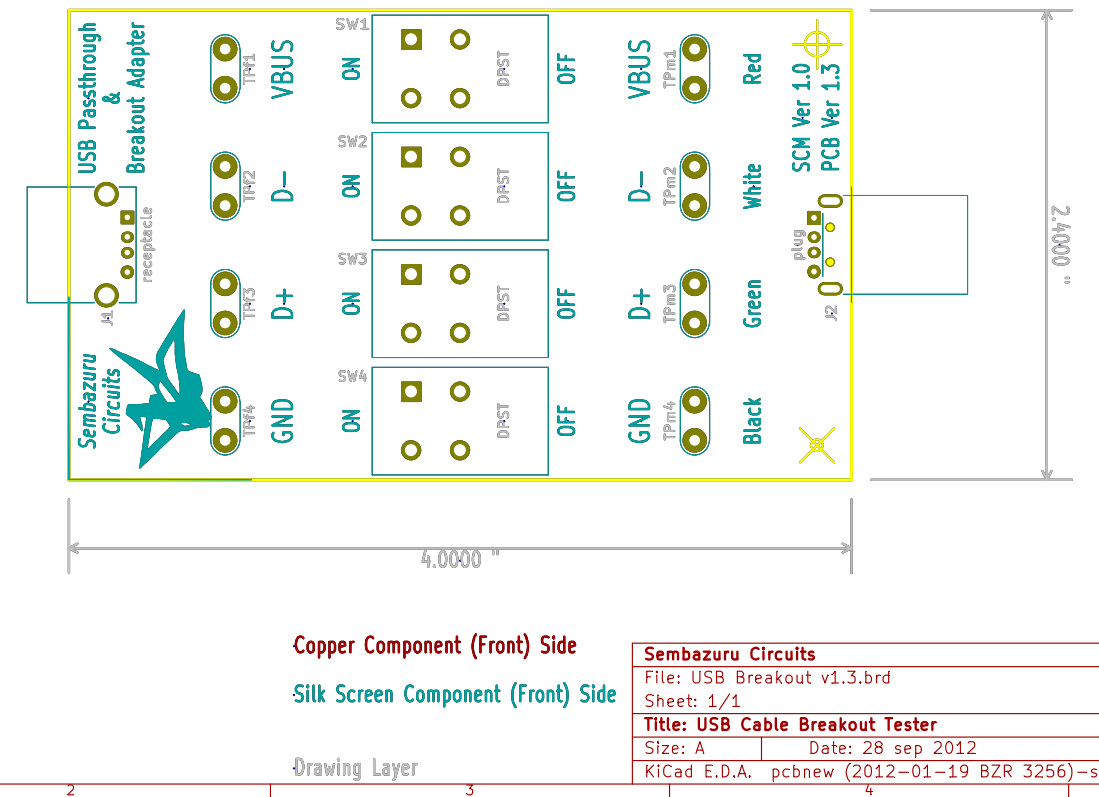
[picture p104: page 1]

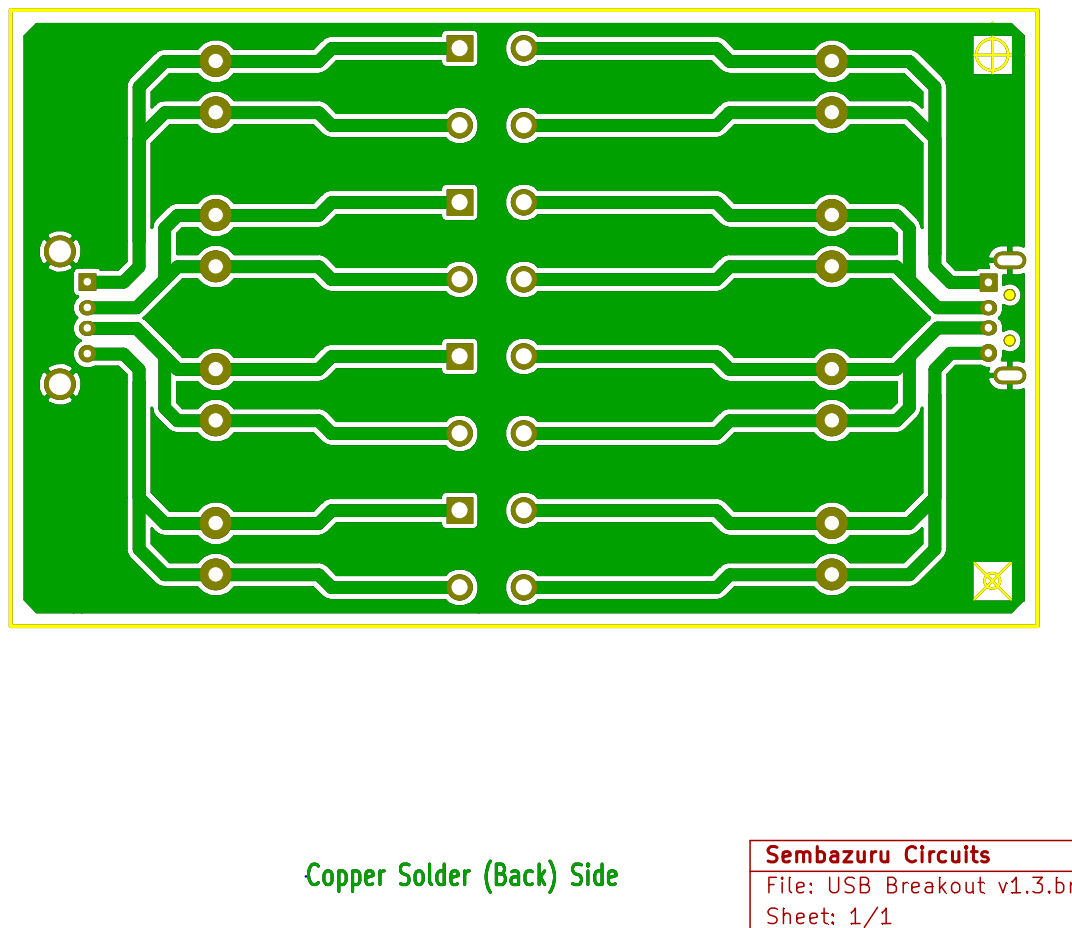
[picture p105: page 2]

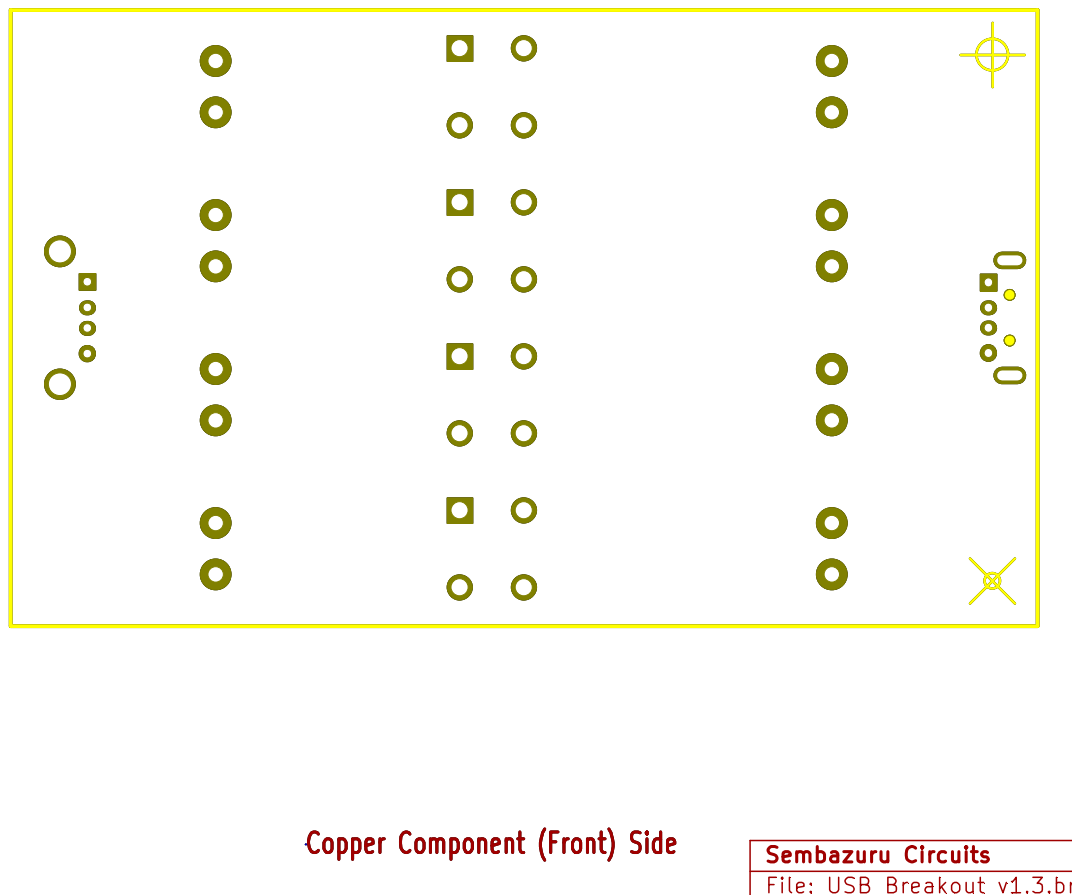
[picture p106: page 3]

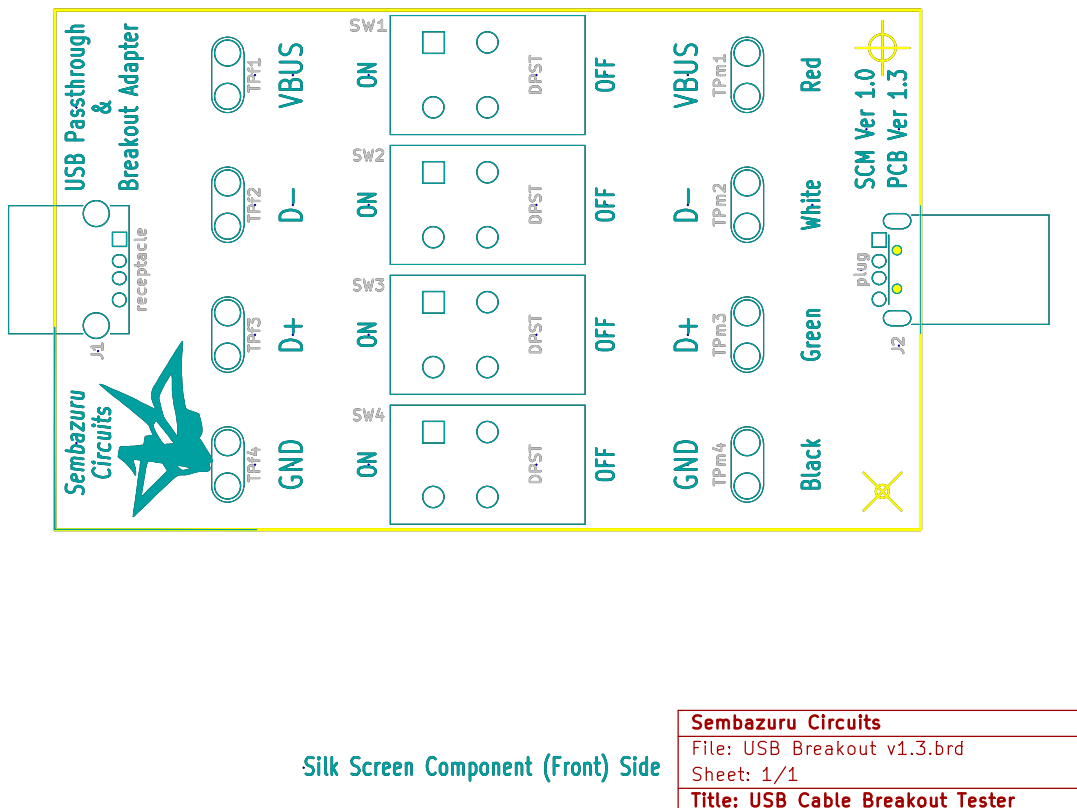
[picture p107: page 4]

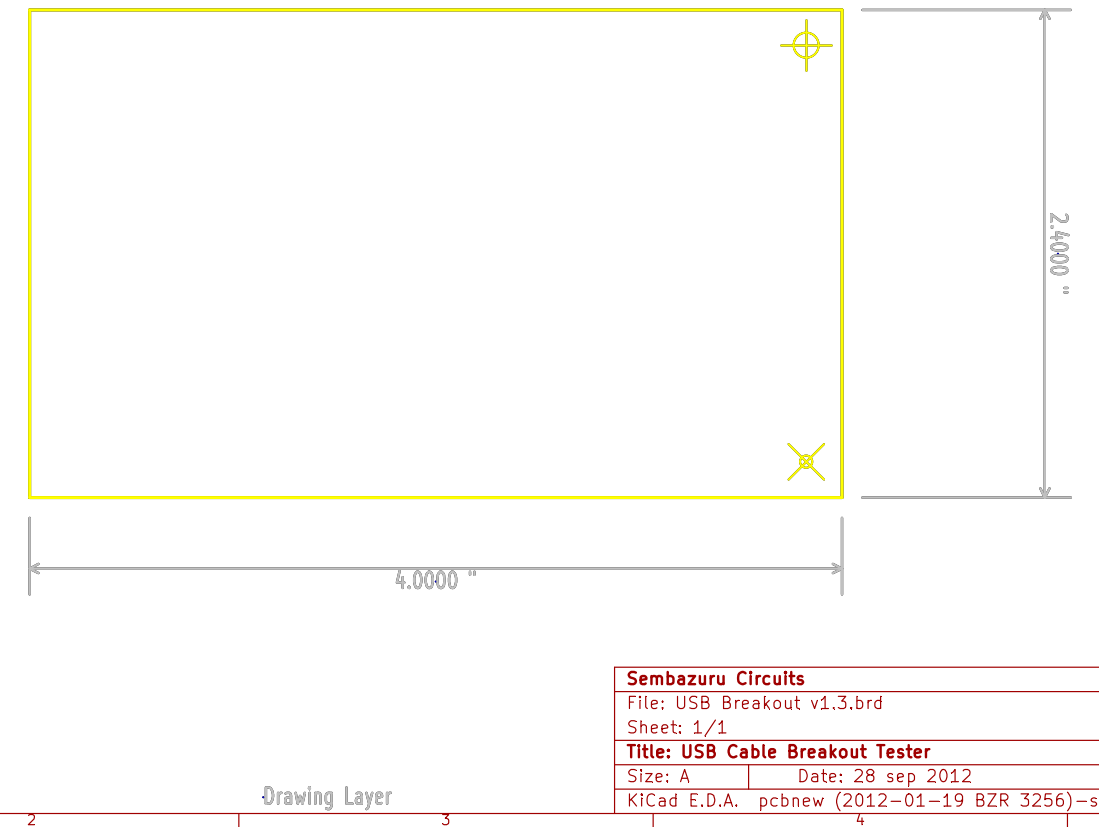
[picture p108: page 5]
