Sembazuru/USB-breakout/USB Breakout v2.0.kicad_pcb

## KiCad design USB Breakout v2.0.kicad_pcb (2021-04-01, an earlier design)

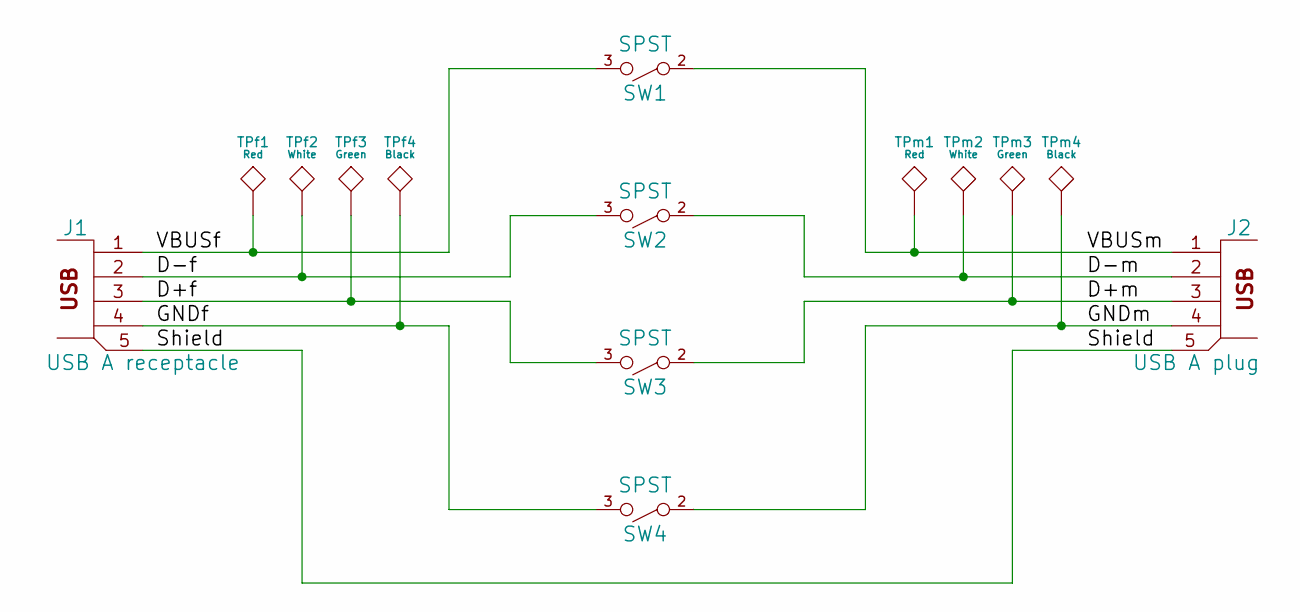
[picture p111: schematic USB Breakout v2.0.sch, USB Cable Breakout Tester]

Parts:
J1: USB A receptacle; TYCO_292303-1; MFG# 292303-1
J2: USB A plug; MOLEX_48037-0001; MFG# 48037-0001
SW1, SW2, SW3, SW4: SPST; SW_Jameco2135478; MFG# T100T1B4A2
TPf1: Red; TESTPOINT; MFG# 5010
TPf2: White; TESTPOINT; MFG# 5012
TPf3: Green; TESTPOINT; MFG# 5126
TPf4: Black; TESTPOINT; MFG# 5011
TPm1: Red; TESTPOINT; MFG# 5010
TPm2: White; TESTPOINT; MFG# 5012
TPm3: Green; TESTPOINT; MFG# 5126
TPm4: Black; TESTPOINT; MFG# 5011

Connections:
/D+f: J1.3, SW3.3, TPf3.1
/D+m: J2.3, SW3.2, TPm3.1
/D-f: J1.2, SW2.3, TPf2.1
/D-m: J2.2, SW2.2, TPm2.1
/GNDf: J1.4, SW4.3, TPf4.1
/GNDm: J2.4, SW4.2, TPm4.1
/Shield: J1.5, J2.5
/VBUSf: J1.1, SW1.3, TPf1.1
/VBUSm: J2.1, SW1.2, TPm1.1

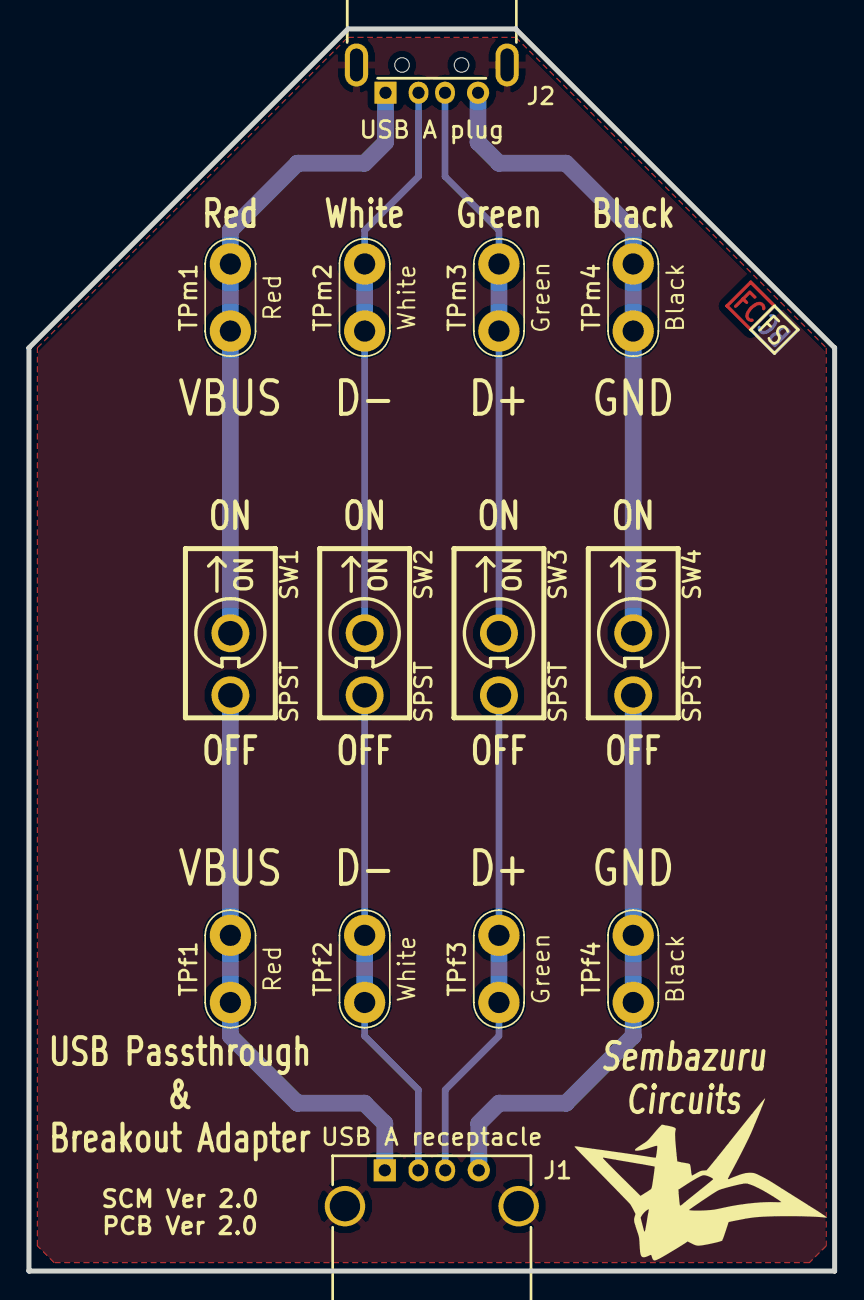
[picture p112: board USB Breakout v2.0.kicad_pcb from above]

Board: 2 copper layers, 61.0 x 94.0 mm, 15 parts (0 on the bottom side), 9 nets.

Other parts of the board:
LayerIcon02: VAL**; LayerIcon02
