Sembazuru/USB-breakout/USB Breakout v1.0.sch

## KiCad design USB Breakout v1.0.sch (2021-04-01, an earlier design)

Schematic: USB Breakout v1.0.sch

Parts:
J1: USB A recepticle; TYCO_292303-1; MFG# 292303-1
J2: USB A plug; MOLEX_48037-0001; MFG# 48037-0001
SW1, SW2, SW3, SW4: DPST; SW_S201031MS02Q; MFG# S201031MS02Q
TPf1: VBUSf; TESTPOINT; MFG# 5012
TPf2: D-f; TESTPOINT; MFG# 5012
TPf3: D+f; TESTPOINT; MFG# 5012
TPf4: GNDf; TESTPOINT; MFG# 5012
TPm1: VBUSm; TESTPOINT; MFG# 5012
TPm2: D-m; TESTPOINT; MFG# 5012
TPm3: D+m; TESTPOINT; MFG# 5012
TPm4: GNDm; TESTPOINT; MFG# 5012
