Sembazuru/USB-breakout/USB Breakout v3.0.sch

## KiCad design USB Breakout v3.0.sch (2021-04-01)


Parts:
J1: USB 3.0 Plug; Amphenol_GSB316441CEU
J2: USB 3.0 Receptacle; Amphenol_GSB311131HR
SW1, SW4: SPST; SW_Jameco2135478U
SW2, SW5, SW8: 2xSPST; DIPSW762W57P254L608H570Q4U
TPf1: Red; TESTPOINT
TPf2: White; TESTPOINT
TPf3: Green; TESTPOINT
TPf4: Black; TESTPOINT
TPf5: Blue; TESTPOINT
TPf6: Yellow; TESTPOINT
TPf8: Purple; TESTPOINT
TPf9: Orange; TESTPOINT
TPm1: Red; TESTPOINT
TPm2: White; TESTPOINT
TPm3: Green; TESTPOINT
TPm4: Black; TESTPOINT
TPm5: Blue; TESTPOINT
TPm6: Yellow; TESTPOINT
TPm8: Purple; TESTPOINT
TPm9: Orange; TESTPOINT

Connections:
SSDrain: J1.7, J2.7
Shield: J1.0, J2.0
fD+: J2.3, SW2.2, TPf3.1
fD-: J2.2, SW2.1, TPf2.1
fGND: J2.4, SW4.3, TPf4.1
fSSRX+: J2.6, SW5.1, TPf6.1
fSSRX-: J2.5, SW5.2, TPf5.1
fSSTX+: J2.9, SW8.1, TPf9.1
fSSTX-: J2.8, SW8.2, TPf8.1
fVBUS: J2.1, SW1.3, TPf1.1
mD+: J1.3, SW2.3, TPm3.1
mD-: J1.2, SW2.4, TPm2.1
mGND: J1.4, SW4.2, TPm4.1
mSSRX+: J1.6, SW5.4, TPm6.1
mSSRX-: J1.5, SW5.3, TPm5.1
mSSTX+: J1.9, SW8.4, TPm9.1
mSSTX-: J1.8, SW8.3, TPm8.1
mVBUS: J1.1, SW1.2, TPm1.1

Notes on the sheet:
To Host
To Device
